darkvolg/BeehiveScale-ESP32/hardware/pinout.md

# BeehiveScale ESP32 — Полная распиновка

**Версия:** v5.0.15
**Плата:** ESP32-WROOM-32 DevKit V1 (38 пинов, USB-C, DOIT)
**Дата:** 2026-05-07

---

## 1. Сводная таблица ESP32 GPIO

Все занятые пины ESP32. Свободные не показаны.

| ESP32 пин | GPIO | Куда идёт | Сигнал | Тип | Цвет провода | Примечание |
|---|---|---|---|---|---|---|
| 25 | **GPIO16** | HX711 → DT | DATA in | digital | **жёлтый** | свободный, не strapping |
| 28 | **GPIO17** | HX711 → SCK | CLOCK out | digital | **зелёный** | свободный |
| 26 | **GPIO4** | DS18B20 → DATA | 1-Wire | digital | **белый** | + 4.7 kΩ pullup на 3.3V |
| 11 | **GPIO27** | Кнопка MAIN → IN | input pullup | digital | **синий** | RTC GPIO ⭐ (wake-by-button) |
| 10 | **GPIO26** | Кнопка MENU → IN | input pullup | digital | **голубой** | RTC GPIO |
| 33 | **GPIO21** | LCD SDA + DS3231 SDA | I²C SDA | I²C | **зелёный** | общая шина |
| 36 | **GPIO22** | LCD SCL + DS3231 SCL | I²C SCL | I²C | **жёлтый** | общая шина |
| 13 | **GPIO33** | DS3231 SQW *(опц.)* | wake input | digital | **фиолетовый** | RTC GPIO. Задел на фазу P3 — в прошивке v5.0.15 не задействован |
| 6 | **GPIO34** | Делитель батареи (midpoint) | ADC input | analog | **серый** | input only, ADC1_CH6 |
| 1 | **3V3** | HX711 VCC, DS3231 VCC, DS18B20 VCC, R-pullup | питание | 3.3V | **красный** | от LDO ESP32 (~600 мА запас) |
| 2 | **VIN** | вход 5V от AS21 V6.0 | питание | 5V | **оранжевый** | через AMS1117 → 3.3V LDO |
| 3 | **GND** (любой) | общая земля всех модулей | земля | GND | **чёрный** | минимум 2 GND-провода (один общий plane) |

> **Важно:** ESP32 DevKit V1 имеет несколько GND-пинов (4, 14, 32, 38). Используй ближайший к каждому модулю чтобы петли не плодились.

---

## 2. По-компонентно — куда что паять

### HX711 (Load Cell ADC, 3.3V)

| HX711 пин | Куда | Цвет провода | Примечание |
|---|---|---|---|
| **VCC** | ESP32 **3V3** | красный | потребляет ~1.5 мА |
| **GND** | ESP32 **GND** | чёрный | |
| **DT** (data) | ESP32 **GPIO16** | жёлтый | подтяжки не нужны |
| **SCK** (clock) | ESP32 **GPIO17** | зелёный | |
| **E+** | load cell **красный** | — | питание тензодатчика |
| **E−** | load cell **чёрный** | — | |
| **A+** | load cell **зелёный** | — | сигнал |
| **A−** | load cell **белый** | — | |

> Иногда тензодатчики имеют другие цвета (КНР). Проверь маркировку на коробке. На v3 датчиках типа TAL220: **красный/чёрный = питание (E+/E−), зелёный/белый = сигнал (A+/A−)**.

---

### LCD 16×2 I²C (PCF8574 backpack, 5V, адрес 0x27)

| LCD пин | Куда | Цвет провода | Примечание |
|---|---|---|---|
| **VCC** | ESP32 **VIN** (5V) | оранжевый | LCD требует 5V для подсветки |
| **GND** | ESP32 **GND** | чёрный | |
| **SDA** | ESP32 **GPIO21** | зелёный | общая I²C шина |
| **SCL** | ESP32 **GPIO22** | жёлтый | общая I²C шина |

> Если LCD не запускается на 5V (ESP32 GPIO 3.3V уровни) — скорее всего PCF8574 проглатывает 3.3V на SDA/SCL без проблем. Если есть глюки — поставь level shifter (2× MOSFET BSS138 с 10 kΩ pullup).

---

### DS3231 RTC (3.3V, адрес 0x68, общая I²C шина с LCD)

| DS3231 пин | Куда | Цвет провода | Примечание |
|---|---|---|---|
| **VCC** | ESP32 **3V3** | красный | НЕ 5V! Иначе модуль может попытаться зарядить CR2032 через диод (запрещено для не-перезаряжаемой батарейки) |
| **GND** | ESP32 **GND** | чёрный | |
| **SDA** | ESP32 **GPIO21** | зелёный | общая I²C шина с LCD |
| **SCL** | ESP32 **GPIO22** | жёлтый | общая I²C шина с LCD |
| **SQW** (INT) *(опц.)* | ESP32 **GPIO33** | фиолетовый | RTC alarm output. **Задел на P3** — wake by alarm, в v5.0.15 не используется. Паяй сейчас чтобы потом не перепаивать |
| 32K | NC | — | не используется |
| RST | NC | — | не используется |

> **Важно у Геннадия выпаян Power LED на DS3231** — иначе CR2032 садилась за неделю (LED жгла ~200 мкА постоянно).
> На модуле есть **R5 SMD-резистор** в цепи зарядки CR2032 (для Li-ion). Если у тебя обычная **не-перезаряжаемая** CR2032 — выпаяй R5 (или диод) чтобы не было тока заряда. Проверь перед запайкой — если шёлкография говорит «D1» с диодом перед батарейкой, удалить.

---

### DS18B20 (Temperature Sensor, TO-92, 1-Wire, 3.3V)

| DS18B20 пин (вид на маркировку) | Куда | Цвет провода | Примечание |
|---|---|---|---|
| **1 — GND** (левый) | ESP32 **GND** | чёрный | |
| **2 — DATA** (центр) | ESP32 **GPIO4** | белый | + 4.7 kΩ pullup на 3.3V (обязательно!) |
| **3 — VCC** (правый) | ESP32 **3V3** | красный | |

> **Распиновка** (TO-92 плоской стороной к себе, ножки вниз):
> - Левая = GND
> - Средняя = DATA
> - Правая = VCC
>
> **Pullup-резистор 4.7 kΩ** обязателен между DATA и VCC. Без него датчик не отвечает.
>
> Если кабель к датчику длинный (>1м, например в улье) — ставь pullup ближе к датчику, не к ESP32.

---

### Кнопки тактовые (2 шт, 6×6 мм)

Подключение по схеме «GPIO → кнопка → GND», внутренний pullup в ESP32 включён программно.

| Кнопка | GPIO | Цвет провода | Тип | Длительности (v5.0.15) |
|---|---|---|---|---|
| **MAIN** | **GPIO27** | синий | RTC GPIO ⭐ | SHORT=ничего, MEDIUM 3.0s = ТАРА, LONG 6.0s = КАЛИБРОВКА |
| **MENU** | **GPIO26** | голубой | RTC GPIO | SHORT=меню next, LONG 2.5s = меню OK/back |

```
   ESP32 GPIO27 ──┐
                  │
              [BTN MAIN]
                  │
   ESP32 GND   ──┘
```

> **Кнопка MAIN на GPIO27 = RTC GPIO** — поэтому она будит ESP из deep sleep (через `esp_sleep_enable_ext0_wakeup`).
> **Без анти-дребезга** на железе — программная фильтрация в `Button.cpp` (debounce 30 мс через ISR).

---

### Делитель напряжения батареи (для мониторинга 18650)

```
   BAT+ (raw 18650, 3.0–4.2V) ──┬── R1 (100 kΩ)
                                │
                                ├── ESP32 GPIO34 (ADC)
                                │
                                ├── R2 (100 kΩ)
                                │
                                └── GND
```

| Компонент | Значение | Куда |
|---|---|---|
| **R1** | 100 kΩ (1%, 0805 SMD или TH 1/4W) | BAT+ → midpoint |
| **R2** | 100 kΩ (1%, 0805 SMD или TH 1/4W) | midpoint → GND |
| midpoint | — | ESP32 **GPIO34** |

> **Деление 1:1** (4.2V → 2.1V на пине, в пределах ADC1 ESP32 при `ADC_11db` attenuation = 0–3.3V).
> **Ток утечки делителя:** 4.2V / 200kΩ = **21 мкА постоянно**. Заметно для deep sleep, но ОК.
> Если хочешь убрать утечку в sleep — можно поставить P-MOSFET (но мы вычеркнули его).

---

### AS21 V6.0 — питание (TP4056 + Boost 5V + 18650 holder)

Это **внешний модуль**, не на основной плате. Соединяется 3-проводным разъёмом (или 4 если с BAT+).

| AS21 выход | Куда на основной плате | Цвет провода | Примечание |
|---|---|---|---|
| **5V_OUT** | ESP32 **VIN** | оранжевый | 5V после boost-преобразователя |
| **GND** | ESP32 **GND** | чёрный | общая земля |
| **BAT+** (raw 18650) | вход делителя R1+R2 | красный | прямое напряжение банки 3.0–4.2V (для ADC мониторинга) |

> AS21 V6.0 имеет:
> - TP4056 для зарядки от microUSB
> - DW01 protection IC (over-discharge / over-current)
> - Boost step-up 5V (для питания LCD)
> - Held 18650 (контактные пружины)
>
> **Микро-USB модуля AS21** = вход для зарядки 18650. **USB-C на ESP32 DevKit** = вход для прошивки/отладки. Эти два USB **независимы** — можно подключать оба одновременно.

---

## 3. Питание — кто откуда берёт

```
                              ┌── 5V → LCD VCC
                              │
   AS21 5V_OUT ──→ ESP32 VIN ─┤
                              │
                              └── ESP32 internal AMS1117 LDO ──→ 3.3V
                                                                    │
                                                                    ├── HX711 VCC
                                                                    ├── DS3231 VCC
                                                                    ├── DS18B20 VCC
                                                                    └── 4.7kΩ pullup на DATA

   AS21 BAT+ ──→ R1 (100k) ──→ midpoint → ESP32 GPIO34 (ADC)
                                  │
                                  └── R2 (100k) → GND
```

**Потребление по току (актуально на 2026-05-07):**

| Состояние | Ток | Примечание |
|---|---|---|
| ESP32 active + WiFi | 80–90 мА | при отправке Telegram |
| ESP32 active + WiFi idle | 30–50 мА | дашборд открыт |
| LCD backlight + LCD логика | ~30 мА | постоянно когда плата работает |
| HX711 active | ~1.5 мА | |
| DS3231 (без LED) | ~110 мкА | от батарейки CR2032 в основном |
| DS18B20 active | ~1 мА (read) / 1 мкА idle | |
| **Всего active** | **~120–140 мА** | через AS21 boost |
| **Deep sleep (с AMS1117)** | **~7 мА** | замерено мультиметром |
| Deep sleep (после HT7333) | ~3 мА | ожидаемо после замены |

---

## 4. ⚠️ ЗАПРЕЩЁННЫЕ пины ESP32

**НЕ ИСПОЛЬЗУЙ**:

| GPIO | Почему |
|---|---|
| 6, 7, 8, 9, 10, 11 | внутренняя SPI flash ESP32 — НИКОГДА (плата перестанет загружаться) |
| 0, 2, 12, 15 | strapping pins — осторожно, могут влиять на boot. Можно использовать но не для постоянных нагрузок (например подтяжек к VCC). |
| 1 (TX0), 3 (RX0) | UART0 — занят USB-сериал. Если паяешь TX/RX наружу для отладки — будет конфликт |
| 34, 35, 36, 39 | input only — нельзя использовать как output |

**ПОЛНОСТЬЮ СВОБОДНЫЕ (для будущих расширений):**
- GPIO 5, 13, 14, 18, 19, 23, 25, 32

---

## 5. Рекомендуемая последовательность пайки (от центра к краям)

1. **Сначала** — ESP32 на DIP-сокете (2×19 pin female, snap-off). Не паять модуль напрямую — иначе на отладке намучаешься.
2. **Питание** — AS21 разъём, 5V→VIN, GND→GND. Проверь мультиметром: на VIN должно быть ~5V, на 3V3 — 3.3V.
3. **Делитель батареи** — R1+R2, midpoint к GPIO34. Проверь напряжение: при 18650=4.0V на пине должно быть 2.0V.
4. **HX711** — короткие провода, лучше скруткой. После пайки запусти прошивку и проверь сырые показания через `/api/data` (поле `weight`).
5. **LCD I²C** — VCC=5V, GND, SDA, SCL. Подсветка должна включиться сразу. Если контраст плохой — крути потенциометр на backpack.
6. **DS3231** — на ту же I²C шину. Проверь через `/api/data` (поле `datetime` показывает время).
7. **DS18B20** — обязательно с 4.7 kΩ pullup. Проверь через `/api/data` (поле `temp`).
8. **Кнопки** — GPIO к одному контакту, GND к другому. Полярность не важна.

**После каждого шага — прошивай и тестируй**, не оставляй непроверенные соединения.

---

## 6. Полезные мнемоники

- **MAIN на GPIO27**: запомни «**M**AIN — **2 7**» (две семёрки). Это RTC GPIO, поэтому он и будит из сна.
- **HX711 на 16/17**: пара рядом, как I²C-шина (21/22).
- **I²C — это G21/G22**: жёлтый (SCL) выше зелёного (SDA) физически на ESP32 DevKit.
- **DS18B20 — белый провод**: 1-Wire = 1 провод данных = белый. Питание красное, GND чёрный — стандарт.

---

## 7. Что заказать дополнительно (если ещё не куплено)

- [ ] DIP-сокет 2×19 (snap-off можно от 2×20) — ~30 ₽
- [ ] Резисторы 100 kΩ ×2 (1%, 1/4W) — копейки
- [ ] Резистор 4.7 kΩ ×1 — копейки
- [ ] Тактовые кнопки 6×6 мм ×2 — копейки
- [ ] Female pin headers под LCD/HX711/DS3231 — на «съёмные» модули
- [ ] **HT7333 LDO** (SOT-89) — для замены AMS1117. Заказан, придёт ~9 мая.
- [ ] Корпус IP65 ~85×65×30 мм
- [ ] 18650 банка 3000+ мА·ч (если ещё нет)

---

**Файлы по теме:**
- [pcb_layout_v1.excalidraw](pcb_layout_v1.excalidraw) — визуальный layout платы
- `BeehiveScale/Connectivity.h` / `BeehiveScale/Memory.h` — defines в коде

**Дата актуализации:** 2026-05-07 (после v5.0.15)
