darkvolg/BeehiveScale-ESP32/ACTION_PLAN.md

# BeehiveScale — План восстановления (2026-05)

**Цель:** довести весы до рабочего состояния и поставить в улей.
**Заказчик:** Геннадий Якубовский (пасека на 11 ульев).
**Текущая боль:** весы постоянно показывают неправильный вес, плохо калибруются, лежат на полке.

---

## START HERE — приоритеты

### 🔴 ФАЗА 1 (P0) — Восстановление точности веса
**Почему P0:** без правильного веса всё остальное бессмысленно. Корневая причина — пины HX711 (GPIO16/GPIO1 неправильные, нужно D5/D6) **+ как выяснилось 2026-05-03 — HX711 модуль умер**.

- [x] Найдена корневая причина — пины HX711 на boot-strap GPIO + отсутствие pull-up на GPIO16
- [x] Сравнение с эталоном Bee_Lite_D1 (Як Иваныч) — у него HX711 на D5/D6, работает
- [x] Веб-исследование — стандартная распиновка HX711+ESP8266 = D5/D6
- [x] Правки в коде v4.2.1: DT_PIN=14, SCK_PIN=12, упрощён Scale.cpp, удалены костыли
- [x] SD-карта отключена, логи в LittleFS (D5/D6/D7/D8 освобождены от SPI)
- [x] LOG_INTERVAL_MS = 30 мин (fallback) + расписание через веб
- [x] Сборка прошла: RAM 46%, IRAM 95%, Flash 56%
- [x] Геннадий переключил коннекторы HX711 на D5/D6
- [x] Геннадий прошил v4.2.1 → v4.2.2 → v4.2.3
- [x] **2026-05-03: Диагностика — HX711 модуль не реагирует на нагрузку** (90 кг → 0 реакции). Воспроизведено на 2 распиновках (D5/D6 и D0/TX) и 2 разных тензодатчиках. Вывод: **HX711 модуль мёртв**, нужна замена.
- [x] 🛒 **Геннадий: купить новый HX711 модуль** (50-150₽, любой Озон/Ali/радиорынок) — 2026-05-04 куплен
- [x] (опционально) подтвердить мультиметром: E+ к E- должно быть ~3.3В, у мёртвого 0В — пропущено, сразу замена
- [x] Установить новый HX711, провода: 3V3→VCC, GND→GND, DT→D5, SCK→D6 — 2026-05-04
- [x] Прошить финальную v4.2.3 (LEGACY_HX711_PINS должен быть выключен) — 2026-05-04
- [x] Калибровка 1 кг через меню — 2026-05-04 ОК, весы работают
- [ ] **Геннадий: настроить расписание через веб** (например `21:00`)
- [ ] Тест T1: стабильность в покое 30 мин — разброс < 50 г
- [ ] Тест T2: повторяемость калибровки на 1 кг гире 5 раз с reboot — отклонение < 5%
- [ ] Тест T3: линейность 0.5 / 2 / 5 кг — точность 2%
- [ ] Калибровка финальная под реальный груз улья (можно использовать гирю до 50 кг)

**Завершение Фазы 1:** все три теста PASS → весы можно ставить в улей с питанием от блока 5В.

---

### 🟡 ФАЗА 2 (P1) — Автономия от 18650 (DEEP_SLEEP) — 🚫 БЛОКЕР
**Почему P1:** без автономии весы в улье требуют сетевого питания, что не везде возможно.

**🚫 СТАТУС 2026-05-05: ЗАСТРЯЛИ.** ESP не просыпается из deep sleep ни через GPIO16 timer wake, ни через DS3231 alarm. Все стандартные подходы (диод, прямой провод, 100нФ cap) исчерпаны.

**Что подтверждено как работающее:**
- ✅ Код v4.2.12 уходит в deep sleep корректно
- ✅ DS3231 alarm срабатывает (A1F=1, SQW падает 4.8В→0В) — проверено мультиметром и AlarmCheck скетчем
- ✅ Электрические соединения целы (мультиметр звонится)

**Что НЕ работает:**
- ❌ GPIO16 → RST: ESP не просыпается даже от внутреннего timer wake (минимальный WakeTest скетч застревает на Wake #1)
- ❌ SQW → RST: с прямым проводом / диодом / cap 100nF — ESP не реагирует на алярм-сигнал

**Идеи для возобновления (см. memory/lightrag для деталей):**
- [ ] Попробовать новый NodeMCU (Геннадий готов поменять)
- [ ] MOSFET power gating: P-channel MOSFET на VCC ESP, gate от SQW. ESP включается «с нуля» по будильнику, без RST
- [ ] Schottky диод 1N5819 + 100нФ cap параллельно (edge-trigger)
- [ ] Перейти на ESP32 (wake-on-EXT надёжнее)
- [ ] Web search «DS3231 wake ESP8266 deepSleep(0) 100nF» — проверенные схемы

**Замороженные пункты Фазы 2 (после разблокировки):**
- [ ] Кнопка пробуждения: использовать встроенную кнопку RST на NodeMCU
- [ ] (Опционально) MOSFET P-channel для отключения LCD power 5В во сне
- [ ] Замер реального потребления в спячке (ожидаем ~0.15 мА средний)
- [ ] Тест автономии: 18650 на ~3 суток наблюдения, проверить что лог пишется в 21:00 и весы доживают

**Завершение Фазы 2:** весы работают от 18650 без сети, лог пишется раз в день.

---

### 🟢 ФАЗА 3 (P2) — Солнечная панель + длительная автономия
**Почему P2:** даёт постоянную работу без обслуживания.

- [ ] Купить солнечную панель 5W 6V (стандартная для IoT)
- [ ] Купить контроллер заряда CN3791 (MPPT для Li-Ion) или TP4056 (попроще)
- [ ] Собрать схему: панель → CN3791 → 18650 → DC-DC 5В → ESP
- [ ] Поставить в улей, наблюдать 2 недели — заряд не должен падать
- [ ] (Опционально) DS3231 alarm как wake-источник: SQW/INT → RST через диод, тогда сон сутками целиком, не часовыми кусками. ~50 строк кода. Среднее потребление падает в 30 раз.
- [ ] (Опционально) Вернуться в `SLEEP_MODE_CONTINUOUS` если панель достаточная (5W × 4ч = 20 Wh покрывает 80 мА × 24ч)

**Завершение Фазы 3:** ставишь и забываешь, веб всегда доступен (если CONTINUOUS).

---

### ⚪ ФАЗА 4 (P3) — Расширение пасеки
**Почему P3:** «нужно повторить для всех ульев».

- [ ] Собрать вторые весы по этой же схеме (для второго улья)
- [ ] Добавить в Telegram бот сводный отчёт по всем весам
- [ ] (Опционально) MQTT интеграция с Home Assistant
- [ ] Документация для повторной сборки (BOM + инструкция по пайке)

---

## 📌 Распиновка ESP8266 NodeMCU / D1 mini ПОСЛЕ перепайки

**Важно:** на плате есть подписи D0..D8 (silkscreen) и GPIO-номера. В коде используются GPIO-номера, на плате надо смотреть метки D-N.

| Пин платы | GPIO | К чему подключить | Примечание |
|---|---|---|---|
| **D5** | GPIO14 | **HX711 → DT (DOUT)** | Был на D0 — переткнуть в D5 |
| **D6** | GPIO12 | **HX711 → SCK** | Был на TX — переткнуть в D6 |
| **3V3** | — | HX711 → VCC | Уже подключено, не трогать |
| **GND** | — | HX711 → GND | Уже подключено, не трогать |
| D1 | GPIO5 | I2C SCL → LCD 1602, RTC DS3231 | Не трогать |
| D2 | GPIO4 | I2C SDA → LCD 1602, RTC DS3231 | Не трогать |
| D3 | GPIO0 | Кнопка главная (тарирование/калибровка) → GND через кнопку | Не держать при включении! |
| D4 | GPIO2 | Кнопка меню → GND через кнопку | Не держать при включении! |
| D9 / RX | GPIO3 | DS18B20 термометр (с резистором 4.7к на VCC) | Не трогать |
| TX | GPIO1 | Свободен — Serial debug (115200) | Можно подключить USB-TTL для логов |
| D7 | GPIO13 | Свободен | (был SD MOSI) |
| D8 | GPIO15 | Свободен (или можно для будущих расширений) | (был SD CS) |
| **D0** | GPIO16 | Свободен (для Фазы 2 — перемычка к RST через диод) | (была HX711 DT — снять провод!) |
| A0 | ADC0 | Делитель напряжения батареи через резисторы | Не трогать |

### SD-карта
**Отключаем.** Физически модуль можно оставить на коннекторе — он не будет использоваться. Освобождает D5/D6/D7/D8 для HX711 и будущих расширений. Логи теперь во внутренний flash ESP (LittleFS) — на годы хватит.

---

## 📋 Чек-лист перед прошивкой

1. [ ] **Снять провод HX711 DT с D0**, переткнуть в **D5**
2. [ ] **Снять провод HX711 SCK с TX**, переткнуть в **D6**
3. [ ] **VCC и GND HX711 не трогать**
4. [ ] SD-модуль можно отсоединить (не обязательно)
5. [ ] Питание подать от блока 5В через USB (для тестов, до Фазы 2)
6. [ ] В Arduino IDE:
   - Tools → Board: **LOLIN(WEMOS) D1 R2 & mini** (или твоя)
   - Tools → Flash Size: **4MB (FS:2MB OTA:~512KB)**
   - Tools → Erase Flash: **All Flash Contents** (один раз — чтобы старая FAT не мешала)
7. [ ] Прошить, дождаться boot
8. [ ] LCD должна показать splash «Vesy Pchelovod / Versiya 4.2.1»

---

## 📊 Лог выполнения

| Дата | Этап | Что сделано | Кто | Коммит |
|---|---|---|---|---|
| 2026-05-03 | P0.1 | Найдена корневая причина (пины), сравнение с Як Иванычем | Claude + agent | — |
| 2026-05-03 | P0.2 | Правки v4.2.1: HX711 на D5/D6, SD off, упрощён Scale.cpp | Claude | (не закоммичено) |
| 2026-05-03 | P0.3 | Сборка прошла, RAM 46%/IRAM 95%/Flash 56% | Claude | — |
| 2026-05-03 | P0.4 | Создан ACTION_PLAN.md с поэтапным планом | Claude | — |
| 2026-05-04 | P0.5 | Геннадий купил новый HX711, поставил, прошил v4.2.3, откалибровал на 1 кг — весы работают | Геннадий | — |
| 2026-05-05 | P1.1 | Код v4.2.10-12: LEGACY_HX711_PINS off, lcd.backlight() в check_auto_sleep, cap 70 мин на ESP8266 deepSleep | Claude | — |
| 2026-05-05 | P1.2 | ЗАСТРЯЛИ: GPIO16 wake-функция ESP8266 не работает на этой плате (электрически провода целы, мультиметр звонится). Переход на DS3231 alarm wake. | Claude+Геннадий | — |
| 2026-05-05 | P1.3 | DS3231 alarm логика подтверждена: A1F ставится в 1, SQW падает 4.8В→0В. Тесты с прямым проводом / диодом 1N4148 / 100нФ конденсатором — НИЧЕГО не будит ESP. Сессия прервана из-за выгорания. | Геннадий | — |

---

## 🚫 НЕ ТРОГАТЬ (железные правила проекта)

1. **HX711 на D5/D6** — это финальное решение. Не возвращать на D0/TX даже если кто-то скажет «там же боль с SD».
2. **I2C на D1/D2** — LCD и RTC DS3231 на одной шине, не трогать.
3. **DS18B20 на GPIO3 (RX)** — историческая распиновка, конфликта с UART RX нет (pinMode INPUT отвязывает мульти-pin).
4. **Калибровочный груз** — для лучшей точности использовать груз близкий к рабочему весу улья (10-30 кг). Минимум 1 кг гиря.
5. **Не калибровать в улье** — пчёлы летают, шум вибрации. Калибровка в гараже на ровной поверхности.
6. **EEPROM offset/cf не редактировать вручную** — только через UI калибровки или веб.
7. **SD-карта может остаться физически** — но в коде `USE_SD_CARD` закомментирован, не возвращать без очень веской причины (потеря D5/D6 для HX711).
8. **При прошивке через USB** — после перепайки GPIO16→RST (Фаза 2) убедиться что диод стоит правильно (катод к RST), иначе DTR-reset не сработает.

---

## 🔗 Ссылки

- Аудит-отчёт: [docs/reports/weight-bug-audit.md](docs/reports/weight-bug-audit.md)
- Эталон сравнения: `c:/Users/Dark/Desktop/Проекты/Весы_Як_Иваныч/firmware/Bee_Lite_D1_v1.1-1000gr.ino`
- CHANGELOG: [CHANGELOG.md](CHANGELOG.md)
- Distinguishing Pinout ESP8266: https://randomnerdtutorials.com/esp8266-pinout-reference-gpios/
- HX711 + ESP8266 туториал: https://randomnerdtutorials.com/esp8266-load-cell-hx711/
