darkvolg/BeehiveScale-ESP32/memory/project_current_state.md

---
name: project_current_state
description: BeehiveScale-ESP32 текущая версия v5.0.24 и работающие фичи на 2026-05-17
metadata:
  type: project
---

# BeehiveScale ESP32 — текущее состояние

**Версия:** v5.0.24 (2026-05-17)
**Статус:** работает на макетной сборке, корпус собран, тестируется wake-up из deep sleep
**Главный блокер:** ждём детали (1N5819, AO3401, Type-C female) для солнечной зарядки и P-MOSFET LCD

**Why:** проект для пасеки Геннадия — автономные весы которые шлют отчёты в Telegram. Тяжело пробираться через каждое железное решение — каждое прошитие через USB, не разбирая корпуса.

**How to apply:** при заходе в проект сразу читай это + project_session_2026-05-17.md чтобы понять что было сделано последнее. Не предлагай разборку корпуса — Геннадий устал. Прошивки только через USB-C.

## Железо у Геннадия (собрано в корпусе)

| Компонент | Что |
|---|---|
| MCU | ESP32-WROOM-32 DevKit V1 |
| LDO | **HT7333** (заменён AMS1117, -5 мА в sleep) |
| Boost | **MT3608** настроен на 5.0В (заменил сгоревший AS21) |
| Банка | 21700 4500 мА·ч |
| Зарядка | TP4056 + DW01 |
| Делитель | R1+R2 100k → GPIO34 (откалиброван через сайт, ratio ~2.124) |
| HX711 | + pull-up 10к на SCK (D17) → 3V3 (обязательно для sleep!) |
| LCD | 1602 I²C PCF8574 (адрес 0x27) |
| RTC | DS3231 на **3V3** (не 5В!) |
| Темп | DS18B20 + 4.7к pullup |
| Кнопки | MAIN (D27, RTC GPIO) + MENU (D26) |
| LED | **все выпаяны** (ESP32 ×2 + DS3231 ×2 + TP4056 ×2) |

## Замеры на железе

- Active: ~120 мА
- Deep sleep: **6 мА**
- Cal. Factor HX711: 20534
- Реальное напряжение батареи 4.10В (мультиметр) — откалибровано через сайт
- Автономия 21700: ~22 дня без подзарядки

## Что работает

✅ Wake по расписанию (после v5.0.24 фикса WiFi reset)
✅ Telegram отчёты через Cloudflare Worker (beehive-relay.darkvolg.workers.dev)
✅ Web-панель (192.168.0.58 в STA на Beeline роутер)
✅ Архив с маркерами аномалий + PWA
✅ Калибровка батареи через сайт (v5.0.19) — endpoint /api/battery/calib
✅ Настраиваемые Telegram-алерты (v5.0.20): батарея/температура/RTC — endpoint /api/alerts
✅ NTP отключён, DS3231 даёт время сам
✅ Pull-up SCK HX711 — HX711 в power_down полноценно (~1 мкА)
✅ Logo PCB-пчела (PWA-иконка обновлена в v5.0.18)

## Что НЕ работает / TODO (приоритет сверху)

1. **Тест v5.0.24 на стабильность** — wake-up из deep sleep исправлен, но нужен 1-2 дня наблюдений
2. **Солнечная зарядка** — ждёт детали (1N5819 Шоттки, Type-C female bulkhead)
3. **P-MOSFET для LCD off в sleep** — ждёт AO3401 (BC547 у Геннадия есть). Даст +20 дней автономии (до 44)
4. **NTP sync переписать** на esp_sntp_init() — Core 3.0.7 баг в configTime/getLocalTime
5. **Корпус IP65** — пока макетная сборка
6. **В улей** — финальный шаг

## Что Геннадий заказал

- 1N5819 (TH) + SS14 (SMD) — диоды Шоттки для солнечной панели
- AO3401 (P-MOSFET SOT-23) для P-MOSFET LCD off
- Type-C female bulkhead разъём для корпуса

Доставка 3-7 дней с Озона.

## Solar panel параметры

TZT solar panel 5В / 200мА / 1Вт (107×61мм). Подключение по схеме:
```
Panel → провод → Type-C male
              → Type-C female на корпусе
              → 1N5819 (полоска к TP4056)
              → 470µF параллельно
              → TP4056 VIN (через VBUS pin Type-C)
```

Расчёт: летом ~750-900 мА·ч/день в банку, при расходе 200 мА·ч/день → прибыль ~600 мА·ч/день. В улей с панелью — поставить и забыть на сезон.

## GitHub

- Репо публичный: github.com/darkvolg/BeehiveScale-ESP32
- 15 topics
- Логотип PCB-пчела
- Social preview banner работает (1280×640 JPG)
- README двуязычный (RU основной + EN)

## Контакты

- Wi-Fi: Beeline (домашний), pass 9044355157
- IP в локалке: 192.168.0.58
- Cloudflare Worker secret: см. BeehiveScale/secrets.h (в .gitignore)
- Telegram bot — настроен на сайте, токен в EEPROM
