darkvolg/BeehiveScale-ESP32/memory/project_session_2026_09_11.md

---
name: project-session-2026-09-11
description: "Сессия 11.09.2026 — v5.0.69 (Excel с подсветкой из весов), автономность измерена (~50 дней), разобран перехват vesy.local роутером."
metadata: 
  node_type: memory
  type: project
  originSessionId: c1eec2fc-7866-4577-82ce-6a91bddad48f
  modified: 2026-09-11T19:59:35.419Z
---

# Сессия 11.09.2026 — что сделано

Весы на момент начала: v5.0.66 → юзер прошил v5.0.68 → в конце сессии выпущена **v5.0.69** (прошивает сейчас).
IP весов: **192.168.0.4**. «Причина старта: POWERON» — боот-лупа нет, августовская проблема закрыта.

## 1. v5.0.69 — «Excel с подсветкой» прямо из весов (коммит 915053d, тег v5.0.69)

**Почему:** сначала сделали скрипт `tools/csv_to_xlsx.py`, но юзер верно заметил — скрипт живёт на одном компьютере, с другого ноутбука снова придёт безликий CSV. Значит раскраска должна быть **в прошивке**.

**Как:** `GET /api/log/xls?from=&to=` (`Logger.cpp: log_stream_xls_range()`) стримит HTML-таблицу с инлайн-стилями под именем `beehive_<период>.xls`. Excel/LibreOffice открывают как книгу и сохраняют заливку. Кнопка — вкладка Архив, блок «⬇ Скачать».

Раскраска: вес жёлтой заливкой; **новая колонка «Изм., кг»** (рост зелёным, падение красным, порог 0.05); температура 5 ступеней (<10 синяя … >35 красная); батарея зелёная >80%, жёлтая <50%, **красная ниже 3.6 В**; **новая колонка «Заряд, %»** по кривой из `Battery.cpp:53-59`.

**Компромисс:** настоящий XLSX (zip+XML) на ESP32 не собрать без heap → Excel показывает «формат не соответствует расширению», надо нажать «Да». Написано под кнопкой и в manual.html.

**Грабли при разработке:** генерация C++ кода через bash heredoc съедала escape-последовательности — `\n` внутри строкового литерала превращался в реальный перевод строки, `'\0'` в NUL-байт. Лечится записью скрипта файлом (Write) вместо heredoc. См. [[feedback-heredoc-escapes]].

## 2. Автономность — измерена, а не посчитана

Выгрузка 15.08 → 11.09.2026 (26 дней, расписание 08:00/14:00/21:00):
**4.18 В (99%) → 3.77 В (49%)** = 50% за 26 дней = **1.9% в сутки → полный цикл ~50 дней**.

Это **втрое больше** расчётных 17–19 дней. Реальное потребление в простое ~3.5 мА, а не 7 мА. Цифры в manual.html приведены к измеренным, расчёт оставлен помеченным как пессимистичный. Коммит 98b2a95.

Заряжать раз в полтора месяца. На 11.09 был 41% → хватит до начала октября.

## 3. Почему не открывался vesy.local (важно, повторится)

Симптом: `http://vesy.local` → **HTTP ERROR 503**, по IP всё работает.

Две причины, обе на компьютере юзера, весы ни при чём:
1. **Системный прокси** `127.0.0.1:10801` (xraycore / v2RayTun). В исключениях стояло `<local>` — а это в Windows «имена **без точек**». `vesy.local` содержит точку → уходил в прокси → 503. **Исправлено:** `ProxyOverride` = `<local>;127.0.0.1;localhost;*.local;192.168.*` (старое значение: `<local>;127.0.0.1;localhost`).
2. **Роутер 192.168.0.1 сам отвечает `127.0.0.200`** на любое имя с `.local` — его заглушка-блокировщик. Windows получает DNS-ответ и до mDNS дело не доходит. **Не исправлено** — нужна либо резервация DHCP + заход по IP, либо строка в `hosts`: `192.168.0.4 vesy.local`.

Плюс весы почти всегда спят (power-cut), в ARP их нет — достучаться можно только в окно 08:00/14:00/21:00 или нажав SW2.

## 4. v5.0.70 — кнопка «Весь лог CSV» не работала вообще (коммит cd6b024)

Симптом: `/api/log` без параметров → `500 Cannot open log`. Выгрузка за период работала — эта разница и указала на причину.

Веб-слой открывал файл сам: `f = LOG_FS.open(LOG_FILE, "r")`. Макрос **`LOG_FS` на ESP32 указывал на SPIFFS**, а лог пишется в **LittleFS** (`Logger.cpp: _fs_open_read()`). Остаток от времён, когда на ESP32 была SPIFFS. Файла там нет → открытие падало всегда.

Исправлено: полная выгрузка идёт через `log_stream_csv_range(cs, "", "")`, как и остальные. Макрос `LOG_FS` удалён — веб-слой больше не лезет в ФС напрямую.

**Урок:** если один путь выгрузки работает, а другой нет — сравнивать не данные, а **через какой слой** каждый идёт.

## 5. vesy.local — ПОЧИНЕНО

Обе причины устранены:
1. `ProxyOverride` = `<local>;127.0.0.1;localhost;*.local;192.168.*` (было без `*.local` — а `<local>` в Windows значит «имена без точек»).
2. В `hosts` добавлено `192.168.0.4 vesy.local` — обходит заглушку роутера (`192.168.0.1` отвечает `127.0.0.200` на любое `.local`).

Проверено: `http://vesy.local/api/data` → **401** (ответили сами весы, там basic-auth) — значит имя доходит.

**Важно:** hosts прибивает IP гвоздями. Если DHCP выдаст весам другой адрес — перестанет работать. Правильное решение на будущее — **резервация IP в роутере**. Скрипт для обновления записи: `scratchpad/add_hosts.ps1` (запускать от админа, он же обновит IP если имя уже есть).

**На другом ноутбуке `vesy.local` работать не будет** — правка локальная. Там либо тот же hosts, либо заход по IP.

## 6. Excel с подсветкой — проверено на живых данных

Юзер скачал `beehive_2026-09-05_2026-09-11.xls` с весов: предупреждение Excel → «Да» → таблица открылась раскрашенной. Вес жирным на жёлтом, изменения зелёным/красным (−0,36 / +0,13), температура градиентом, батарея с процентами. Работает как задумано.

## 7. v5.0.71 — Excel стал книгой из трёх листов (тег v5.0.71)

Юзер заметил: скрипт делал 4 листа, а весы отдавали 1. HTML-формат иначе не умеет — Excel хранит в нём каждый лист **отдельным файлом**.

Формат сменён на **SpreadsheetML 2003** (XML): несколько листов в одном файле, стили, заливки, числовые форматы — и всё это обычной печатью в поток, без библиотек. `Logger.cpp: log_stream_xlsxml_range()`.

Листы: **Сводка** (период, вес, температура, батарея, расход заряда в сутки, остаток дней, полный цикл), **Замеры** (прежняя раскраска + закрепление шапки), **По дням** (привес за сутки, мин/макс).

Собирается за **три прохода** по логу: статистику для «Сводки» надо знать до записи первого листа; «По дням» группируется на лету, потому что строки идут по возрастанию даты.

Тонкость: значения «Сводки» — строки, локаль Excel к ним не применяется, поэтому точка меняется на запятую вручную (`_ru_dec()`).

**Графиков нет** — SpreadsheetML диаграммы не поддерживает. Они остаются только в `tools/csv_to_xlsx.py`.

**Как проверялось без прошивки:** сгенерирован такой же XML на Python по реальной выгрузке + искусственные крайние случаи (мороз −5.4 °C, жара +41 °C, разряд 3.38 В), затем файл открыт **настоящим Excel через COM** (`New-Object -ComObject Excel.Application`, `Visible=$false`) и проверены имена листов, число строк и коды заливок. Приём годный для любой будущей выгрузки — см. `scratchpad/gen_xlsxml_preview.py`.

## Открытые хвосты (на конец сессии)
- **Прошить v5.0.71** — юзер прошил v5.0.69, потом вышли v5.0.70 и v5.0.71.
- `hosts` прибивает IP гвоздями → сделать **резервацию IP в роутере**. На других компьютерах `vesy.local` не работает.
- Порог алерта батареи 3.6 В — проверить глазами на вкладке TELEGRAM.
- Вариант питания (AS21 vs TP4056+MT3608) — [[project-open-question-power-variant]].
- HT7333 вместо AMS1117 — не поставлен.
