darkvolg/BeehiveScale-ESP32/memory/user_profile.md

---
name: user_profile
description: Геннадий — пчеловод-владелец BeehiveScale-ESP32, как с ним работать
type: user
---

# Геннадий

- **Email:** darkvolg86@gmail.com
- **GitHub:** darkvolg
- **Роль:** пчеловод-любитель, владелец пасеки. Сам собирает/прошивает железо, но не программист — нужно объяснять решения простым языком.
- **Уровень технический:** умеет паять, читать схемы, прошивать через Arduino IDE / PlatformIO. Понимает что такое EEPROM, Wi-Fi, MQTT — на уровне пользователя. Не пишет код сам, но грамотно ставит задачи и задаёт правильные вопросы.

## Контекст работы
- **Удалённая пасека:** уезжает на 3-7+ дней. Связь с пасекой может быть, может не быть. Если есть — раздаёт интернет с телефона.
- **Основное устройство в полевых условиях:** ТЕЛЕФОН. Не ноутбук. Всё что делается — должно быть удобно с экрана 6".
- **На ПК:** дома, обычно для прошивки и просмотра логов в Excel.

## Стиль общения
- Говорит много, длинными фразами, иногда мысли вслух — выводит идеи как разговор. Не торопить с уточнениями, дать договорить.
- Любит "пока для примера" формулировки — это значит "обсуждаем как идею, не сразу делать".
- Ценит когда предлагаешь варианты ДО реализации, объясняешь плюсы/минусы, рекомендуешь оптимальный с обоснованием.
- НЕ любит когда говоришь "сделаю как считаешь нужным" — хочет видеть твою рекомендацию ("советую вариант 1, потому что X").
- Когда говорит "поехали" / "давай" — это команда начать реализацию.

## Что Геннадий ценит в работе
- Простота развёртывания: одно-двухкнопочные операции
- Иконка на телефоне (PWA) — субъективно "как настоящее приложение" важнее облачных функций
- Понятные русские названия в UI (никаких "Δ from baseline" — пиши "От зафиксированной точки")
- Эмодзи в UI и в сообщениях — норм, помогают визуально
- Меньше настроек > больше: переиспользуем существующие пороги (alert_delta) вместо новых

## Что НЕ делать
- ~~Не лезть в manual.html / pages/*.html~~ — **отменено 16.08.2026**: юзер сам попросил сверить инструкцию с прошивкой, а потом слить всё в один файл. Документацию теперь ведём мы. `pages/` удалён, единственный источник — `manual.html` (12 вкладок). `hardware/pinout.md` — по-прежнему его, без спроса не трогать.
- Не предлагать сложные облачные архитектуры без явного запроса
- Не делать нативное iOS/Android приложение — PWA достаточно, обсудили и закрыли тему
