darkvolg/BeehiveScale-ESP32/docs/assets/bee-scale-cartoon.png

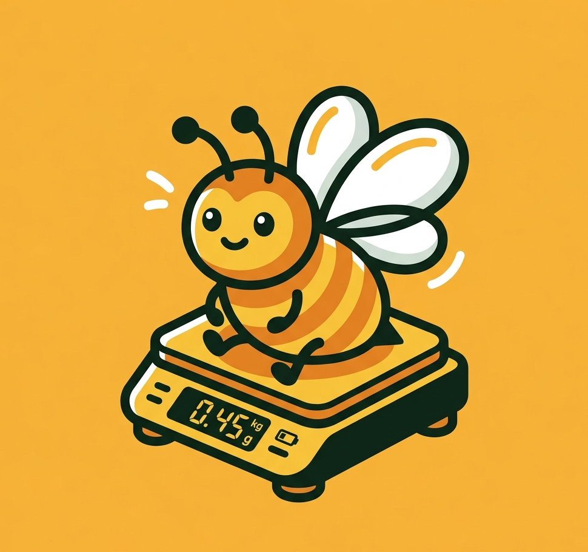
docs/assets/bee-scale-cartoon.png
