darkvolg/BeehiveScale-ESP32/docs/assets/social-preview.jpg

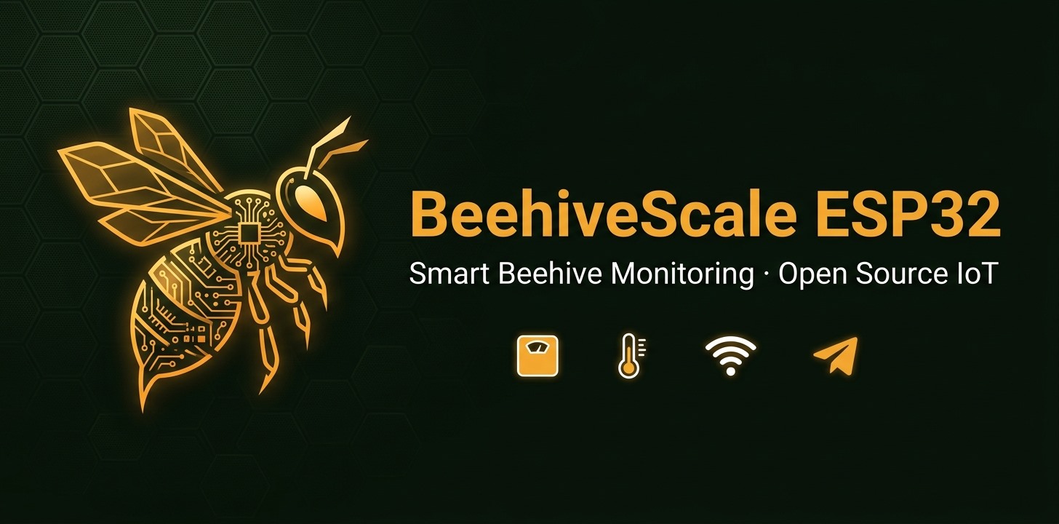
docs/assets/social-preview.jpg
