darkvolg/BeehiveScale-ESP32/hardware/Gemini.png

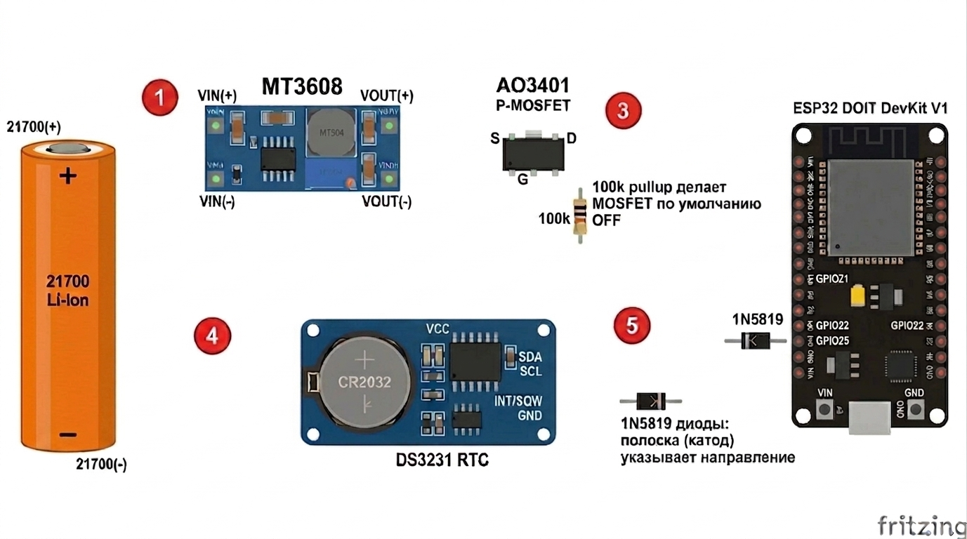
hardware/Gemini.png
