darkvolg/BeehiveScale-ESP32/hardware/schematic-hires.png

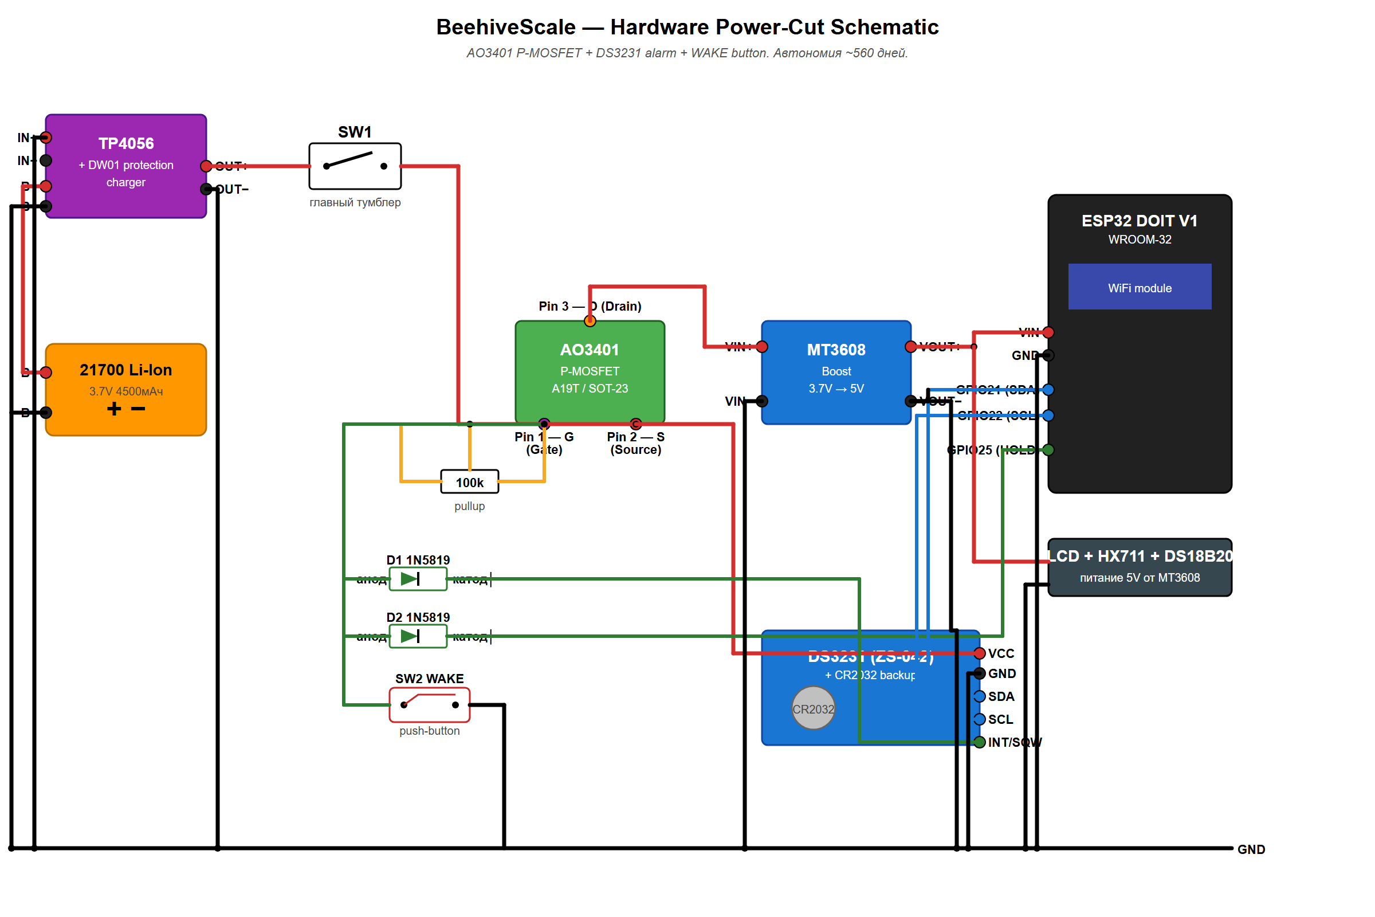
hardware/schematic-hires.png
