darkvolg/BeehiveScale-ESP32/manual.html

# 🐝 BeehiveScale ESP32 v5.0.67

Умные весы для пчеловода — Руководство пользователя

ESP32-WROOM-32 HX711 + тензодатчик LCD 16×2 I2C DS18B20 + DS3231 LittleFS лог Wi-Fi AP/STA Telegram через CF Worker Deep Sleep + расписание 📅 Архив + PWA 🔎 IP на LCD + vesy.local

📋 Обзор

🔧 Компоненты

📌 Распиновка

🔌 Подключение

💾 Прошивка

🖥️ Работа

⚖️ Калибровка

⏰ Расписание

🌐 Веб

📱 Telegram

🔍 Неисправности

❓ FAQ

## 📋 Что такое BeehiveScale ESP32

BeehiveScale ESP32 — электронные весы для пчелиных ульев на базе ESP32-WROOM-32 DevKit V1. Устройство непрерывно измеряет вес улья, температуру, заряд батареи. Передаёт данные через встроенный Wi-Fi-сайт и шлёт отчёты в Telegram по расписанию. В режиме экономии (power-cut между замерами) на банке 21700 4500 мА·ч по факту живёт около 50 дней при трёх замерах в сутки — это измерено, а не посчитано (выгрузка 15.08–11.09.2026). Подходит для контроля взятка, зимовки, отслеживания роения.

⚖️

#### Измерение веса

Точность 0.01 кг. EMA-сглаживание α=0.3. Спайк-фильтр от помех

🌡️

#### Температура

DS18B20 в улье + DS3231 RTC — температура воздуха

🌐

#### Wi-Fi AP/STA

Свой Wi-Fi (BeehiveScale / 12345678) или подключение к домашнему роутеру

📱

#### Telegram

Отчёты по расписанию через Cloudflare Worker (обходит блокировку Beeline и др.)

⏰

#### Расписание

Замер + отчёт в заданное время (например, 09:00 и 21:00)

💤

#### Deep Sleep

Авто-сон 3 мин бездействия + расписание. ~7 мА в спячке (после HT7333 — ~3 мА)

🔋

#### 18650 + AS21

Зарядка от microUSB. TP4056 + DW01 + Boost 5V на одном модуле

🕐

#### RTC DS3231

Точные дата/время без интернета. Батарейка CR2032 на годы

💾

#### LittleFS лог

Замеры пишутся во внутренний flash ESP32. CSV скачивается через сайт

📊

#### Графики

Сайт показывает кривую веса по дням. Тач-курсор: палец → значение в точке

## 📟 Экраны LCD (9 штук, переключение кнопкой MENU)

Экран 1 — Вес и время

Ves: 4.42*kg

21:35:22 W

* = показания стабильны, W = Wi-Fi OK

Экран 2 — Дельта (Δ)

D:+0.34kg

Pred:4.08kg

D = текущий − зафиксированный вес. Pred = эталон. Меняется кнопкой «📍 Зафиксировать» на сайте.

Экран 3 — Батарея

Bat:3.85V 78%

Li-Ion 1S

При <10%: !LOW BATTERY!

Экран 4 — Температура

T:27.5C R:28.0C

H: -- (DS18)

T = улей (DS18B20), R = RTC. Влажность не измеряется (DS18B20 — только температура)

Экран 5 — Дата и время

08.05.26 21:35

RTC OK

«RTC ERROR!» = села CR2032

Экран 6 — Статус

CF:20534

W:OK N:42

CF = калибровочный коэффициент, N = пробуждений из сна

Экран 7 — IP-адрес 🆕 v5.0.67

192.168.0.145

mDNS: vesy.local

Адрес для входа на сайт — не нужно искать весы в админке роутера. В AP-режиме первая строка AP 192.168.4.1, без связи — WiFi: net svyazi. Этот же экран показывается 3 секунды сразу после подключения к Wi-Fi при включении.

Экран 8 — Меню CF (для опытных)

CF:20534.0

MAIN=Vojti

Точка входа в ручную подстройку коэффициента CF (для тонкой правки если веса «чуть-чуть врут»). Обычным пользователям не нужно — пропусти кнопкой MENU.

Экран 9 — Диагностика

Diagnostika...

HX711... OK

Самопроверка: HX711, DS18B20, RTC, батарея. MAIN = повтор

## 🆕 Что нового в v5.0.x по сравнению с v4.x (ESP8266)

Что | Раньше (v4.1, ESP8266) | Сейчас (v5.0.67, ESP32)
Микроконтроллер | NodeMCU ESP8266 | ESP32-WROOM-32 DevKit V1
Deep Sleep wake | Только кнопкой RST (GPIO16 занят HX711) | Просыпается по расписанию из DS3231 / по таймеру
Лог | SD-карта (SPI) | LittleFS внутренний flash (нет окисления, надёжнее)
Telegram | Только локально (блокировка Beeline) | Через Cloudflare Worker — работает у любого провайдера
Расписание | — | Замер + отчёт в заданное время (09:00, 21:00 и т.д.)
Эталон веса | В EEPROM | + дата фиксации + EEPROM-резерв (переживает reset)
Веб-панель | Базовая (вес/тара/настройки) | Графики, тач-курсор, мобильная вёрстка, ☕+10мин
LCD | Мерцал при изменении веса | Dirty-check кеш + I2C 400kHz — без мерцания

## 🔧 Список компонентов

Кликни по любой иконке — детали компонента раскроются ниже.

📟

#### ESP32-WROOM-32

Мозг устройства. DOIT DevKit V1, 38 пинов, USB-C

× 1

⚖️

#### HX711

24-бит АЦП тензодатчика. Усиление 128

× 1

🏋️

#### Тензодатчик

Балочный или платформенный. 50–200 кг

× 1–4

📺

#### LCD 1602 I²C

16×2 символов. PCF8574, 0x27, питание 5В

× 1

🌡️

#### DS18B20

Цифровой термометр 1-Wire, −55…+125°C

× 1

🕐

#### DS3231 RTC

Часы реального времени I²C. CR2032. Точность ±2 мин/год

× 1

🔘

#### Кнопки

MAIN и MENU. Тактовые 6×6 мм

× 2

🔋

#### AS21 V6.0 + 18650

TP4056+DW01+Boost. microUSB зарядка, держатель

× 1

📐

#### Резисторы

4.7к (DS18B20 pull-up) + 2×100к (делитель)

× 3

🔌

#### DIP-сокет 2×19

Female pin headers — ESP32 на съёмном сокете

× 1

💾

#### LittleFS

Внутренний flash ESP32. Лог замеров. SD не нужна

встроено

☁️

#### CF Worker (Telegram)

beehive-relay.darkvolg.workers.dev — обходит Beeline

облако

## 📟 ESP32-WROOM-32 DevKit V1 (DOIT)

Главный микроконтроллер. 240 МГц, 4 МБ flash, Wi-Fi 802.11 b/g/n, Bluetooth, 38 пинов, USB-C для прошивки и Serial.

Параметр | Значение
Питание (VIN) | 5В от AS21 (через USB-C тоже работает)
Внутренний LDO | AMS1117 → 3.3В для всей периферии (~600 мА запас)
Ток в active + WiFi | ~80–90 мА
Ток в deep sleep | ~7 мА (с AMS1117) → ~3 мА после замены на HT7333
Запрещённые пины | D6–D11 (SPI flash), D34–D39 input only

⚠️ Partition SchemeПрошивка ~1.24МБ + WiFi + Web не влезает в default. В Arduino IDE обязательно выбрать Huge APP (3MB No OTA / 1MB SPIFFS).

💡 Что покупатьИщи именно DOIT DevKit V1, 38 пинов, USB-C. Бывают версии 30 пинов (без D6–D11 в ряду) и microUSB — оба тоже работают, но распиновка может отличаться.

## ⚖️ HX711 — АЦП тензодатчика

24-битный АЦП с программируемым усилителем. Подключается к тензодатчику с одной стороны и к ESP32 по 4 проводам с другой.

HX711 | | ESP32 | Цвет провода
VCC | → | 3V3 | красный
GND | → | GND | чёрный
DT (DATA) | → | D16 (GPIO16) | жёлтый
SCK (CLK) | → | D17 (GPIO17) | зелёный

### Подключение тензодатчика к HX711

Тензодатчик (TAL220 и аналоги) | | HX711
Красный (E+) | → | E+
Чёрный (E−) | → | E−
Зелёный (A+) | → | A+
Белый (A−) | → | A−

💡 КНР-датчикиЦвета могут отличаться. Принцип: пара толстых проводов (питание тензомоста) → E+/E−, пара тонких (сигнал) → A+/A−. Если знак показаний обратный — поменяй A+ и A− местами.

⚠️ Питание 3.3В, не 5ВHX711 работает от 5В тоже, но при 3.3В показания стабильнее (меньше шум от Boost-преобразователя). У нас именно 3.3В.

### 🔋 ОБЯЗАТЕЛЬНАЯ доработка для deep sleep — Pull-up на SCK

⚠ Без этого резистора scale.power_down() в коде НЕ работает!Программный power_down переводит SCK в HIGH (по datasheet HX711 удерживает в power-down). Но при deep sleep ESP32 пин GPIO17 уходит в Z (D17 — не RTC GPIO, не удерживается). HX711 видит «провисание» SCK → просыпается обратно → продолжает есть 1.5–2 мА в sleep вместо 1 мкА.

Решение — внешний pull-up резистор 10 кΩ:

Резистор 10 кΩ (1/4Вт или 0805 SMD) | | Куда
Один конец | → | D17 (GPIO17, SCK HX711)
Другой конец | → | 3V3 пин ESP32 ⚠ не VIN, не 5В!

💡 Замер экономии (подтверждено на железе)Без pull-up: deep sleep ~9 мА. С pull-up: deep sleep ~5 мА. Разница 4 мА — это удвоение автономии (с 14 до 26 дней на 21700).

⚠ Не путать! SCK HX711 это D17 (GPIO17) — clock тензодатчика. НЕ SCL I²C (D22 — clock для LCD/DS3231). Pull-up должен быть именно на D17, иначе экономии не будет.

## 🏋️ Тензодатчик (load cell)

Чувствительный элемент. Деформируется под весом → меняется сопротивление тензомоста → HX711 это измеряет.

Тип | Нагрузка | Особенности
Балочный (TAL220, TAL221) | 10–100 кг | Один датчик. Простая установка, точность 0.05%
Платформенный (4× углы) | 200 кг (50×4) | 4 датчика по углам платформы. Соединяются параллельно
S-образный | 50–500 кг | Подвесной. Для крупных ульев / весов в подвесе

💡 Для пчёлПолный улей с мёдом — обычно 30–40 кг. Бери датчик на 50 кг (двукратный запас). Балочный TAL220 на 50 кг — оптимально.

⚠️ Не нагружай больше номиналаПерегрузка ломает тензомост — датчик нужно менять. На «сесть» точно нельзя.

## 📺 LCD 1602 I²C (PCF8574 backpack)

Символьный дисплей 16 столбцов × 2 строки. Подсветка синяя/зелёная. С I²C-адаптером (PCF8574 backpack) — всего 4 провода.

LCD | | ESP32 | Цвет
VCC | → | VIN (5В!) | оранжевый
GND | → | GND | чёрный
SDA | → | D21 (GPIO21) | зелёный
SCL | → | D22 (GPIO22) | жёлтый

Параметр | Значение
I²C адрес | 0x27 (или 0x3F — реже)
Питание | 5В обязательно (от VIN, не 3V3)
Ток | ~30 мА (в основном на подсветку)
Контрастность | Подстроечный резистор на обратной стороне backpack

⚠️ АдресЕсли LCD не работает — проверь адрес I²C-сканером. Если 0x3F — измени LCD_ADDR в коде.

💡 I²C на 400kHzВ v5.0.8 включён Fast Mode 400kHz — каждое обновление символа в 4× быстрее, не видно глазом «мерцания». PCF8574 это поддерживает.

## 🌡️ DS18B20 — цифровой термометр

Точный цифровой датчик температуры по шине 1-Wire. Корпус TO-92 (как маленький транзистор) или зонд в металлической трубке (для улья — берём именно такой, с проводом 1–2 метра).

DS18B20 (плоской стороной к себе) | | ESP32 / схема | Цвет
GND (левая ножка) | → | GND | чёрный
DATA (центр) | → | D4 (GPIO4) + 4.7 кОм на 3V3 | белый
VCC (правая) | → | 3V3 | красный

Параметр | Значение
Диапазон | −55 … +125°C
Точность | ±0.5°C (в диапазоне −10 … +85°C)
Время преобразования | ~750 мс (12-bit)
Кабель | Можно вынести на 1–2 м без проблем

❌ Без резистора 4.7 кОм датчик не работает!Pull-up между DATA и VCC обязателен для 1-Wire. Без него — −127°C / no response.

💡 Длинный кабель в улейЕсли выносишь датчик глубже — pull-up ставь ближе к самому датчику, не к ESP32. На длинных линиях это критично.

## 🕐 DS3231 RTC — часы реального времени

Сверхточный модуль часов с термокомпенсированным кварцем. Хранит время даже когда ESP32 выключена — за счёт батарейки CR2032 (на годы). Даёт точное время для логов и расписания. Пин SQW подведён к D33 и обязателен с v5.0.47: через Alarm2 реализован power-cut — между замерами питание платы снимается полностью, а DS3231 включает его обратно строго по расписанию.

DS3231 | | ESP32 | Цвет
VCC | → | 3V3 (НЕ 5В!) | красный
GND | → | GND | чёрный
SDA | → | D21 (общая шина с LCD) | зелёный
SCL | → | D22 (общая шина с LCD) | жёлтый
SQW (INT) опц. | → | D33 (GPIO33, RTC GPIO) | фиолетовый — задел на P3
32K, RST | — | не используются | —

Параметр | Значение
I²C адрес | 0x68
Точность хода | ±2 мин/год
Батарейка | CR2032 (хватает на 5–10 лет)
Ток от CR2032 | ~110 мкА

⚠️ Power LED и резистор R5 на модулеНа большинстве модулей DS3231 распаяны:
1) Power LED — жжёт ~200 мкА постоянно. От CR2032 батарейка садится за неделю → выпаять.
2) R5 или диод в цепи зарядки CR2032 (модуль рассчитан на Li-ion). Для обычной не-перезаряжаемой CR2032 это вредно → тоже выпаять.

💡 VCC = 3V3, не 5ВНа 5В есть риск что модуль попытается «зарядить» CR2032 через схему — это запрещено для не-перезаряжаемых.

## 🔘 Тактовые кнопки 6×6 мм

Обычные тактовые кнопки. Внешние резисторы не нужны — используется встроенный pull-up ESP32 (INPUT_PULLUP).

Кнопка | Пин 1 | Пин 2 | Цвет
MAIN (тара / калибровка) | D27 (RTC GPIO) | GND | синий
MENU (навигация / OK) | D26 | GND | голубой

### Длительности нажатий

Кнопка | Действие | Длительность
MENU | Следующий экран | короткое
MENU | OK / на главную | 2.5 сек
MAIN | (ничего — защита) | короткое
MAIN | ТАРА (с диалогом MENU=OK) | 3 сек MEDIUM
MAIN | КАЛИБРОВКА | 6 сек LONG

💡 D27 = RTC GPIOКнопка MAIN на D27 может разбудить ESP32 из deep sleep (через esp_sleep_enable_ext0_wakeup). Это RTC GPIO — в режиме сна остаётся активным.

## 🔋 AS21 V6.0 — модуль зарядки и Boost

2-in-1 модуль (PENGHEKEJI): контроллер заряда Li-ion + повышающий Boost-преобразователь с регулируемым выходом 5/6/9/12В. Своего microUSB разъёма нет — зарядка идёт через входные пины VIN+GND (от внешнего 5В адаптера). Держатель 18650 в комплекте не идёт — банка подключается проводами к BAT+GND.

### Распиновка модуля (6 контактов, 2 ряда по 3)

Пин | Что это | Куда подключить
VIN | Вход для зарядки 18650 (4.5–8В, рек. 5В, ток до 1А) | +5В от внешнего адаптера (когда заряжаешь)
GND | Земля входа | GND адаптера
BAT | Полюс банки 18650 | + банки. Сюда же красный провод делителя для мониторинга
GND | Земля банки | − банки
VOUT | Выход Boost (5/6/9/12В по перемычке) | ESP32 VIN (оранжевый провод)
GND | Земля выхода | ESP32 GND (чёрный)

⚠️ Перемычка напряжения 5V / 6V / 9V / 12VНа плате AS21 4 квадратные площадки выбора выходного напряжения. Должна стоять перемычка на «5V» (капля припоя между двумя площадками «5V»). Если стоит 6V — на VIN ESP32 будет ~6.6В, что может сжечь LCD 1602 (макс 5.5В) и перегреть DS3231 (макс 5.5В).

### Технические параметры (datasheet)

Параметр | Значение
Зарядное напряжение | DC 4.5–8В (рек. 5В)
Зарядный ток | 0–1А
Окончание зарядки | 4.2В ±2%
Quiescent ток (sleep) | ~450 мкА — заметно для deep sleep
Boost ток выхода | 5В: 1.2А · 6В: 1А · 9В: 0.66А · 12В: 0.5А
КПД Boost | 78–90%
LED индикаторы | CR — идёт зарядка, OK — заряжено
Размер | 23 × 15.4 × 5.7 мм

💡 Заряжается и работает одновременноМожно одновременно подавать 5В на VIN (зарядка идёт) и снимать с VOUT для питания ESP32. Часть тока идёт в банку (заряжается), часть — на нагрузку. Это режим passthrough — работает прекрасно для столовых тестов и солнечных установок.

⚠️ Защищённые 18650/21700Используй банки от Samsung / LG / Panasonic / Molicel. «Безымянные» с радиорынка часто врут о ёмкости и могут перегреться. На AS21 нет встроенной защиты глубокого разряда — желательна банка с защитой (или внешний DW01).

💡 21700 вместо 18650Можно поставить 21700 на 4500–5000 мА·ч — даёт в 1.5× больше автономии. Размер банки больше (21×70 мм vs 18×65 мм) — обычный держатель 18650 не подойдёт. Решение: припаять провода к банке напрямую (короткими прикосновениями, не более 3 сек паяльником).

## 📐 Резисторы

Номинал | Кол-во | Назначение | Корпус
4.7 кОм | × 1 | Pull-up DS18B20 DATA → 3V3 | 1/4W TH или 0805 SMD
100 кОм (R1) | × 1 | Делитель батареи: BAT+ → midpoint | 1/4W TH или 0805 SMD, точность 1%
100 кОм (R2) | × 1 | Делитель батареи: midpoint → GND | 1/4W TH или 0805 SMD, точность 1%

💡 Точность 1%Для делителя батареи бери резисторы 1% (а не обычные 5%) — иначе показания напряжения будут «плыть» в пределах ±0.1В. Стоят те же копейки.

⚠️ Ток утечки делителя4.2В / 200кΩ = 21 мкА. Заметно для deep sleep (~7 мА), но в общем балансе ОК.

## 🔌 DIP-сокет 2×19 (female pin headers)

Не паяй ESP32 напрямую в плату — используй сокет. Если что-то пойдёт не так (попалась битая плата, или нужно прошить через другой компьютер), просто вытащил и заменил без перепайки.

Параметр | Значение
Тип | Female pin header, 2.54 мм шаг
Длина | 2 ряда по 19 пинов (или 2×20 snap-off — отрежь лишний пин)
Цена | ~30 ₽ за пару (2 ряда)

💡 Можно заменитьЕсли нет 2×19 — возьми 2×20 snap-off (продаются длинные «гребёнки» которые ломаются по линии). Откуси кусок нужной длины.

## 💾 LittleFS — встроенное хранилище лога

Это не отдельный модуль, а файловая система во внутреннем flash ESP32. В v5 заменила SD-карту из v4.1 — надёжнее, нет окисления контактов, выдерживает мороз/жару.

Параметр | Значение
Где живёт | Внутренний flash ESP32 (раздел SPIFFS, ~1 МБ)
Что хранит | CSV-лог замеров + index страницы веб-сайта
Формат записи | datetime, weight_kg, temp_c, bat_v, bat_pct
Когда пишет | Каждый замер по расписанию + перед уходом в deep sleep
Ротация | При достижении лимита файл переименовывается, начинается новый

### Как скачать лог

Действие | URL
CSV для Excel | http://192.168.4.1/api/log
JSON для графика | http://192.168.4.1/api/log/json
Очистить | POST /api/log/clear (или через сайт)

💡 Почему не SDВ улье SD-карты ржавеют и пропадают. Внутренний flash — паяный, навсегда. Жизнь flash 100 000 циклов записи — для пасеки на годы.

## ☁️ Cloudflare Worker — релай Telegram

Не железо, а облачный сервис. Бесплатный воркер на Cloudflare (100 000 запросов в день), который форвардит сообщения от ESP32 в api.telegram.org. Нужен потому что российские провайдеры (Beeline, и др.) блокируют прямой доступ к Telegram API.

Параметр | Значение
URL релая | beehive-relay.darkvolg.workers.dev
Метод | POST /sendMessage
Авторизация | Заголовок X-Beehive-Secret: <общий ключ>
Тело запроса | JSON: { token, chat_id, text, parse_mode: "HTML" }
Лимит | 100 000 запросов в день (бесплатный план Cloudflare)

💡 Уже настроенРелай развёрнут. В прошивке ESP32 уже зашит URL и секрет. Тебе не нужно ничего настраивать — только Token и Chat ID в разделе «Telegram» на сайте весов. Подробнее → вкладка 📱 Telegram.

Хочешь свой релайИсходник в репо: cloudflare-worker/src/index.js. Деплоится одной командой через wrangler CLI. Можно сделать свой URL чтобы не зависеть от моего.

⚠️ Питание LCDLCD 1602 работает от 5В. Подключайте к VIN (от AS21 boost), а не к 3V3.

💡 SD-карта больше не нужнаВ v5 лог пишется во внутренний flash ESP32 (LittleFS). Это надёжнее (нет окисления контактов в улье), и освобождает GPIO под другие задачи.

## 🛒 Где купить компоненты

Компонент | AliExpress | Россия | Цена (примерно)
ESP32-WROOM-32 DevKit V1 | ✅ Есть (DOIT) | ✅ Чип и Дип, Амперка | 400–700 ₽
HX711 + тензодатчик 50 кг | ✅ Есть набор | ✅ Чип и Дип | 400–700 ₽
LCD 1602 I²C (PCF8574, 0x27) | ✅ Есть | ✅ Амперка | 250–400 ₽
RTC DS3231 + CR2032 | ✅ Есть | ✅ Чип и Дип | 150–250 ₽
DS18B20 в гильзе (1 м кабель) | ✅ Есть | ✅ Есть | 150–250 ₽
AS21 V6.0 (TP4056+DW01+Boost) | ✅ Есть (искать «AS21 V6 18650») | ⚠ Реже | 250–400 ₽
Li-Ion 18650 (Samsung INR/Sony VTC) | ✅ Есть | ✅ Есть | 200–500 ₽
HT7333 SOT-89 (опционально) | ✅ Есть (10 шт ~200 ₽) | ⚠ Реже | 20–40 ₽/шт

💰 Итого «полный комплект»: 2000–3500 ₽ за все детали (без корпуса). Это разовые расходы, дальше только электричество для зарядки.

## 📌 Распиновка ESP32-WROOM-32 DevKit V1

На silkscreen платы пины обозначены как Dxx (где xx = номер GPIO). Например, метка D17 на плате = GPIO17 в коде.

### Таблица пинов проекта v5.0.67

Метка платы | GPIO | Направление | Назначение | Цвет провода
D16 | GPIO16 | Вход | HX711 DT (данные) | жёлтый
D17 | GPIO17 | Выход | HX711 SCK (тактирование) | зелёный
D21 | GPIO21 | I²C SDA | LCD + DS3231 (общая шина) | зелёный
D22 | GPIO22 | I²C SCL | LCD + DS3231 (общая шина) | жёлтый
D33 | GPIO33 | Вход (RTC GPIO) | DS3231 SQW (опц., задел на P3) | фиолетовый
D4 | GPIO4 | 1-Wire | DS18B20 DATA + 4.7kΩ pullup | белый
D27 | GPIO27 | INPUT_PULLUP | Кнопка MAIN (RTC GPIO ⚡) | синий
D26 | GPIO26 | INPUT_PULLUP | Кнопка MENU | голубой
D34 | GPIO34 | ADC1_CH6 (input only) | Делитель батареи (midpoint) | серый
3V3 | — | Питание 3.3В | HX711, DS3231, DS18B20, R-pullup | красный
VIN | — | Питание 5В | LCD VCC (от AS21) | оранжевый
GND | — | Земля | Общая для всех | чёрный

### ⚠️ Запрещённые пины ESP32

GPIO | Почему
6, 7, 8, 9, 10, 11 | Внутренняя SPI flash ESP32 — плата перестанет загружаться
0, 2, 12, 15 | Strapping pins — могут влиять на boot. Можно использовать осторожно
1 (TX0), 3 (RX0) | UART0 — занят USB-сериал. Конфликт с прошивкой
34, 35, 36, 39 | Input only — нельзя выводить как OUTPUT

## 🔋 Какая силовая часть стоит в этих весах

Банка — 21700 на 4500 мА·ч (подтверждено 16.08.2026). Это важно для расчёта автономии: все цифры в разделе «Расписание → Энергопотребление» посчитаны именно под неё.

⚠️ Плату питания надо сверить с натуройВ документации остались следы двух вариантов обвязки, и какой стоит в собранном экземпляре — пока не проверено. Схема ниже нарисована по варианту Б.

Вариант | Из чего | Как отличить глазами
А — AS21 V6.0 | Одна плата: зарядка TP4056 + DW01 + Boost 5 В вместе | Одна платка ~23×15 мм, сбоку 4 квадратные площадки выбора выходного напряжения (перемычка должна стоять на «5V»). Так описано в карточке компонента «AS21 V6.0» в этом руководстве
Б — TP4056 + MT3608 | Две отдельные платки: TP4056 (только зарядка) и MT3608 (только Boost 5 В) | Две платы, соединённые проводами. На MT3608 — подстроечный резистор-«крутилка» для настройки выходных 5 В. Так нарисовано на схеме ниже

💡 Модуль power-cut одинаковый в обоих вариантахAO3401, два диода 1N5819, резистор 100 кОм, кнопка SW2 и тумблер SW1 ставятся в разрыв плюса между банкой и повышайкой. Различается только то, что стоит до и после. Схему ключа ниже можно брать как есть при любом варианте.

## 📐 Полная электрическая схема (с транзистором и кнопкой WAKE)

Схема нарисована по варианту Б (TP4056 + MT3608 + банка 21700) — см. предупреждение выше. Всё что нужно для повторения весов с нуля: банка → зарядка → главный тумблер SW1 → ключ AO3401 → Boost → ESP32 и периферия. Управление ключом: DS3231 SQW (пробуждение по расписанию), кнопка SW2 (включение вручную) и сама ESP32 (снимает с себя питание, когда отработала).

💡 Схема кликабельна в браузереОткрой картинку в отдельной вкладке (правая кнопка → «Открыть изображение») и приближай — подписаны все пины и номиналы.

## ⚡ Модуль power-cut крупным планом

Та же обвязка ключа отдельно, с номиналами и точками пайки. Собирается на кусочке перфоборда ~2.5×3 см и встаёт в разрыв плюсового провода питания.

⚠️ Полярность диодов1N5819: полоска на корпусе = катод. Оба диода анодами в общую точку — на затвор AO3401. Перепутаешь — питание либо не включится вообще, либо не выключится никогда.

## 🔌 Общая схема подключения

## ⚖️ HX711 — подключение тензодатчика

HX711 | | ESP32 | Описание
VCC | → | 3V3 | Питание 3.3В (стабильнее показания, чем 5В)
GND | → | GND | Общая земля
DT (DATA) | → | D16 GPIO16 | DT_PIN = 16. Не strapping pin, безопасно
SCK (CLK) | → | D17 GPIO17 | SCK_PIN = 17. Сосед с D16, удобно паять шлейфом

💡 Подключение тензодатчика к HX711Красный → E+, Чёрный → E−, Зелёный → A+, Белый → A−. Для одиночного датчика TAL220: E+/E− = питание, A+/A− = сигнал.

## 📺 LCD 1602 I²C (адрес 0x27)

LCD | | ESP32 | Описание
VCC | → | VIN (5В) | Обязательно 5В — от VIN, не 3V3
GND | → | GND | Земля
SDA | → | D21 GPIO21 | I²C данные (общая шина с DS3231)
SCL | → | D22 GPIO22 | I²C тактирование (общая шина с DS3231)

⚠️ Адрес I²CПо умолчанию LCD_ADDR = 0x27. Если не работает — попробуйте 0x3F. Проверьте I²C-сканером.

## 🕐 DS3231 RTC (адрес 0x68)

DS3231 | | ESP32 | Описание
VCC | → | 3V3 | 3.3В — НЕ 5В (CR2032 не должна заряжаться)
GND | → | GND | Земля
SDA | → | D21 GPIO21 | Та же шина I²C что и LCD
SCL | → | D22 GPIO22 | Та же шина I²C что и LCD
SQW (INT) опц. | → | D33 GPIO33 | Alarm output → ESP32 RTC GPIO. ОБЯЗАТЕЛЕН с v5.0.47 — на нём работает power-cut: DS3231 Alarm2 будит плату по расписанию, между замерами питание снимается полностью

💡 CR2032Установите батарейку в держатель DS3231 — часы не сбросятся при выключении весов. Хватает на 5–10 лет.

⚠️ Power LED и R5 на модулеНа большинстве модулей DS3231 есть Power LED (жжёт ~200 мкА) и SMD-резистор R5 в цепи зарядки CR2032. Выпаять оба для не-перезаряжаемой CR2032 и долгой жизни батарейки.

## 🌡️ DS18B20 — датчик температуры

DS18B20 (вид плоской стороной) | | ESP32 | Описание
GND (левая ножка) | → | GND | Земля
DATA (центральная) | → | D4 GPIO4 | 1-Wire. TEMP_PIN = 4
VCC (правая ножка) | → | 3V3 | Питание 3.3В
DATA | также | 3V3 через 4.7 кОм | Pull-up резистор обязателен!

❌ Без резистора датчик не работает!Резистор 4.7 кОм между DATA и VCC (3.3В) обязателен для 1-Wire. Без него — −127°C / ошибка.

💡 Длинный кабель в улейЕсли выносишь датчик на ~1+ м — поставь pullup ближе к датчику, не к ESP32.

## 🔋 Делитель напряжения батареи

18650/21700 макс. 4.2В делится пополам двумя резисторами 100 кОм. На GPIO34 (ADC1_CH6) попадает ~2.1В — в пределах диапазона ESP32 ADC (с ADC_11db = 0–3.3В).
Куда подключать «BAT+»: к пину BAT на модуле AS21 (это плюс банки 18650 напрямую, до Boost-преобразователя). Не путать с VOUT (5В после Boost) и VIN (вход зарядки).

💡 BAT+ берётся с AS21Прямое напряжение банки 18650 (3.0–4.2В), не выход 5V Boost. Ток утечки делителя: 4.2В / 200кΩ = 21 мкА — заметно для deep sleep, но ОК.

## 💤 Пробуждение из Deep Sleep

✓ ESP32 пробуждается полноценноВ отличие от ESP8266 (где пришлось перейти на ESP32 как раз из-за этого), ESP32 умеет:

Способ | Триггер | Описание
Timer wakeup | esp_sleep_enable_timer_wakeup() | Просыпается через N секунд. Для расписания (например, через 8 часов до 09:00)
EXT0 wake (DS3231) опц. | D33 = LOW | DS3231 alarm подтягивает SQW в LOW → ESP32 просыпается. Реализовано с v5.0.47 — основной механизм пробуждения (power-cut через Alarm2)
Кнопка MAIN | D27 = LOW | Можно настроить ext0/ext1 wake для ручного пробуждения
Кнопка RST на плате | RST = 0 | Полная перезагрузка (теряется RTC RAM, но не EEPROM)

## 🔋 Подключение AS21 V6.0 → ESP32

AS21 V6.0 — модуль «всё-в-одном» (TP4056 + DW01 + Boost 5 В + holder 18650). Имеет три точки подключения к ESP32 и один microUSB для зарядки:

Выход AS21 | → Куда | Назначение
5V_OUT | ESP32 VIN (+ LCD VCC) | 5 В после Boost — питает ESP32 и LCD
GND | ESP32 GND | Общая земля для всей схемы
BAT+ (raw) | Делитель R1+R2 → ESP32 D34 | Прямое напряжение банки (3.0–4.2 В) для ADC батареи
microUSB | Зарядное 5 В | Только для зарядки — не для прошивки!

💡 Два USB-разъёма на устройстве:

- microUSB на AS21 — зарядка батареи 18650
- USB-C на ESP32 DevKit V1 — прошивка и Serial-консоль (115200)

Можно подключать оба одновременно.

## ⚡ Модуль power-cut (AO3401 + SW2) 🆕 v5.0.34

Отдельная DIY-плата ~2.5×3 см, встаёт в разрыв питания между TP4056 и MT3608. Именно она даёт настоящее обесточивание между замерами — deep sleep ESP32 жрёт на порядок больше.

Деталь | Кол-во | Роль
AO3401 P-MOSFET (SOT-23, маркировка A19T) | 1 | Ключ питания. Открыт = плата запитана
1N5819 Шоттки | 2 | Развязка двух источников управления затвором: D1 от DS3231 SQW, D2 от ESP
100 кОм | 1 | Подтяжка затвора к истоку — закрывает транзистор когда никто не тянет вниз
SW2 тактовая | 1 | Ручное включение (затвор → GND)
SW1 тумблер | 1 | Главный выключатель на корпусе, полное обесточивание

Как работает цикл: сработал будильник DS3231 → SQW уходит в LOW → через D1 тянет затвор вниз → транзистор открылся → плата загрузилась. Отработала (замер, Telegram, лог) → прошивка программирует следующий будильник и сбрасывает флаг → SQW отпускается → резистор 100 кОм закрывает транзистор → питание снято. Между замерами потребление определяется только «паразитками» схемы.

⚠️ Без CR2032 в DS3231 весы не проснутся. Часы — единственный источник пробуждения по расписанию. Села батарейка часов — плата не включится сама, только вручную через SW2.

Пошаговая сборка, распиновка AO3401 и полный netlist N1–N8 — в hardware/POWER-CUT-INSTRUCTIONS.md (есть и HTML-версия в той же папке).

## 🔘 Кнопки управления

💡 Внешние резисторы не нужны — используется INPUT_PULLUP, встроенные подтяжки ESP32. Кнопка просто соединяет пин с GND.

Кнопка | Пин 1 | Пин 2 | Функции
MAIN (тара / калибровка) | D27 / GPIO27 | GND | 3 сек = ТАРА (с диалогом MENU=OK) 6 сек = КАЛИБРОВКА. RTC GPIO ⚡ — может разбудить из deep sleep
MENU (навигация / OK) | D26 / GPIO26 | GND | короткое = следующий экран 2.5 сек = OK / на главную
SW2 «WAKE» (включение) | не к ESP32! затвор AO3401 (Gate) | GND | Кнопка включения питания. Прошивка её не видит — это чистое железо на плате power-cut. Нажатие замыкает затвор транзистора на землю → питание подаётся → плата грузится. Соединения N5 и N6 в netlist модуля power-cut

💡 MAIN на RTC GPIO: D27 — это RTC GPIO, поэтому кнопка MAIN способна разбудить ESP32 из deep sleep через esp_sleep_enable_ext0_wakeup().

⚠️ Не путать три кнопки: MAIN и MENU — тактовые 6×6 на корпусе, идут на GPIO. SW2 WAKE — на плате power-cut, к процессору не подключена, только включает питание. Отдельно есть EN и BOOT на самой плате ESP32 DevKit — это сброс МК и режим прошивки, к нашей схеме отношения не имеют. Полная таблица органов управления — на странице ⚙️ Эксплуатация.

## 💾 Прошивка ESP32

### Библиотеки Arduino (установить через Менеджер библиотек)

Библиотека | Версия | Для чего
arduino-esp32 (Espressif) | 2.0.x / 3.0.x | Основной core ESP32
LiquidCrystal_I2C | 1.1.2+ | LCD 16×2 I²C
HX711 by bogde | 0.7.5+ | АЦП тензодатчика
OneWire | 2.3+ | Шина DS18B20
DallasTemperature | 3.9+ | Датчик DS18B20
RTClib by Adafruit | 2.1+ | DS3231 RTC
ArduinoJson | 6.x | Не 7.x! Web API использует API v6

### Настройки Arduino IDE для ESP32

#### Добавить поддержку ESP32

Файл → Настройки → Дополнительные URL менеджера плат:

https://espressif.github.io/arduino-esp32/package_esp32_index.json

Затем: Инструменты → Плата → Менеджер плат → найти «esp32» → Установить

#### Выбрать плату

Инструменты → Плата → ESP32 Arduino → DOIT ESP32 DEVKIT V1

- CPU Frequency: 240 MHz
- Partition Scheme: Huge APP (3MB No OTA / 1MB SPIFFS) — обязательно, без него прошивка не влезает
- Flash Size: 4MB
- Upload Speed: 921600

#### Открыть скетч и загрузить

Файл → Открыть → BeehiveScale/BeehiveScale.ino
Инструменты → Порт → выбрать COM-порт ESP32 → нажать «Загрузить» (→)

💡 Авто-прошивкаESP32 DevKit V1 поддерживает auto-reset через DTR/RTS — никаких кнопок зажимать не надо.

### PlatformIO (альтернатива)

В корне проекта есть platformio.ini с готовым окружением:

[env:esp32dev]
platform = espressif32
board = esp32dev
framework = arduino
board_build.partitions = huge_app.csv
monitor_speed = 115200

Команда: pio run -e esp32dev -t upload

## 📋 Основные файлы прошивки

Все настройки и константы вынесены в заголовочные файлы скетча BeehiveScale/. Полный список:

Файл | За что отвечает
BeehiveScale.ino | Главный файл, setup() и loop()
Pins.h | Распиновка GPIO (DT, SCK, SDA, SCL, BTN_*, BAT_ADC...)
Settings.h | Тайминги, EMA, пороги, авто-сон, EEPROM-адреса
Connectivity.h | Дефолты Wi-Fi (AP), URL CF Worker, секреты
WebUI.cpp | HTTP-сервер, REST API, HTML-страницы
Telegram.cpp | Отправка отчёта через CF Worker
Schedule.cpp | Расписание, alarm DS3231, deep sleep

💡 Большинство настроек теперь редактируется через сайт (192.168.4.1) — не нужно перепрошивать. В прошивке остаются только дефолты и распиновка.

## 📌 Pin defines (Pins.h)

Распиновка ESP32-WROOM-32 для v5.0.67:

// HX711 (тензодатчик) #define DT_PIN 16 // GPIO16 (D16) — данные #define SCK_PIN 17 // GPIO17 (D17) — тактирование // I²C шина (LCD + DS3231) #define SDA_PIN 21 // GPIO21 (D21) #define SCL_PIN 22 // GPIO22 (D22) // DS3231 alarm wake (RTC GPIO) — power-cut пробуждение с v5.0.47 #define SQW_PIN 33 // GPIO33 (D33) — пин подведён, прошивка пока не использует // DS18B20 1-Wire #define TEMP_PIN 4 // GPIO4 (D4) + 4.7kΩ pullup → 3V3 // Кнопки #define BTN_MAIN_PIN 27 // GPIO27 (D27, RTC GPIO ⚡) — тара/калибровка #define BTN_MENU_PIN 26 // GPIO26 (D26) — навигация/OK // ADC батареи #define BAT_ADC_PIN 34 // GPIO34 (D34, ADC1_CH6) — input only! // I²C адреса #define LCD_ADDR 0x27 // LCD 1602 (или 0x3F на некоторых модулях) #define RTC_ADDR 0x68 // DS3231 (фиксированный)

⚠️ Не использовать GPIO 6–11 — это внутренняя SPI flash ESP32. Плата перестанет загружаться. Также избегать 0/2/12/15 (strapping) и 1/3 (USB-Serial).

## ⏱️ Тайминги и фильтры (Settings.h)

// Чтение HX711 #define SCALE_READ_INTERVAL_MS 600 // Период замера (было 1500 на ESP8266) #define EMA_ALPHA_DEFAULT 0.3f // Дефолт сглаживания (было 0.2) #define SPIKE_FILTER_KG 5.0f // Резкие выбросы > 5 кг отбрасываются #define DEAD_BAND_KG 0.005f // Зона нечувствительности возле 0 // Авто-сон #define AUTO_SLEEP_MS 180000UL // 180 сек = 3 мин (настраивается через сайт) #define SLEEP_GUARD_SEC 60 // Не уходим в сон если до alarm < 60 сек #define KEEPALIVE_BONUS_MS 600000UL // «☕ +10 мин» добавляет 10 минут // LCD #define LCD_REFRESH_MS 200 // Перерисовка экрана (с dirty-check, без мерцания) #define I2C_FREQ_HZ 400000 // 400 kHz fast mode (было 100 kHz) // Кнопки #define BTN_DEBOUNCE_MS 50 #define BTN_MEDIUM_MS 3000 // MAIN MEDIUM = тара #define BTN_LONG_MS 6000 // MAIN LONG = калибровка #define BTN_MENU_HOLD_MS 2500 // MENU удержание = OK

💡 EMA альфа: 0.05–0.2 — сильное сглаживание, плавно но запаздывает. 0.3 (дефолт) — баланс. 0.5–0.9 — быстрая реакция, шумно.

## 📶 Wi-Fi настройки (Connectivity.h)

### Дефолтные значения AP-режима (ESP32 создаёт свою сеть)

// Дефолтная точка доступа (можно сменить через сайт) #define AP_SSID_DEFAULT "BeehiveScale" #define AP_PASS_DEFAULT "12345678" // мин. 8 символов #define AP_CHANNEL 1 #define AP_MAX_CLIENTS 4 // IP по умолчанию: 192.168.4.1 (стандарт ESP32 AP)

### Логин/пароль веб-панели

#define WEB_USER_DEFAULT "admin" #define WEB_PASS_DEFAULT "beehive" // сменить после первого входа! #define OTA_PASS_DEFAULT "beehive" // для будущего OTA (если включить)

### STA-режим (подключение к домашнему роутеру)

Включается через сайт «Wi-Fi» — не редактируется в коде. Хранится в EEPROM.

ℹ️ Какой режим выбрать?

- AP режим (дефолт): улей далеко от дома. Подключаешься телефоном к сети BeehiveScale.
- STA режим: улей в зоне домашнего Wi-Fi. Сайт открывается с любого устройства в сети + работает синхронизация NTP и Telegram-отчёты.

## 📱 Telegram через Cloudflare Worker

В v5 прямой запрос на api.telegram.org заменён на релай через Cloudflare Worker (обходит блокировку Beeline и др.). Подробности — на странице «Telegram».

// URL релая (фиксированный, не меняется) #define TG_RELAY_URL "https://beehive-relay.darkvolg.workers.dev/sendMessage" // Общий секрет (заголовок X-Beehive-Secret) — должен совпадать с CF Worker #define TG_RELAY_SECRET "<см. в исходнике, не публикуется>" // Token и chat_id хранятся в EEPROM, вводятся через сайт «Telegram»

💡 Token и Chat ID вводятся через сайт 192.168.4.1 → раздел «Telegram». В прошивку не зашиваются.

## 🕐 NTP (синхронизация часов)

// Часовой пояс: Москва = +3 #define NTP_TZ_OFFSET_SEC 10800 // 3 * 3600 #define NTP_DST_OFFSET_SEC 0 // в РФ нет летнего времени #define NTP_SERVER_1 "pool.ntp.org" #define NTP_SERVER_2 "time.google.com"

💡 Sync time: сайт → «Настройки» → кнопка «Sync NTP». Работает только в режиме STA (нужен интернет). Время записывается в DS3231.

## 💾 Arduino IDE — настройки платы

#### Установить core ESP32

Файл → Настройки → Дополнительные URL менеджера плат:

https://espressif.github.io/arduino-esp32/package_esp32_index.json

Затем: Инструменты → Плата → Менеджер плат → найти «esp32» → Установить (версия 2.0.x или 3.0.x).

#### Выбрать плату DOIT ESP32 DEVKIT V1

Инструменты → Плата → ESP32 Arduino → DOIT ESP32 DEVKIT V1

- CPU Frequency: 240 MHz
- Partition Scheme: Huge APP (3MB No OTA / 1MB SPIFFS) ← обязательно!
- Flash Size: 4MB
- Upload Speed: 921600
- Core Debug Level: None

#### Загрузить скетч

Файл → Открыть → BeehiveScale/BeehiveScale.ino
Инструменты → Порт → COM-порт ESP32 → нажать «Загрузить» (→).

💡 Авто-прошивка: ESP32 DevKit V1 поддерживает auto-reset через DTR/RTS — никаких кнопок зажимать не надо.

❌ Ошибка «Sketch too big» / «Not enough space»: ты выбрал Default Partition (1.31 МБ под код). Прошивка ~1.4 МБ. Поставь Huge APP (3MB No OTA) и пересобери.

## 📦 Библиотеки Arduino

Установить через Менеджер библиотек (Скетч → Подключить библиотеку → Управлять библиотеками):

Библиотека | Версия | Для чего
arduino-esp32 (Espressif) | 2.0.x или 3.0.x | Основной core ESP32
LiquidCrystal_I2C | 1.1.2+ | LCD 16×2 I²C
HX711 by bogde | 0.7.5+ | АЦП тензодатчика
OneWire | 2.3+ | Шина 1-Wire (DS18B20)
DallasTemperature | 3.9+ | Драйвер DS18B20
RTClib by Adafruit | 2.1+ | DS3231 RTC + alarm
ArduinoJson | 6.x (НЕ 7.x!) | Web API использует API v6 — на 7.x не соберётся

⚠️ ArduinoJson 7.x несовместима — у неё другой API (JsonDocument вместо StaticJsonDocument). Откати до 6.21.x если поставил 7.

## 🛠️ PlatformIO (альтернатива)

В корне проекта есть platformio.ini с готовым окружением:

[env:esp32dev] platform = espressif32 board = esp32dev framework = arduino board_build.partitions = huge_app.csv monitor_speed = 115200 upload_speed = 921600 lib_deps = bogde/HX711@^0.7.5 marcoschwartz/LiquidCrystal_I2C@^1.1.4 paulstoffregen/OneWire@^2.3.7 milesburton/DallasTemperature@^3.11.0 adafruit/RTClib@^2.1.4 bblanchon/ArduinoJson@^6.21.5

Команда: pio run -e esp32dev -t upload

## 💾 EEPROM-карта v5.0.67

В EEPROM ESP32 (эмулируется через NVS, 512 байт) хранятся постоянные настройки:

Адрес | Байт | Что хранится
0 | 4 | calibrationFactor (float) — коэф. калибровки HX711
4 | 4 | offset (long) — нулевое смещение тары
8 | 4 | lastSavedWeight (float)
12 | 1 | magic 0xA5
13 | 4 | alertDelta (float) — порог алерта в ТГ
17 | 4 | calibWeight (float) — эталонный вес для калибровки
21 | 4 | emaAlpha (float) — сглаживание
25 | 1 | magic2 0xA6
26 | 4 | prevOffset (long) — для отмены тары
30 | 4 | prevWeight (float) — эталон Δ
40–63 | 24 | AP_PASS (Wi-Fi пароль)
64 | 1 | magic3 0xA7
313 | 4 | NEW v5: prevWeightDate (uint32_t Unix ts — дата фиксации эталона)
317–319 | 3 | NEW v5: autoSleepSec (uint16_t + magic 0xA8)
320–325 | 6 | NEW v5: lastReportWeight (float + magic 0xA9) — для Δ «с прошлого замера»
327–330 | 4 | NEW v5: lastTempC (float + magic 0xAA) — fallback для TG

💡 Подсветка — оранжевые строки = новые поля v5.0.x, добавлены при портировании с ESP8266.

## ⚙️ Параметры, настраиваемые через сайт (без перепрошивки)

Параметр | Диапазон | По умолчанию | Описание
EMA сглаживание | 0.05 — 0.9 | 0.3 | Фильтр показаний веса
Эталонный груз | 0.1 — 50 кг | 5.0 кг | Для калибровки через сайт
Авто-сон | 0 — 600 сек | 180 сек (3 мин) | Бездействие до deep sleep. 0 = не засыпать (отладка)
Порог алерта Δ | 0.05 — 10 кг | 1.0 кг | Срочное TG-сообщение при резком изменении
Расписание | 00:00 — 23:59 | 09:00 / 21:00 | Время автоматического замера + отчёта в TG
Wi-Fi режим | AP / STA | AP | Точка доступа или клиент роутера
Telegram token + chat_id | — | пусто | Раздел «Telegram» на сайте

## 🚨 Алерты в Telegram (v5.0.20) 📝 описано с v5.0.67

Кроме отчётов по расписанию весы шлют аварийные уведомления. Настраиваются в разделе «Telegram» на сайте. Каждый алерт уходит один раз, пока условие сохраняется (анти-спам), и сбрасывается с гистерезисом.

Алерт | Порог | По умолчанию | Когда срабатывает
🔋 Низкая батарея | 0 — 5.0 В (0 = выключен) | 3.6 В (до v5.0.67 было 0 = выключен) | Напряжение упало ниже порога. Сброс — когда поднимется на 0.1 В выше (гистерезис). 3.6 В ≈ 15% — есть 1-2 дня на зарядку.
❄️ Низкая температура | −55 … +85 °C (0 = выключен) | 0 (выключен) | Улей остыл ниже порога — риск подмерзания зимой. Сброс при +2 °C выше порога.
🔥 Высокая температура | −55 … +85 °C (0 = выключен) | 0 (выключен) | Перегрев улья. Сброс при 2 °C ниже порога.
🕐 Ошибка RTC | вкл / выкл | включён | Часы DS3231 не отвечают или потеряли время (села CR2032). Без RTC не работает расписание.
🐝 Роение (v5.0.52) | авто: 3 × порог Δ, минимум 1.5 кг | активен | Резкое падение веса между двумя замерами — вылет роя или кража. Порог считается от «Порога алерта Δ».

⚠️ Важно — реальный случай: до v5.0.67 алерт батареи по умолчанию был выключен. Банка 18650 разрядилась в улье, весы молча умерли, и хозяин заметил это только через две недели — по тишине в Telegram. Данные за этот период потеряны безвозвратно. Если прошивка старая или ты когда-то сохранял настройки алертов с нулевым порогом — проверь и поставь 3.6 В вручную.

💡 Как это работает после обновления: если ты никогда не сохранял настройки алертов, весы возьмут новый дефолт 3.6 В автоматически. Если сохранял — останется твоё старое значение (в том числе 0 = выключено), и порог надо выставить руками.

## 🔧 Serial команды (115200 бод)

Для отладки можно слать команды через USB-C → Serial монитор:

Команда | Описание | Пример
STATUS | Информация о системе (вес, время, батарея) | STATUS
NTP | Синхронизировать время с NTP (нужен STA) | NTP
TIME | Показать текущее время DS3231 | TIME
SETTIME | Установить время вручную | SETTIME 2026 05 09 14 30 00
TARE | Сделать тарирование | TARE
WAKEUP_REASON | Причина последнего пробуждения из sleep | WAKEUP_REASON
SLEEP | Принудительно уйти в deep sleep | SLEEP 60 (на 60 сек)
DIAG | Самотест (HX711, DS18B20, RTC, Battery) | DIAG
REBOOT | Перезагрузка | REBOOT

## 🖥️ Управление кнопками

📋

#### MENU — короткое

Переключение между 9 экранами LCD по кругу.

«чик»

↩️

#### MENU — 2.5 сек

OK / возврат на Экран 1. В диалогах — подтверждение.

удержание

🔘

#### MAIN — 3 сек

ТАРА (сброс веса в 0). После отпуска — диалог подтверждения через MENU=OK.

MEDIUM

⚖️

#### MAIN — 6 сек

КАЛИБРОВКА. Запуск мастера калибровки по эталонной гире.

LONG

🔧

#### Экран 8 + MAIN

Войти в режим ручной подстройки CF (для опытных). Обычным пасечникам не нужно.

из Меню CF

🩺

#### Экран 9 + MAIN

Запустить самопроверку (HX711, DS18B20, RTC, батарея).

из Диагностики

⚡

#### SW2 «WAKE» — третья кнопка

Включает питание весов вручную. К процессору не подключена — замыкает затвор транзистора AO3401 на GND. Нужна потому, что между замерами плата обесточена и MAIN/MENU в это время мертвы. Держать ~0.5 сек. При работающих весах не делает ничего — это нормально.

железо, не GPIO

🎚️

#### SW1 — тумблер

Главный выключатель на корпусе. OFF = полное обесточивание, время в DS3231 живёт на CR2032. На зиму и для перевозки.

железо

🚫

#### EN / BOOT на плате ESP32

Штатные кнопки DevKit, к нашей схеме не относятся. EN = сброс микроконтроллера, BOOT = режим прошивки. В работе не нужны.

не трогать

😴

#### Wake-press guard

После пробуждения LCD первое нажатие MAIN не открывает тару — только зажигает экран. Защита от случайного тарирования.

авто

💡 Символ * на Экране 1Появляется когда разброс веса за несколько измерений мал — показания стабильны. Используется для авто-фиксации значения.

💡 Как отличить SW2 от EN, если забыл какая гдеНажми, когда экран погашен и весы спят. Загрузились со сплеша — это SW2 WAKE. Ноль реакции — это EN (он работает только когда питание уже подано).

## 📊 Дельта веса (две точки отсчёта)

В v5.0.x появились две дельты — гибкость для пасечника:

Где видно | Что считается | Как сбросить
📈 «С прошлого замера» | Δ от lastReportWeight | Авто после каждого Telegram-отчёта
🎯 «От зафиксированной точки» | Δ от prevWeight | Только вручную: сайт → «📍 Зафиксировать» (с датой!)

💡 ПримерПоставил улей → нажал «📍 Зафиксировать» → началась запись эталона. Через неделю Δ покажет точный прирост мёда. Параллельно «С прошлого замера» показывает дневное изменение для оперативного контроля.

💡 Переживает resetЭталон + дата фиксации хранятся в EEPROM (адреса 313–325 + magic 0xA9). Не теряется при перезагрузке/прошивке.

## 💤 Авто-сон (Deep Sleep)

После 3 минут бездействия (никто не нажимает кнопки и не открывает сайт) — автоматический переход в глубокий сон.

#### Sleep guard 60 сек

Если до следующего расписания меньше 60 сек, ESP32 не уходит в сон (избегаем цикла «проснулся-уснул»).

#### Запись лога и отключение

Лог пишется в LittleFS. lastReportWeight, lastTempC, эталон сохраняются в EEPROM. Wi-Fi и LCD отключаются. HX711 → power_down (1.5 мА → 1 мкА).

#### Пробуждение

С v5.0.34 плата между замерами обесточена полностью (power-cut), а не спит. Способов включения два:
• Будильник DS3231 (Alarm2) — основной. Сработало время из расписания → SQW уходит в LOW → открывает транзистор AO3401 → плата грузится, делает замер и Telegram-отчёт, затем снимает с себя питание.
• Кнопка SW2 «WAKE» — вручную, когда подошёл к улью и не хочешь ждать слота. Кнопки MAIN и MENU в обесточенном состоянии не работают: они висят на GPIO, а процессор без питания.

⚠️ Без живой CR2032 в DS3231 весы не проснутся сами вообще — часы единственный источник пробуждения.

### Кнопка ☕ Продлить +10 мин

На главной странице сайта есть кнопка «Продлить +10 мин» — отодвигает auto-sleep если ты сидишь и смотришь графики. В /api/data приходит поле keepLeftSec с обратным отсчётом.

💡 Настройка авто-снаЧерез сайт «Настройки → Авто-сон» можно поставить от 0 (не засыпать, отладка) до 600 секунд. По умолчанию 180 сек (3 мин).

## 🔘 Управление кнопками (важно изменилось в v5!)

⚠️ Режимы кнопок переделаны: на ESP8266 v4.1 тара была «4 коротких нажатия MAIN». В v5 для защиты от случайных нажатий — 3-секундное удержание MAIN + подтверждение через MENU=OK. Если ты привык к старой схеме — отвыкай.

### Кнопка MAIN D27 / GPIO27 (RTC GPIO ⚡)

Действие | Длительность | Результат
Короткое нажатие | < 1 сек | Ничего (защита от случайного тарирования). Только зажигает LCD после wake.
MEDIUM | ~3 сек | ТАРА — открывает диалог «Выполнить тару? MENU=OK». Если в течение 5 сек не нажать MENU — отмена.
LONG | ~6 сек | КАЛИБРОВКА — мастер калибровки по эталонной гире (см. ниже).
В режиме CF (Экран 8) | короткое | Сменить шаг подстройки: 10 → 1 → 0.1 → 10 ...
В режиме CF (Экран 8) | длинное | Сохранить CF в EEPROM и выйти

### Кнопка MENU D26 / GPIO26

Действие | Длительность | Результат
Короткое нажатие | < 1 сек | Переключение между 9 экранами LCD по кругу.
Удержание | ~2.5 сек | OK — подтверждение в диалогах (после MAIN MEDIUM = тара). Из меню — возврат на Экран 1.
В режиме CF (Экран 8) | короткое | CF + шаг (увеличить)
В режиме CF (Экран 8) | длинное | CF − шаг (уменьшить)
Удержание 5 сек на Экране 1 | ~5 сек | Сброс Wi-Fi настроек на дефолт (AP-режим, BeehiveScale / 12345678)

💡 Wake-press guard: сразу после пробуждения из deep sleep первое нажатие MAIN не открывает тару — оно только зажигает LCD. Это защита от случайного тарирования при выходе из сна.

## ⚖️ Первичная калибровка

Делается один раз при сборке весов и потом раз в сезон (весной). Понадобится гиря известного веса: 1 кг (5-литровая бутылка воды), лучше 5–10 кг для точности под рабочий диапазон улья.

#### Снять нагрузку

Платформа должна быть пустой и горизонтальной.

#### Запустить калибровку (MAIN 6 сек)

Зажми MAIN. Через 3 сек на LCD: «Otpust = TARA!» — НЕ отпускай. Через 6 сек сменится на «Otpust = KALIBR» — теперь отпускай.

Ubrat gruz!

Zhmi knopku...

#### Нажать MENU — тара пустых весов

Postav gruz

Zhmi knopku...

#### Положить эталонный груз

Поставь гирю на платформу, подожди 2–3 секунды чтобы показания устаканились.

#### Нажать MENU — сохранить

OK! Factor:

20534

Калибровочный коэффициент сохраняется в EEPROM навсегда.

💡 Удобнее через сайтЗайди на сайт весов, вкладка «Калибровка». Поставь гирю, в поле введи её точный вес (например, 5.0) и нажми «Сохранить» — без танцев с кнопками. Можно с любым весом.

⚠️ Не калибруй в ульеПчёлы летают, машут крыльями — это вибрация, портит точность. Калибровать в гараже на ровной поверхности.

## ⏰ Расписание замеров и отчётов

В v5.0.x ESP32 умеет просыпаться по расписанию, делать замер, слать отчёт в Telegram и снова уходить в сон. По факту это даёт около 50 дней на одной зарядке банки 21700 (4500 мА·ч) при трёх замерах в сутки. Цифра измеренная, не расчётная — см. блок «Энергопотребление» ниже.

⏰

#### Время замера

Через сайт ставишь время, например 09:00 — каждый день в это время замер

📨

#### Отчёт Telegram

После замера автоматически шлётся в Telegram с весом, Δ, температурой

💾

#### Запись в лог

Замер записывается в LittleFS (CSV). Виден на графике сайта

💤

#### Снова в сон

До следующего часа из расписания. Sleep guard 60 сек защищает от циклов

## 🌐 Как настроить расписание

#### Зайти на сайт весов

См. вкладку «Веб» — раздел «Как зайти». Открой «Настройки» — там внутри блок «Расписание замеров».

#### Выбрать время замера

Например, 09:00 (утренний) и 21:00 (вечерний). Можно одно время, можно несколько.

#### Сохранить

ESP32 рассчитает сколько ждать до следующего замера и уйдёт в сон.

#### Проверить

На Экране 6 LCD счётчик пробуждений N будет расти после каждого срабатывания. В логе сайта появится новая строка.

## 🔋 Энергопотребление

Состояние | Ток | Длительность за день
Active + WiFi (отчёт TG) | 80–90 мА | ~30 сек × 2 раза = 1 мин/день
Active без WiFi (после отчёта) | 30–50 мА | ~3 мин до auto-sleep × 2 = 6 мин/день
Deep sleep с AMS1117 | ~7 мА | ~23.5 ч/день — основной потребитель
Deep sleep после HT7333 | ~3 мА | после замены LDO (планируется)

Расчётно: среднее ~7.3 мА × 24 ч → ~175 мА·ч/день; банка 21700 на 4500 мА·ч × 70% usable = ~3150 мА·ч → ~17–19 дней.

✅ Факт вместо расчёта (замер 15.08 → 11.09.2026) Выгрузка из Архива за 26 дней при расписании 08:00 / 14:00 / 21:00 показала: 4.18 В (99%) → 3.77 В (49%), то есть 50% заряда за 26 дней = 1.9% в сутки. Полный цикл от 100% — около 50 дней, почти втрое дольше расчётных 17–19. Значит реальное потребление в простое ~3.5 мА, а не 7 мА: расчёт выше пессимистичен, ориентируйся на измеренную цифру. Заряжать — раз в полтора месяца.

### Что реально продлит автономию

Доводка | Экономия | Эффект
Замена AMS1117 → HT7333 (SOT-89) | 7 мА → 3 мА | ×2.3 к расчёту. От измеренных 50 дней — ориентировочно до 90+ дней, но проверять надо замером
Выпаять Power LED ESP32 DevKit | ~5 мА | +несколько дней
Выпаять USB LED ESP32 DevKit | ~2 мА | +пара дней
Выпаять Power LED + R5 на DS3231 | ~200 мкА | копейки в бюджете, но даёт лет CR2032
Реализовать P3 (DS3231 alarm wake) | ~5 мкА | маленькая экономия, но точное расписание ±2 мин/год

### Влияние частоты замеров

Расписание | Доп. расход | Автономия (21700 4500, AMS1117)
2 раза в день (09:00, 21:00) ★ оптимум | +1.3 мА·ч/день | ~19 дней (разница незаметна)
4 раза (каждые 6 часов) | +2.7 мА·ч/день | ~18 дней
12 раз (каждые 2 часа) | +13 мА·ч/день | ~17 дней
24 раза (каждый час) | +27 мА·ч/день | ~16 дней

💡 Расписание влияет на батарею малоГлавный пожиратель — quiescent ток в deep sleep, а не сами замеры. Даже 24 замера в день добавляют всего ~7% к расходу. Поэтому ставь 2 замера в день (утро + вечер) — этого хватит для пасеки. Хочется детальнее — поставь 4 раза.

💡 Зачем именно 09:00 и 21:00Утром пчёлы ещё в улье — точный «холодный» вес. Вечером все вернулись с поля — виден чистый дневной принос. Δ за день = вечер − утро = именно то что интересно пчеловоду.

## 🌐 Веб-панель

#### Подключиться к Wi-Fi

Найдите сеть BeehiveScale, пароль: 12345678

#### Открыть в браузере

http://192.168.4.1

#### Логин (если попросит)

admin / beehive. После первого входа смените пароль в разделе «Wi-Fi → Пароли и доступ».

💡 Режим STA (домашний роутер)В разделе «Wi-Fi» можно переключить ESP32 на подключение к домашнему роутеру. Тогда сайт открывается с любого устройства в сети по IP-адресу из роутера — удобно когда улей рядом с домом.

## 📑 Разделы сайта (вкладки в верхнем меню)

Вкладка | Что внутри
🏠 Главная | Текущий вес, дельты (от точки + с прошлого замера), температура, батарея, статус системы. Блок «Информация об улье» (сезон, мин/макс веса за день, точек за день, дней наблюдений). Мини-график. Кнопки «Тара», «📍 Зафиксировать», «☕ Продлить +10 мин»
📊 График + Экспорт | Большой график веса и температуры. Тач-курсор: палец/мышь по графику — значение в точке. Экспорт в CSV
📡 Wi-Fi | Режим (AP/STA), SSID домашнего роутера, пароли (AP/admin/OTA)
⚙ Настройки | EMA-сглаживание (скорость отклика), авто-сон (180 сек по умолчанию), опасные пороги, dead-band нуля. Здесь же — расписание замеров (например 09:00 и 21:00)
⚖ Калибровка | Точная калибровка по эталонной гире (без танцев с кнопками). Введи вес гири, поставь её на платформу — нажми «Сохранить»
📅 Архив 🆕 v5.0.16+ | Просмотр истории по дням за выбранный период. Пресеты (Сегодня / 3 дня / Неделя / Месяц / Всё / С прошлого визита). Лента дней с маркерами аномалий (🔴 при падении больше alert_delta). Скачивание CSV за период.
📱 Telegram | Token бота, chat_id, тестовое сообщение (см. вкладку «Telegram»)
🔌 API | Список всех API-эндпоинтов с примерами (для разработчика)

💡 Блок «Информация об улье»На главной странице автоматически считается дневная статистика: Сезон (весенний/летний/осенний/зимний), Вес мин/макс за сегодня, Темп. мин/макс, Изменение за день (Δ от первого замера сегодня), Точек сегодня, Дней наблюдений (с момента первой записи в лог). Заполняется по мере поступления замеров — если расписание ещё не настроено и точек мало, поля будут «—».

## 📅 Вкладка Архив (с v5.0.16)

История замеров за выбранный период. Удобно смотреть «как идёт сезон» — посуточные сводки, аномалии падения веса, скачивание данных в Excel за любой диапазон.

### Пресеты периода

Пресет | Что показывает
Сегодня | Текущий день
3 дня / Неделя / Месяц | Скользящее окно с сегодня
Всё | С первой записи в логе
↩ С прошлого визита 🆕 v5.0.21 | Автоматически от последнего открытия сайта (например, «вчера в 18:42» или «3 дн. назад»). Не сбрасывается при переключении вкладок
Date-range | Произвольный период через два календарика

### Что в архиве

- Сводка за период: общая Δ веса, количество записей, разбивка по дням
- Лента дней: по карточке на каждый день, с месячными группировками и днями недели
- Маркер аномалии: 🔴 у дня где было падение веса больше alert_delta (тревожная роевая ситуация)
- Скачать CSV за период: для Excel или другой аналитики

💡 «С прошлого визита» — главная фишка v5.0.21Заходишь на сайт через неделю — Архив сам открывается на интервале «с прошлого визита по сегодня». Не надо вспоминать когда последний раз смотрел и крутить даты. Кнопка «↩ С прошлого визита» + подпись «Прошлый визит: 05.05.2026 (7 дн. назад)».

## 📲 PWA — установка на главный экран телефона (с v5.0.16)

Сайт весов поддерживает Progressive Web App. Можно «установить» его на главный экран телефона как обычное приложение — иконка пчелы с ульем, открывается в полноэкранном режиме без адресной строки браузера.

### Как установить

#### Android (Chrome / Edge)

Открой сайт 192.168.4.1 (или IP в STA) → меню «⋮» → «Добавить на главный экран» или «Установить приложение»

#### iOS (Safari)

Открой сайт → кнопка «Поделиться» внизу (квадратик со стрелкой) → «На экран Домой»

### Что даёт PWA

- Иконка пчелы с медово-оранжевым фоном на главном экране — открывается как нативное приложение
- Полноэкранный режим — без адресной строки и кнопок браузера, чисто интерфейс весов
- Offline-страница — если нет связи с весами (например ты вдали от пасеки), приложение откроется из кеша с последними известными данными вместо ошибки браузера
- Быстрый запуск — один тап и сразу вес/график

💡 Артефакты PWAНа сайте есть /manifest.json (метаданные приложения), /sw.js (service-worker для offline-кеша) и /icon.svg (SVG-иконка пчелы). Всё подаётся прямо из прошивки ESP32.

## 📊 Выгрузка в Excel — два варианта 🆕 v5.0.69

Обе кнопки — на вкладке Архив, блок «⬇ Скачать». Период берётся тот, что выбран сверху (Сегодня / Неделя / Месяц / Всё).

Кнопка | Что даёт | Когда брать
📥 CSV за период | Голые цифры: разделитель «;», десятичная запятая | Когда данные идут в расчёты, сводные таблицы, свои графики
📊 Excel с подсветкой | Книга из трёх листов: «Сводка» (итоги периода + расход батареи и остаток дней работы), «Замеры» (всё раскрашено, шапка закреплена) и «По дням» (привес за сутки) | Когда надо просто посмотреть глазами — сразу видно провалы веса, жару и разряд

### Что на каждом листе

Лист | Что показывает
Сводка | Период и число замеров, вес начало → конец, мин/макс веса и температуры, батарея в вольтах и процентах. Отдельно — расход заряда в сутки, сколько дней осталось и длина полного цикла от 100%. По этим строкам сразу видно, когда ехать заряжать
Замеры | Все строки лога с раскраской. Шапка закреплена — при прокрутке видно названия колонок
По дням | Одна строка на сутки: сколько было замеров, вес на конец дня, привес за сутки, мин/макс веса и температуры, заряд на конец дня

### Как читаются цвета

Колонка | Раскраска
Вес | Жёлтая заливка, жирный — чтобы не терялся среди остальных цифр
Изм., кг | Зелёное — улей набрал, красное — потерял. Порог ±0.05 кг, мелочь не красится
Температура | 5 ступеней: синяя ниже 10 °C, голубая 10-20, кремовая 20-28, оранжевая 28-35, красная выше 35
Батарея | Зелёная выше 80%, бледно-зелёная 50-80%, жёлтая ниже 50%, красная ниже 3.6 В — это порог алерта разряда
Заряд, % | Считается той же кривой LiPo, что в прошивке, поэтому сходится с цифрой на экране весов и в Telegram

⚠️ Excel спросит про формат файлаПри открытии выскочит «формат файла не соответствует расширению» — нажми «Да», файл откроется нормально. Так происходит потому, что весы отдают книгу в формате SpreadsheetML 2003 (XML) под именем .xls: настоящий XLSX — это zip-архив с несколькими XML внутри, ESP32 такой не соберёт без заметного расхода памяти. LibreOffice открывает без вопросов.

💡 Нужны ещё и графики в книгеГрафиков кнопка на весах не даёт — формат SpreadsheetML диаграммы не поддерживает. Для них есть tools/csv_to_xlsx.py: делает настоящий XLSX с теми же тремя листами плюс лист с графиками веса, температуры и батареи. Требует Python и openpyxl: py -3 tools/csv_to_xlsx.py — сам подхватит свежий beehive_*.csv с рабочего стола. Кнопка на весах ничего не требует и работает с любого устройства, скрипт — для разбора дома.

## 🔌 API эндпоинты

URL | Метод | Описание
/api/data | GET | JSON: вес, температура, батарея, время, keepLeftSec и т.д.
/api/tare | POST | Тарировать весы
/api/save | POST | «📍 Зафиксировать» — сохранить эталон + дата
/api/keepalive | POST | «☕ Продлить +10 мин»
/api/settings | POST | EMA, alertDelta, calibWeight, autoSleep
/api/ntp | POST | Синхронизировать время с NTP
/api/calib/set | POST | Тонкая калибровка по эталонной гире через сайт
/api/log | GET | Скачать CSV-лог
/api/log/json | GET | JSON-лог для графика (с throttle 30 сек)
/api/log/clear | POST | Очистить лог
/api/daystat | GET | Дневная статистика (мин/макс/среднее)
/api/period?from=&to= | GET | 🆕 v5.0.16 — JSON записей за диапазон дат (стриминг). Для вкладки Архив
/api/log?from=&to= | GET | 🆕 v5.0.16 — CSV за диапазон дат. Старый ?date= совместим
/api/last-visit | GET | 🆕 v5.0.21 — Timestamp прошлого открытия web. Для пресета «С прошлого визита» в Архиве
/archive | GET | 🆕 v5.0.16 — Alias на главный SPA (прямая ссылка на вкладку Архив)
/manifest.json | GET | 🆕 v5.0.16 — PWA-манифест (имя, иконка, theme-color)
/sw.js | GET | 🆕 v5.0.16 — Service-worker для offline-кеша
/icon.svg | GET | 🆕 v5.0.16 — SVG-иконка пчелы для PWA
/chart | GET | Полноэкранная страница графика
/api/tg/settings | POST | Сохранить Telegram token + chat_id
/api/tg/test | POST | Тестовое сообщение в Telegram
/api/wifi/settings | POST | Режим Wi-Fi (AP/STA), SSID/пароль
/api/auth/password | POST | Сменить пароль admin
/api/auth/ota | POST | Сменить пароль OTA
/api/backup | GET | Скачать backup настроек (JSON)
/api/backup/restore | POST | Восстановить настройки из backup
/api/reboot | POST | Перезагрузка ESP32

### Пример ответа /api/data

{
"weight": 4.42, // кг
"prevWeight": 4.08, // зафиксированный эталон
"prevWeightDate": "2026-05-05 23:04",
"lastReportWeight": 4.40,
"tempC": 27.5,
"rtcTempC": 28.0,
"batV": 3.85,
"batPct": 78,
"datetime": "2026-05-08 21:35:22",
"wifiOk": true,
"keepLeftSec": 540 // до auto-sleep
}

## 🚀 Как зайти на сайт

В режиме AP (по умолчанию) ESP32 поднимает свою Wi-Fi сеть. Подключайся с телефона/ноутбука и открывай браузер:

Параметр | Значение
Wi-Fi сеть (SSID) | BeehiveScale
Пароль Wi-Fi | 12345678
IP адрес панели | http://192.168.4.1
Логин админки | admin
Пароль админки | beehive

⚠️ Сразу смени пароль! После первого входа открой раздел «Wi-Fi → Пароли и доступ» и поставь свой пароль для admin (и желательно сменить пароль AP на не-дефолтный).

💡 Режим STA (домашний роутер): в разделе «Wi-Fi» можно переключить ESP32 на подключение к домашнему роутеру. Тогда сайт открывается с любого устройства в твоей сети. Удобно когда улей рядом с домом — не нужно каждый раз переключать Wi-Fi.

## 🔎 Как узнать IP в режиме STA 🆕 v5.0.67

В режиме STA адрес выдаёт роутер по DHCP, и он может меняться — особенно если весы долго были выключены и аренда истекла. Три способа попасть на сайт, от удобного к запасному:

Способ | Что делать | Плюсы / минусы
1. По имени (mDNS) | Открыть в браузере http://vesy.local | Адрес знать не нужно вообще, не меняется никогда. Работает на Windows 10+, iPhone, Mac, Android 12+. Может не работать при «изоляции клиентов» на роутере.
2. Посмотреть на весах | Кнопкой MENU долистать до Экрана 7 — IP. Адрес и mDNS-имя прямо на LCD. Он же показывается 3 секунды сразу после включения. | Работает всегда, роутер не нужен. Надо подойти к улью.
3. Резервация в роутере | В админке роутера: DHCP → привязать MAC весов к постоянному IP. | Самый надёжный. Настраивается один раз, дальше адрес не меняется никогда.

💡 Рекомендуется: сделать резервацию IP в роутере (способ 3) и запомнить vesy.local (способ 1). Экран 7 — страховка на случай смены роутера или сети.

⚠️ Имя изменилось в v5.0.67: раньше mDNS-имя было beehivescale.local (нигде не документировалось), теперь — vesy.local. Тем же именем весы представляются в Arduino IDE при прошивке по воздуху (OTA-порт vesy).

## 📦 Пример ответа /api/data

{ "weight": 4.42, // кг (после EMA + dead-band) "prevWeight": 4.08, // зафиксированный эталон "prevWeightDate": "2026-05-05 23:04", // дата фиксации эталона "lastReportWeight": 4.40, // вес последнего TG-отчёта "tempC": 27.5, // улей (DS18B20) "rtcTempC": 28.0, // воздух (RTC DS3231) "batV": 3.85, // напряжение батареи "batPct": 78, // % заряда (3.0 В = 0%, 4.2 В = 100%) "datetime": "2026-05-09 14:30:22", // время DS3231 "wifiOk": true, // подключён к роутеру (STA) или AP активен "keepLeftSec": 540, // секунд до auto-sleep "uptimeSec": 1234, // время работы с последнего пробуждения "wakeCount": 42, // счётчик пробуждений (Экран 6) "calibrationFactor": 432167.0, // коэффициент калибровки HX711 "fwVersion": "5.0.15" }

💡 Интеграция в Home Assistant: можно сделать REST sensor с URL http://192.168.4.X/api/data — и все поля доступны как entities в HA. Подходит для дашбордов и автоматизаций.

## 📊 График веса с тач-курсором

На странице «График» (или /chart для полноэкранного режима) — интерактивная кривая веса по времени:

- Палец / мышь по графику → курсор показывает значение в точке (вес и время)
- Зелёная линия = вес. Оранжевая = температура улья (DS18B20)
- Точки фиксации эталона отмечены вертикальной линией
- Период: 1 день / 7 дней / 30 дней — переключатель сверху
- Данные подгружаются с throttle 30 сек чтобы не грузить ESP32

💡 Полноэкранный график на телефоне: открой http://192.168.4.1/chart — это отдельная страница без меню, занимает весь экран. Удобно смотреть на телефоне в портретном режиме.

## 🔄 Wi-Fi: AP vs STA

### Режим AP (по умолчанию)

- ESP32 создаёт свою Wi-Fi сеть BeehiveScale / 12345678
- IP всегда 192.168.4.1
- Подходит когда улей далеко от дома (нет роутера)
- Минусы: нет интернета → нет NTP-синка и нет Telegram-отчётов (Telegram нужен только когда подключаешься телефоном к ESP32 и сам активируешь?)

### Режим STA (подключение к роутеру)

- ESP32 коннектится к домашнему Wi-Fi (SSID + пароль вводишь на сайте)
- IP назначает роутер (DHCP). Смотри в роутере → клиенты → BeehiveScale
- Подходит когда улей рядом с домом
- Плюсы: работает Telegram, NTP, доступ из любой точки сети

ℹ️ Переключение в STA: сайт → «Wi-Fi» → выбрать STA → ввести SSID + пароль роутера → Сохранить. ESP32 перезагрузится, попробует подключиться. Если не получилось за 10 сек — возвращается в AP.

⚠️ Сброс Wi-Fi: зажми MENU 5 сек на главном экране — настройки Wi-Fi сбросятся на дефолт (AP / BeehiveScale / 12345678). Помогает если забыл пароль или ESP32 не подключается к новому роутеру.

## 🛡️ Безопасность

- HTTP Basic Auth на всех /api/* и страницах настроек (admin / beehive по умолчанию)
- HTTPS не поддерживается — ESP32 не тянет TLS-сервер с приличной скоростью. Это нормально для локальной сети
- Telegram-token хранится в EEPROM в открытом виде — но EEPROM недоступен снаружи (только через USB-консоль с физическим доступом)
- В CF Worker есть проверка X-Beehive-Secret — посторонний не сможет дёргать релай от твоего имени

⚠️ Если выставляешь весы в STA-режим в публичную сеть (например офисный Wi-Fi гостевой) — обязательно смени пароли admin и AP на не-дефолтные. Иначе любой в той же сети сможет открыть твою панель.

## 📱 Telegram-отчёты

Весы шлют отчёты в Telegram по расписанию. В отчёте — текущий вес, эталон, изменение, температура, заряд батареи. Работает у любого провайдера (Beeline и др.) благодаря Cloudflare Worker-релаю.

Как это работаетESP32 шлёт HTTPS-запрос на beehive-relay.darkvolg.workers.dev с заголовком X-Beehive-Secret. Worker проверяет секрет и форвардит сообщение в api.telegram.org с твоим токеном. Beeline и подобные провайдеры блокируют только прямой доступ к Telegram API, а Cloudflare Worker они не блокируют.

🤖

#### BotFather

Создаёт бота, выдаёт Token

🆔

#### userinfobot

Показывает твой Chat ID

☁️

#### CF Worker

Релай — обходит блокировку API

📨

#### Отчёт

Приходит каждый раз когда срабатывает расписание

## ⚙️ Настройка с нуля (5 шагов)

#### Создать бота через @BotFather

В Telegram найди @BotFather, напиши /newbot, придумай:
• Display name (например, «Улей 5 — мой») — что видишь в чате
• Username (например, my_hive5_bot) — обязательно заканчивается на _bot

BotFather пришлёт Token — длинная строка вида 1234567890:AAFxxxxxxxxxxxxxxxxxxxxxxxxxxxxxxxx. Скопируй её.

#### Узнать свой Chat ID через @userinfobot

Найди @userinfobot, напиши ему любое сообщение. Он пришлёт твой Chat ID — число (может быть со знаком минус для групп).

#### Открыть бота из шага 1 и нажать «Start»

Это обязательно! Иначе бот не сможет тебе писать. Нажми /start или просто кнопку «Запустить».

#### Зайти на сайт весов, раздел «Telegram»

Подключись к Wi-Fi BeehiveScale, открой 192.168.4.1. Раздел «Telegram». Вставь Token и Chat ID. Нажми «Сохранить».

#### Тестовое сообщение

Кнопка «Тестовое сообщение» — должно прийти в Telegram приветствие. Если пришло — всё работает. Дальше отчёты будут приходить по расписанию.

## 💡 Зачем Cloudflare Worker?

На прошивке v4.1 (ESP8266) ESP отправлял запрос напрямую на api.telegram.org. У провайдера Beeline (и некоторых других в РФ) этот домен заблокирован — отчёты не приходили, в Serial были ошибки CONNECTION_REFUSED.

В v5 ESP32 шлёт запрос на наш Cloudflare Worker (beehive-relay.darkvolg.workers.dev), а Worker уже форвардит его в api.telegram.org. Cloudflare провайдеры не блокируют — они нужны для половины интернета.

🐝 ESP32 (улей)

→ HTTPS →

☁️ Cloudflare Worker

→ HTTPS →

💬 api.telegram.org

→

📱 Твой телефон

☁️ Что делает Worker: принимает POST с заголовком X-Beehive-Secret + JSON body {token, chat_id, text, parse_mode}. Проверяет секрет (защита от чужих запросов). Если ОК — форвардит в https://api.telegram.org/bot<TOKEN>/sendMessage и возвращает результат обратно.

💡 CF Worker уже развёрнут на нашем общем endpoint beehive-relay.darkvolg.workers.dev. Тебе ничего не надо делать — просто в скетче зашит этот URL и общий секрет. Бесплатный план CF: 100k запросов в день — для 100 ульев с почасовыми отчётами всё равно остаётся огромный запас.

## 📨 Что приходит в отчёте

Отчёт шлётся в Telegram каждый раз когда срабатывает расписание (например, в 09:00 и 21:00). Пример сообщения:

📊 Отчёт: улей
🕐 Время: 09.05.2026 21:00:10
⚖️ Вес: 4.42 кг
🎯 Эталон: 4.08 кг (зафикс. 05.05, 4 дн назад)
🎯 От зафикс. точки: +0.34 кг
📈 С прошлого замера: +0.02 кг
🌡 Температура: 27.5 °C
🔋 Батарея: 3.85 В (78 %)

### Поля отчёта

Поле | Источник
⚖️ Вес | Текущий замер с HX711 (после EMA + dead-band)
🎯 Эталон (+ дата) | prevWeight + prevWeightDate (дата фиксации) из EEPROM
🎯 От зафикс. точки | Текущий вес − эталон. Δ за весь сезон / неделю
📈 С прошлого замера | Текущий вес − lastReportWeight (вес последнего TG-отчёта). Δ за день/часы
🌡 Температура | DS18B20 в улье (если датчик подключён). Иначе DS3231
🔋 Батарея | ADC GPIO34 → пересчёт через делитель 2:1

💡 HTML-форматирование: отчёт использует parse_mode: "HTML" — теги <b> отображаются жирным шрифтом. Если приходят теги в виде текста — обнови прошивку до v5.0.1+.

## ⏰ Привязка отчётов к расписанию

В v4.1 отчёты слались по интервалу (например, каждые 6 часов). В v5 отчёт привязан к расписанию — конкретное время суток.

📅 Как это работает: на сайте «Расписание» ты задаёшь время (например, 09:00 + 21:00). ESP32 пишет alarm в DS3231, уходит в deep sleep, просыпается ровно в это время → делает замер → шлёт отчёт через CF Worker → возвращается в сон. Расход батареи минимальный.

### Сценарии расписания

Сценарий | Время в расписании | Цель
Минимальный | 21:00 | 1 отчёт в день — итог за сутки. Батарея живёт максимально долго (измеренные ~50 дней при трёх замерах, при одном — дольше)
Стандартный | 09:00 + 21:00 | Утром «что осталось», вечером «что прибавили». Автономия — порядка измеренных 50 дней
Подробный | 06:00 + 12:00 + 18:00 + 22:00 | 4 отчёта в день. Видно динамику взятка по часам. ~20 дней
Отладка | каждый час | Проверка работы прошивки. Жрёт батарею за неделю

⚠️ Если время в DS3231 неправильное — расписание не сработает. Сначала синхронизируй: сайт → «Настройки → Часы → Sync NTP» (нужен интернет, режим STA). Без интернета — установи время вручную через сайт или Serial-команду SETTIME.

## 🛠️ Cloudflare Worker (для разработчика)

Если хочешь развернуть свой собственный CF Worker (например, со своим секретом) — исходник в репозитории: cloudflare-worker/src/index.js. Деплой через wrangler deploy.

### Endpoint и формат запроса

Параметр | Значение
URL | POST https://beehive-relay.darkvolg.workers.dev/sendMessage
Заголовок аутентификации | X-Beehive-Secret: <общий секрет>
Content-Type | application/json
Body | { "token": "<TG_BOT_TOKEN>", "chat_id": <ID>, "text": "<HTML>", "parse_mode": "HTML" }

### Ответы Worker

HTTP код | Что значит
200 | OK, сообщение доставлено в Telegram
401 | Неверный X-Beehive-Secret
400 | Неверный JSON body, отсутствуют обязательные поля
403 / 404 от Telegram | Возвращается как есть. Обычно — неверный token или chat_id
500 | Внутренняя ошибка Worker (редко)

### Пример curl-запроса

curl -X POST https://beehive-relay.darkvolg.workers.dev/sendMessage \ -H "Content-Type: application/json" \ -H "X-Beehive-Secret: <секрет>" \ -d '{ "token": "1234567890:AAFxxxxxxxxxxxxxxxxxxxxxxxxxxxxxxxx", "chat_id": 123456789, "text": "<b>Тест</b> от консоли", "parse_mode": "HTML" }'

☁️ Лимит CF Workers (бесплатный план): 100 000 запросов в день. Для пасеки на 100 ульев с отчётами каждый час: 100 × 24 = 2400 запросов в день. Запас в ~40 раз.

## ❌ Что может пойти не так

### «Тестовое сообщение» не приходит

Симптом | Причина | Решение
Ошибка 401 Unauthorized | Неправильный Token бота | Перепроверь Token. Без пробелов, без кавычек. Можно перевыдать через @BotFather → /token
Ошибка 400 Bad Request или chat not found | Неправильный Chat ID или ты не нажал /start в боте | Перепроверь Chat ID через @userinfobot. Открой бота и нажми /start
CONNECTION_REFUSED / CONNECTION_LOST | Нет интернета или Wi-Fi не подключился к роутеру | Проверь Экран 6 LCD: должно быть W:OK. Перевключи STA-режим. Проверь что роутер раздаёт интернет
Ошибка от Worker X-Beehive-Secret invalid | В прошивке зашит неверный секрет | Сверь TG_RELAY_SECRET в Connectivity.h с тем что в CF Worker. Перепрошей
Сообщение пришло, но <b> видны как текст | Старая прошивка без parse_mode: HTML | Обнови прошивку до v5.0.1+ (в v5.0.21 это уже работает)
Тест работает, но по расписанию ничего не приходит | Расписание не настроено или RTC ERROR | Сайт → Расписание (поставь время). Проверь Экран 5 (время) и Экран 6 (счётчик пробуждений N)

### Telegram приходит, но в неправильное время

Время DS3231 не синхронизировано с реальным. Зайди на сайт → «Настройки → Часы → Sync NTP». Это работает только в режиме STA с интернетом. Без интернета — установи вручную.

## 🔒 Безопасность Telegram-данных

- Token бота хранится в EEPROM ESP32 в открытом виде. Доступен только при физическом доступе к плате через USB-консоль или dump прошивки
- Worker не логирует tokens и chat_id (только метрики количества запросов)
- Между ESP32 ↔ Worker и Worker ↔ Telegram — HTTPS (TLS). Прослушать в локальной сети нельзя
- Если Token утёк — перевыдать в BotFather: /token → выбрать бота → новый токен. Старый сразу инвалидируется

ℹ️ Можно ли использовать одного бота на нескольких ульях? Да. Создай группу в Telegram, добавь бота, узнай chat_id группы (через @userinfobot — пересланное из группы). Поставь этот chat_id во всех ульях. Все отчёты будут падать в одну группу — удобно для пасеки на N ульев.

## ❓ Частые вопросы

LCD не отображает ничего или показывает квадраты +

1. LCD требует 5В на VCC — подключите к VIN (от AS21), не к 3V3.

2. Отрегулируйте контрастность — синий подстроечный резистор на обратной стороне I²C-адаптера LCD.

3. Проверьте адрес I²C — в коде 0x27. Загрузите I²C-сканер и найдите реальный. Если 0x3F — измените LCD_ADDR.

4. SDA → D21 (GPIO21), SCL → D22 (GPIO22).

Вес показывает 0.00 или мигает *** OSHIBKA! *** +

1. Проверьте HX711: DT → D16, SCK → D17, VCC → 3V3, GND → GND.

2. Откройте Экран 8 (Диагностика) — посмотрите HX711 OK или FAIL.

3. Попробуйте поменять местами A+ и A− тензодатчика.

4. Сделайте тарирование: MAIN 3 сек + MENU=OK.

5. Если HX711 = FAIL — отключи питание, прозвони мультиметром все 4 провода. Чаще всего отвалился DT.

ESP32 не просыпается из Deep Sleep +

На ESP32 deep sleep работает железно (в отличие от ESP8266 — это была одна из главных причин перехода).

1. Проверь батарею — если < 3.0В, защита DW01 на AS21 могла отключить банку.

2. Нажми кнопку RST на плате ESP32 — это полная перезагрузка.

3. Проверь что время на DS3231 правильное (Экран 5). Если RTC ERROR — расписание не работает.

4. Если N (счётчик пробуждений) на Экране 6 не растёт — расписание не настроено или AlarmCheck скетч даст подсказку.

Telegram не приходит +

1. На сайте → раздел «Telegram» → кнопка «Тестовое сообщение». Если пришло — расписание просто ещё не сработало.

2. Если ошибка 401 Unauthorized — неправильный Token. Перепроверь, без пробелов, без кавычек.

3. Если ошибка 400 Bad Request или chat not found — неправильный Chat ID или ты не нажал «Start» в боте.

4. Если CONNECTION_REFUSED / CONNECTION_LOST — нет интернета или Wi-Fi не подключился к роутеру.

5. Если приходят сообщения без жирного шрифта (теги <b> видны как текст) — обнови прошивку до v5.0.1+.

Температура −127°C или ошибка +

Отсутствует резистор 4.7 кОм между DATA (D4 / GPIO4) и VCC (3.3В). Это обязательный компонент 1-Wire — без него датчик не отвечает.

Если кабель к DS18B20 длинный (>1м, например в улей) — pullup ставь ближе к датчику.

Wi-Fi сеть BeehiveScale не видна +

1. Устройство инициализируется 5–10 секунд после включения.

2. На Экране 6 LCD должно показывать W:OK.

3. Если включён режим STA (подключение к роутеру) — сети BeehiveScale не будет, ищи весы по IP в роутере.

4. Зажми MENU 5 сек на главном экране — сброс Wi-Fi на дефолт (AP-режим).

Расписание не срабатывает +

1. Проверь время на Экране 5 — должно быть правильное (твой часовой пояс).

2. Если время неправильное — синхронизируй через сайт: «Настройки → Часы → Sync NTP» (нужен интернет, режим STA).

3. Если CR2032 на DS3231 села (RTC ERROR) — замени батарейку, потом снова выстави время.

4. Sleep guard: если до следующего часа из расписания меньше 60 секунд, ESP32 не уснёт (защита от циклов).

Скачать лог веса в CSV +

Данные пишутся в LittleFS (внутренний flash ESP32, ~1МБ доступно).

Интервал записи: по умолчанию каждый замер по расписанию + перед уходом в deep sleep.

Формат строки:

datetime,weight_kg,temp_c,bat_v,bat_pct
2026-05-08 21:00:10,4.42,27.5,3.85,78

Скачать лог: 192.168.4.1/api/log — файл скачается автоматически.

Скачать JSON для графика: /api/log/json (используется встроенным графиком).

Очистить: POST на /api/log/clear или через сайт.

Ротация: при достижении лимита файл переименовывается, начинается новый.

Прошивка не влезает в ESP32 +

В Arduino IDE нужно выбрать Partition Scheme: Huge APP (3MB No OTA / 1MB SPIFFS). Default partition даёт всего 1.31МБ под код, а прошивка ~1.24МБ + WiFi + Web.

Если используешь PlatformIO — board_build.partitions = huge_app.csv уже в platformio.ini.

Какое напряжение подавать вместо батареи (для проверки) +

На входе делителя R1+R2 = 100к / 100к. На GPIO34 попадает половина:

Напряжение БП | На D34 (ADC) | Сайт покажет | % заряда
3.0 В | 1.5 В | 3.0 В | 0% (LOW)
3.6 В | 1.8 В | 3.6 В | 50%
3.9 В | 1.95 В | 3.9 В | 75%
4.2 В | 2.1 В | 4.2 В | 100%

⚠️ Максимум на D34 ESP32 = 3.3 В — не превышать!

Случайно сделал тарирование — как откатить +

Сайт → главная → кнопка «Отменить тару» — восстанавливает предыдущее значение из prevOffset в EEPROM.

Если кнопки нет (старая прошивка) — просто заново протарируй с правильной нагрузкой.

EEPROM карта адресов +

Адрес | Байт | Данные
0 | 4 | calibrationFactor (float)
4 | 4 | offset (long)
8 | 4 | lastSavedWeight (float)
12 | 1 | magic 0xA5
13 | 4 | alertDelta (float)
17 | 4 | calibWeight (float)
21 | 4 | emaAlpha (float)
25 | 1 | magic2 0xA6
26 | 4 | prevOffset (long) — для отмены тары
30 | 4 | prevWeight (float) — эталон дельты
40–63 | 24 | AP_PASS (Wi-Fi пароль)
64 | 1 | magic3 0xA7
313 | 4 | prevWeightDate (uint32_t Unix timestamp)
317–319 | 3 | autoSleepSec (uint16_t + magic 0xA8)
320–325 | 6 | lastReportWeight (float + magic 0xA9)
327–330 | 4 | lastTempC (float + magic 0xAA) — для TG fallback

Как обновить прошивку «по воздуху» (OTA) +

В Huge APP partition нет места под OTA — прошивка обновляется только через USB-C кабель и Arduino IDE.

Если хочешь OTA — нужно перейти на partition min_spiffs (1.9МБ кода, 1.9МБ OTA, 190КБ SPIFFS) и пересобрать прошивку.

## 🩺 Сначала — Экран 9 «Диагностика»

В v5 добавлен встроенный самотест. Кнопкой MENU прокрути до Экрана 8 — ESP32 проверит все компоненты по очереди и покажет OK / FAIL для каждого:

Компонент | Что проверяется | Если FAIL
HX711 | Отклик на запрос данных | Проверь DT (D16), SCK (D17), питание 3V3, целостность шлейфа
DS18B20 | 1-Wire ответ, температура ≠ −127 | Проверь резистор 4.7 кОм между DATA и 3V3, целостность кабеля
RTC DS3231 | I²C 0x68 + чтение времени | Проверь SDA/SCL, питание 3V3, батарейку CR2032
Battery | Напряжение на ADC (D34) в диапазоне | Проверь делитель R1/R2, контакт BAT+ от AS21

💡 Если все OK — железо в порядке, ищи проблему в Wi-Fi / Telegram / расписании.

## 📺 LCD не работает

#### LCD не отображает ничего или показывает квадраты ▮▮▮▮

- Питание: LCD требует 5 В на VCC. Подключи к VIN (от AS21), а не к 3V3
- Контрастность: отрегулируй синий подстроечный резистор на обратной стороне I²C-адаптера LCD (тонкой отвёрткой)
- I²C адрес: в коде LCD_ADDR = 0x27. На некоторых модулях — 0x3F. Загрузи I²C-сканер и проверь
- Распиновка: SDA → D21 (GPIO21), SCL → D22 (GPIO22)
- Подсветка не горит совсем — выпаянная или сгоревшая. Проверь джампер на адаптере (BL — backlight)

## ⚖️ Вес неправильный или 0.00

#### Вес показывает 0.00, мигает «*** OSHIBKA! ***» или Экран 9 пишет HX711 FAIL

- Распиновка: DT → D16 (GPIO16), SCK → D17 (GPIO17), VCC → 3V3, GND → GND
- Экран 9 (Диагностика): посмотри HX711 OK или FAIL
- Полярность: попробуй поменять местами A+ и A− тензодатчика — если вес уезжает в минус
- Тарирование: зажми MAIN на 3 сек → MENU=OK
- Если HX711 = FAIL — отключи питание, прозвони мультиметром все 4 провода (VCC, GND, DT, SCK). Чаще всего отвалился DT

#### Вес «прыгает» на ±0.5 кг

- Платформа кривая: поставь весы на ровную поверхность. Все 4 опоры должны нести нагрузку
- Помехи: HX711 чувствителен к электромагнитным наводкам. Не клади провода рядом с силовыми кабелями
- EMA-сглаживание: сайт → Настройки → EMA альфа = 0.1 (вместо 0.3) — сильнее сгладит, но медленнее реакция
- Питание HX711: подключи к 3V3, а не к 5В — на 3V3 шум меньше

#### Вес меняется на 0.5–1 кг при изменении температуры на улице

- Это особенность тензодатчика — он чувствителен к температуре. Калибруй при средней температуре сезона
- Используй компенсированные тензодатчики (класс C3, маркировка «temperature compensated»)
- Δ от эталона показывает относительное изменение — это не критично если фиксируешь эталон при той же температуре

## 🌡️ Температура DS18B20 неправильная

#### −127 °C или ошибка

- Резистор 4.7 кОм между DATA и VCC (3.3 В) обязателен. Без него датчик не отвечает — это самая частая причина
- Распиновка: DATA → D4 (GPIO4), VCC → 3V3, GND → GND
- Перепутаны GND и VCC: датчик греется и долго не работает (но обычно не сгорает за секунды)
- Длинный кабель в улей (>1 м) — pullup 4.7 кОм поставь ближе к датчику, не к ESP32

#### Температура не меняется (застряла на одном значении)

- Перезагрузи ESP32 (RST). Возможно завис драйвер OneWire
- Запусти Экран 9 (Диагностика) — он сделает свежий запрос
- Проверь что в улье действительно та температура — поставь рядом контрольный термометр

## 🕐 RTC DS3231 — RTC ERROR на Экране 5

#### «RTC ERROR» или время постоянно сбрасывается

- Села CR2032 — замени батарейку. Хватает на 5–10 лет, но могла прийти севшей
- Power LED + R5 на модуле — выпаяй их (см. «Подключение → DS3231»). Иначе батарея проживёт месяцы вместо лет
- I²C не отвечает: Экран 9 → RTC FAIL. Проверь SDA/SCL и питание 3V3
- После замены батарейки — синхронизируй время: сайт → Настройки → Sync NTP (или Serial команда SETTIME)

#### Время правильное, но расписание не срабатывает

- С v5.0.47 расписание работает через DS3231 Alarm2 + power-cut: SQW → D33 обязателен. Если SQW не припаян или CR2032 села — весы не проснутся по расписанию вообще
- Sleep guard 60 сек: если до следующего срабатывания меньше минуты, ESP32 не уходит в сон. Это нормально
- На Экране 6 счётчик пробуждений N должен расти после каждого срабатывания. Если N=0 после нескольких срабатываний — расписание не настроено или сохранено некорректно

## 📶 Wi-Fi не работает

#### Сеть BeehiveScale не видна

- ESP32 инициализируется 5–10 секунд после включения — подожди
- На Экране 6 LCD должно показывать W:OK
- Если включён режим STA (подключение к роутеру) — сети BeehiveScale не будет, ищи весы по IP в роутере
- Сброс Wi-Fi на дефолт: зажми MENU 5 сек на главном экране — Wi-Fi настройки сбросятся (AP / BeehiveScale / 12345678)

#### STA-режим: ESP32 не подключается к роутеру

- ESP32 поддерживает только 2.4 ГГц Wi-Fi. Если роутер двухдиапазонный — выдели отдельную SSID для 2.4 ГГц
- Проверь пароль (без опечаток, регистр учитывается)
- Если STA таймаут (10 сек) — ESP32 откатывается обратно в AP. Подключайся к BeehiveScale, проверяй настройки
- WPA3-only сети не поддерживаются — нужен WPA2 или WPA2/WPA3 mixed

## 📱 Telegram не приходит

#### Тестовое сообщение не приходит

- 401 Unauthorized: неправильный Token — перепроверь, без пробелов, без кавычек
- 400 Bad Request или chat not found: неправильный Chat ID, или ты не нажал /start в боте
- CONNECTION_REFUSED / CONNECTION_LOST: нет интернета или Wi-Fi не подключился — нужен режим STA
- Если приходят сообщения без жирного шрифта (теги <b> видны как текст) — обнови прошивку до v5.0.1+

Подробности — на странице «Telegram → Что может пойти не так».

#### Тест работает, но по расписанию ничего не приходит

- Сайт → Расписание — проверь что время задано
- Экран 5 LCD: время правильное?
- Экран 6: счётчик пробуждений N растёт после срабатывания расписания?

## 💤 ESP32 не просыпается из Deep Sleep

ℹ️ В v5 на ESP32 deep sleep работает железно (в отличие от ESP8266 v4.1, где была проблема с D0 = HX711 и нужна была перемычка GPIO16 → RST). Это была одна из главных причин миграции на ESP32.

#### ESP32 ушёл в сон и не возвращается

- Батарея < 3.0 В — защита DW01 на AS21 могла отключить банку. Подзаряди через microUSB AS21
- Кнопка RST на плате ESP32 — полная перезагрузка
- Экран 5: время на DS3231 правильное? Если RTC ERROR — расписание не работает
- Экран 6: N (счётчик пробуждений) растёт? Если нет — расписание не настроено или таймер сна некорректен. С v5.0.47 wake идёт по DS3231 Alarm2 (power-cut), а не по внутреннему таймеру ESP32
- USB-C в ESP32 подключён? При активном USB-сериал ESP32 не уходит в полный сон — отключи USB

## 💾 Прошивка не влезает в ESP32

#### Ошибка «Sketch too big» / «Not enough space» при загрузке

- В Arduino IDE → Инструменты → Partition Scheme: Huge APP (3MB No OTA / 1MB SPIFFS)
- По умолчанию выбрана Default Partition (1.31 МБ под код), а прошивка ~1.4 МБ — не влезает
- В PlatformIO добавь в platformio.ini: board_build.partitions = huge_app.csv

⚠️ Цена Huge APP: нет места под OTA — прошивка обновляется только через USB-C кабель. Для OTA нужен min_spiffs.csv partition (1.9 МБ кода / 1.9 МБ OTA / 190 КБ SPIFFS) и пересборка.

## 🔋 Батарея показывает неправильный заряд

#### Сайт показывает 0% при 100% батарее

- Проверь делитель R1+R2 (по 100 кОм). Прозвони мультиметром
- Проверь что BAT+ берётся с банки 18650 (3.0–4.2 В), а не с 5V_OUT AS21
- На D34 ESP32 должно быть ~2.1 В при полной батарее (4.2 / 2)
- На Экране 8 (Диагностика) → Battery должно быть OK

#### Ошибка ADC после обновления Arduino ESP32 Core 3.0+

- В Core 3.0 переименованы константы аттенюации: ADC_ATTEN_DB_11 → ADC_11db
- Если собираешь с Core 3.0 — обнови прошивку (или замени константу в Battery.cpp)
- Альтернатива — откатиться на Core 2.0.x в Менеджере плат

#### Батарея слишком быстро разряжается

- Auto-sleep работает? Сайт → Настройки → Авто-сон должен быть 180 сек, не 0
- Wi-Fi STA активен 24/7? Это жрёт ~80 мА — отключай после отчёта (в v5 это автоматически)
- Power LED на DS3231 не выпаян? Жжёт 200 мкА постоянно
- R5 на DS3231 не выпаян? Жрёт ток через CR2032
- Замени AMS1117 на HT7333 — спячка с 7 мА упадёт до 3 мА
- USB-C в ESP32 подключён? — мешает уходу в полный сон

## 📊 Нет данных в логе / графике

#### Лог пустой / график не строится

- В v5 лог хранится в LittleFS (внутренний flash ESP32), а не на SD-карте. SD-карты больше нет вообще
- Замеры пишутся по расписанию и перед уходом в deep sleep. Если расписание не настроено и ESP32 всё время активна — лог не пополняется
- Проверь: http://192.168.4.1/api/log — должен скачаться CSV. Если файл 0 байт — лог пуст
- Очистка лога: POST /api/log/clear — может ты случайно его очистил

#### График долго грузится / не обновляется

- /api/log/json имеет throttle 30 сек на сервере — чаще обновлять не получится (защита ESP32 от нагрузки)
- Если файл лога большой (>500 КБ) — ESP32 долго парсит. Очисти лог раз в сезон
- Открой полноэкранный график: /chart — на нём меньше JS

## 🛠️ Отвалилась кнопка / случайно сделал тарирование

#### Кнопка MAIN не реагирует

- Распиновка: D27 (GPIO27) ↔ GND. INPUT_PULLUP, без внешних резисторов
- Если кнопка работает только удержанием очень долго — возможно дребезг. В Settings.h увеличь BTN_DEBOUNCE_MS
- В v5 короткое нажатие MAIN ничего не делает (защита). Для тары нужно держать 3 сек + MENU=OK

#### Случайно сделал тарирование — как откатить

- Сайт → главная → кнопка «Отменить тару» — восстанавливает предыдущее значение из prevOffset в EEPROM
- Если кнопки нет (старая прошивка) — просто заново протарируй с правильной нагрузкой

## 📋 Контрольный список перед обращением за помощью

Прежде чем писать в issues — пройди по этому списку:

Шаг | Что проверить
1 | Версия прошивки = v5.0.67? (Serial команда STATUS или шапка сайта)
2 | Экран 9 «Диагностика» — все компоненты OK?
3 | Партиция = Huge APP (3MB No OTA / 1MB SPIFFS)?
4 | Библиотеки актуальные? Особенно ArduinoJson 6.x (НЕ 7.x!)
5 | Распиновка совпадает с схемой? (D16/D17 для HX711, D21/D22 для I²C, D27/D26 кнопки, D4 для DS18B20, D34 для батареи. D33 для SQW — задел на P3, в коде не используется)
6 | Питание стабильное? Проверь напряжение на VIN (должно быть ~5 В от AS21)
7 | Открой Serial монитор (115200) — есть подсказки в логе?
8 | Сделай STATUS и DIAG через Serial и приложи вывод к issue

💡 GitHub Issues: в репозитории есть .github/ISSUE_TEMPLATE/ — шаблоны для багов. Заполни как минимум: версия прошивки, что произошло, что ожидалось, вывод Serial.

## 📚 Полезные ссылки в документации

- Компоненты — список + где купить
- Подключение — схемы и таблица распиновки
- Настройка — pin defines, EEPROM-карта, partition
- Эксплуатация — кнопки, экраны, авто-сон
- Веб-интерфейс — REST API, разделы сайта
- Telegram — настройка через CF Worker
- Полное руководство (manual.html) — всё в одном файле
