darkvolg/BeehiveScale-ESP32/BeehiveScale/Connectivity.h

#ifndef CONNECTIVITY_H
#define CONNECTIVITY_H

#include <Arduino.h>

// Реальные секреты — в secrets.h (файл в .gitignore).
// Если файла нет, ниже подставляются плейсхолдеры.
#if __has_include("secrets.h")
  #include "secrets.h"
#endif

// ─── Настройки Wi-Fi ──────────────────────────────────────────────────────
#ifndef WIFI_SSID
#define WIFI_SSID        "YOUR_WIFI_SSID"
#endif
#ifndef WIFI_PASSWORD
#define WIFI_PASSWORD    "YOUR_WIFI_PASSWORD"
#endif
#define WIFI_TIMEOUT_MS  10000UL

// ─── Режим WiFi ───────────────────────────────────────────────────────────


// v5.0.67: mDNS-имя. Доступ по http://vesy.local без знания IP.
// Короткое (4 буквы) — влезает на LCD-экран IP вместе с подписью и легко набирается с телефона.
// Тем же именем представляется ArduinoOTA (порт в Arduino IDE).
#define MDNS_HOSTNAME    "vesy"

// Настройки точки доступа (AP mode)
#define AP_SSID          "BeehiveScale"
// AP password берётся из EEPROM через get_ap_pass()
#define AP_CHANNEL       1
#define AP_MAX_CLIENTS   4

// ─── Настройки NTP ────────────────────────────────────────────────────────
#define NTP_TIMEZONE         3
#define NTP_SERVER_1         "pool.ntp.org"
#define NTP_SERVER_2         "time.nist.gov"
#define NTP_SYNC_INTERVAL    3600000UL

// ─── Настройки Telegram ───────────────────────────────────────────────────
#ifndef TG_BOT_TOKEN
#define TG_BOT_TOKEN     "YOUR_BOT_TOKEN"
#endif
#ifndef TG_CHAT_ID
#define TG_CHAT_ID       "YOUR_CHAT_ID"
#endif
#define TG_ALERT_DELTA_KG   1.0f
#define TG_REPORT_INTERVAL  21600000UL

// ─── Настройки ThingSpeak ─────────────────────────────────────────────────
#define USE_THINGSPEAK   1
#ifndef TS_API_KEY
#define TS_API_KEY       "YOUR_THINGSPEAK_WRITE_KEY"
#endif
#define TS_CHANNEL_ID    0
#define TS_UPDATE_INTERVAL_MS  60000UL

enum WifiStatus { WIFI_DISCONNECTED, WIFI_CONNECTING, WIFI_CONNECTED };

struct UnsentData {
  float weight;
  float temp;
  float hum;
  float rtcTemp;
  char  datetime[20];
};

void       queue_add(float weight, float temp, float hum, float rtcTemp, const String& dt);
void       queue_process();

bool       wifi_init();           // Инициализация WiFi (AP или STA режим)
bool       wifi_connect();        // Подключение к роутеру (STA режим)
WifiStatus wifi_status();
void       wifi_ensure_connected();

bool       ntp_sync_time();
void       ntp_loop();

bool tg_send_message(const String &text);
// v5.0.26: refWeight — опорный вес для расчёта дельты в сообщении.
// При первом срабатывании = prevWeight (эталон); при повторе = lastAlertWeight.
bool tg_send_alert(float weight, float tempC, const String &datetime, float refWeight);
// prevWeight — пользовательский опорный вес (для долгосрочной дельты, "от эталона")
// prevWeightDate — Unix timestamp когда зафиксирован prevWeight (0 = не задано)
// lastReportWeight — вес на момент прошлого TG-отчёта (для дельты "за сутки")
// hasLastReport — false при самом первом отчёте, тогда "за сутки" не показываем
// v5.0.62: hasDailyGain — показать строку "Привес за сутки" (только вечерний замер).
// prevEveningWeight — вес вчерашнего вечернего замера (база для дельты сутки→сутки).
// eveningSlotMin — время вечернего слота в минутах от полуночи (для строки "вчера HH:MM →").
bool tg_send_report(float weight, float tempC, float humidity, const String &datetime,
                    float prevWeight, uint32_t prevWeightDate,
                    float lastReportWeight, bool hasLastReport,
                    bool hasDailyGain = false, float prevEveningWeight = 0.0f,
                    uint16_t eveningSlotMin = 0);
bool ts_send(float weight, float tempC, float humidity, float rtcTempC);

// v5.0.58: отправить задержанный TG отчёт с пометкой "Поздний"
bool tg_send_pending(uint32_t origUnix, float weight, float tempC,
                     float batV, uint8_t batPct, int8_t rssi);

#endif
