darkvolg/BeehiveScale-ESP32/(commit log)

2026-05-05 Initial commit: ESP32 port of BeehiveScale (forked from v4.2.12)
    Forked from BeehiveScale-main at v4.2.12-final-esp8266 (commit be9e1d2).
    Reason for fork: ESP8266 NodeMCU v0.1 / Lolin V3 cannot wake from deep
    sleep — verified through 5+ hours of testing on 2026-05-05 (see
    PHASE_2_DIAGNOSIS.md in BeehiveScale-main repo for full details).
    ESP32-WROOM-32 confirmed working: WakeTestESP32 minimal sketch
    auto-incremented Wake counter to 7+ via timer wakeup with no
    external D0->RST jumper or any extra components — deep sleep wake
    works out of the box on ESP32 silicon.
    Initial state in this commit:
    - Full code copied from BeehiveScale-main v4.2.12 as starting point
    - Version.h bumped to 5.0.0-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
2026-05-05 v5.0.0 — Полный port на ESP32 + Cloudflare Worker для Telegram
    Hardware bring-up за одну сессию: HX711, DS18B20, DS3231, LCD I2C,
    кнопки, deep sleep, web-панель, расписание. Pin mapping ESP32-WROOM-32.
    Ключевые добавления:
    - Cloudflare Worker relay для обхода блокировки api.telegram.org
    - Telegram отчёты привязаны к расписанию (не интервалу)
    - Кириллица + дельта (Эталон/Δ) в TG-сообщениях
    - Wake-grace для тарирования (первое нажатие при гашеном экране = просто будит)
    Ключевые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
2026-05-05 v5.0.1 — UX-доводка: двойная дельта + дата фиксации + auto-sleep + откат опасных оптимизаций
    Главное (поведение):
    - Двойная дельта в TG и web: «С прошлого замера» (авто) + «От зафиксированной точки» (ручная)
    - Дата фиксации опорного веса (Unix timestamp в EEPROM addr 313) + "N дн назад"
    - Auto-sleep timeout настраивается через сайт (новое поле, EEPROM 317-319)
    - Auto-return на главный экран через 20 сек бездействия
    - Wake-grace через sticky флаг — г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
2026-05-05 v5.0.3 — fix auto-sleep panic, return MEDIUM/LONG button, wake-press guard, separate MAIN/MENU thresholds
    - check_auto_sleep: webserver_stop() ПЕРЕД WiFi disconnect — иначе TCP-сокет на
    уже выключенном netif вызывал NULL pointer panic (PC=0x00000000) → SW reset
    вместо deep sleep. Ручной WiFi.disconnect/mode_off на ESP32 убран.
    - Возврат к MEDIUM/LONG логике MAIN (как в v5.0.0): SHORT не делает ничего,
    MEDIUM 3.0 сек = диалог "Tara? MENU=OK", LONG 6.0 сек = perform_calibration().
    - Wake-press guard (waitFirstReleaseMain) — после deep-sleep wake MAIN
    игнорируетс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
    [BeehiveScale.ino, Button.cpp, Button.h, Version.h]
2026-05-05 v5.0.4 — lastReportWeight в EEPROM (дельта "С прошлого замера" переживает reset)
    Симптом до фикса: после прошивки или любого reset плата теряет lastReportWeight
    (он жил в RTC RAM через SleepPersistData), и первый Telegram-отчёт приходит без
    строки "📈 С прошлого замера: ...". Видно отчёт 22:30 после прошивки v5.0.3 —
    есть только "От зафикс. точки", дельта от прошлого замера отсутствует.
    Фикс: lastReportWeight + hasLastReport дублируются в EEPROM (addr 320-325,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
    [BeehiveScale.ino, Memory.cpp, Memory.h, Version.h]
2026-05-05 v5.0.5 — fix температура в Telegram-отчёте после wake-up
    Симптом: после deep-sleep wake-up в Telegram-отчёт не попадала температура
    (строка "🌡 Температура: ..." пропадала). Видно в отчётах 20:40 и 22:40
    на 2026-05-05 — есть вес и дельты, нет температуры.
    Причина: tg_send_report отправляется в первые 5-10 сек после wake-up, к этому
    моменту DS18B20 ещё не успел сделать второе валидное чтение (первое всегда
    пропускается из-за power-on 85°C). sys.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
    [BeehiveScale.ino, Memory.cpp, Memory.h, Temperature.cpp, Temperature.h, Version.h]
2026-05-06 v5.0.6 — fix кнопочный отклик (меню/тара/калибровка)
    Корень: process_weight() блокировал loop до ~1.5 сек (HX711 wait_ready_timeout
    + get_units(5)). За это время read_button() не вызывался, и debounce-логика
    теряла нажатия / некорректно отсчитывала удержание.
    Симптомы:
    - Меню «заедает» при перелистывании (теряются SHORT_PRESS на MENU)
    - MENU LONG (возврат на 1/8) срабатывает позже 2.5 сек
    - Тара (3.0 сек) иногда не срабатывает даже при удержании ~10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
    [BeehiveScale.ino, Button.cpp, Scale.h, Version.h]
2026-05-06 v5.0.7 — fix мерцание LCD (dirty-check кеш строк)
    Корень: каждые 600мс при изменении веса process_weight() ставил
    sys.needsRedraw=true, и display_screen_*() переписывал обе строки LCD по
    I2C даже если текст не менялся. 32 байта × 100kHz I2C = видимое
    «мелкое мерцание» подсветки/символов.
    Fix: dirty-check кеш строк в Display.cpp.
    - lcd_set_cursor(lcd, col, row) — wrapper над lcd.setCursor(), отслеживает
    текущую позицию (_curCol, _curRow).
    - lcd_clear_buf(lcd) — wrapper над lcd.clear(), сбрасывае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
    [BeehiveScale.ino, Display.cpp, Display.h, Version.h]
2026-05-06 v5.0.8 — fix остаточное мерцание LCD (посимвольный diff + I2C 400kHz)
    После v5.0.7 пользователь сообщил что мерцание уменьшилось, но небольшое
    осталось. Источник: на главном экране каждую секунду тикают часы
    (HH:MM:SS) — изменяется 1 символ из 16, но dirty-check в v5.0.7
    переписывал всю строку (16 байт по I2C).
    Fixes:
    1. Display.cpp lcd_print_padded(): посимвольный diff. Находим минимальный
    диапазон [firstDiff..lastDiff] изменённых символов и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
    [BeehiveScale.ino, Display.cpp, Version.h]
2026-05-06 v5.0.9 — fix контрастность web-интерфейса (P3)
    Жалоба пользователя: на /settings описания справа сливаются с зелёным
    фоном, читать тяжело — приходится вплотную смотреть.
    Корень: CSS-переменная --text3:#506040 (тёмно-серо-зелёный) на фоне
    --bg:#0d0f0b даёт контраст ~3.5:1 — ниже WCAG AA (требуется 4.5:1 для
    обычного текста). Используется для всех "Описание" блоков и подсказок
    под полями ввода (font-size:13px;color:var(--text3)).
    Fix: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
    [Version.h, WebServerModule.cpp]
2026-05-06 v5.0.10 — web UI читаемее (шрифты, letter-spacing, контраст)
    После v5.0.9 пользователь прошил, скриншот показал что описания всё ещё
    тяжело читать. Корни:
    - 11-12px шрифты на uppercase лейблах с letter-spacing 1.5-2px дают
    визуально «худые» и редкие буквы
    - text3 даже после v5.0.9 (5.13:1) воспринимается тусклым на 11-12px
    - --text3 #7a8a68 → #8c9d80 (контраст vs --bg: 5.13 → 6.65, vs --panel: 4.77 → 6.18)
    - .card-title font-size 12px → 13px, letter-spacing 2px → 1px
    - .card-title span (acti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
    [Version.h, WebServerModule.cpp]
2026-05-06 v5.0.11 — web UI ещё ярче + дата на свою строку
    После v5.0.10 фидбек: текст всё ещё неярко + длинная строка с датой
    фиксации перенеслась на 2 строки в карточке "Текущий вес".
    - --text2 и --text3 → #a5b894 (контраст ~9:1 на --bg, PASS WCAG AAA).
    Text2 и text3 теперь одного цвета — иерархия упростилась до 2 уровней
    (--text для основного, --text2/3 для второстепенного), но всё хорошо
    читается. Можно потом вернуть иерархию если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
    [Version.h, WebServerModule.cpp]
2026-05-07 v5.0.12 — keepalive button + UI fixes (mobile header + Δ wrap + chart fonts)
    - feat: кнопка ☕ Продлить на 10 мин на главной странице. POST /api/keepalive
    отодвигает auto-sleep на +10 мин, в /api/data добавлено поле keepLeftSec
    с обратным отсчётом для UI.
    - fix: шапка не съезжает на mobile (.hdr-right была position:absolute, теперь
    static в @media max-width:760px).
    - fix: Δ не переносится в карточке Текущий вес (display:flex flex-wrap +
    white-space:nowrap для каждого блока значений).
    - fix: графики чита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
    [BeehiveScale.ino, Version.h, WebServerModule.cpp, WebServerModule.h]
2026-05-07 v5.0.13 — interactive chart cursor (mouse + touch)
    - feat: тач-скраб по графику показывает вертикальную линию + точку + tooltip
    с весом/температурой/напряжением и временем замера. Работает на mouse и
    touch (ontouchstart/ontouchmove/ontouchend), preventDefault блокирует
    скролл страницы при касании графика.
    - feat: графики занимают всю высоту контейнера (aspect-ratio:3/2 для mini,
    9/5 для charts). viewBox 900x600/900x500. Stats-блоки (Мин/Макс/Среднее)
    вынесены НАД chart-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
    [Version.h, WebServerModule.cpp]
2026-05-07 v5.0.14 — perf: chained fetches + log throttle (page loads instantly)
    - perf: ESP32 WebServer синхронный — параллельные fetch() от браузера
    сериализуются в случайном порядке. Если медленный /api/log/json (30+ сек
    стрим всего лога) попадает первым, дашборд не показывается пока лог не
    передан — отсюда задержка 40+ сек.
    - fix: fetchData теперь chain'ит запросы /api/data → /api/daystat →
    /api/log/json через .then(). Дашборд рендерится после первого ответа.
    - perf: th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
    [Version.h, WebServerModule.cpp]
2026-05-07 v5.0.15 — perf: HTML chunk size 4KB + SD stats cache
    - perf: PROGMEM chunks 512→4096 байт. На странице ~70КБ это сокращает кол-во
    TCP-пакетов и yield()-ов в 8 раз. Загрузка HTML на слабом WiFi с ~30 сек
    до ~3-5 сек. static char chunk[4096] чтобы не жечь стек ESP32.
    - perf: SD-статистика (log_size, log_free_space, log_using_fallback, log_fs_ok)
    в /api/data кешируется на 10 сек. LittleFS.usedBytes()/totalBytes() итерирует
    все файлы → 100-500мс на каждый поллинг. Теперь обновляется раз в 10 сек,
    остальн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
2026-05-08 docs: add PCB layout v1 (Excalidraw) — top-view component placement
    Минимальная версия платы 100×80mm под IP65 корпус. Все компоненты как в
    текущем breadboard-варианте у Геннадия:
    - ESP32-WROOM-32 DevKit V1 (38 пинов, на DIP-сокете)
    - LCD 16×2 I2C (PCF8574 backpack, 5V)
    - DS3231 RTC (3.3V, общая I2C шина с LCD)
    - HX711 load cell ADC (3.3V) + load cell pads
    - DS18B20 + 4.7kΩ pullup (1-Wire, 3.3V)
    - Кнопки MAIN (GPIO27) и MENU (GPIO26)
    - Делитель напряжения батареи 100k+100k → ADC GPIO34
    - Разъём для AS21 V6.0 (5V/GND/BAT+ для мониторинга)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
2026-05-08 docs: add comprehensive pinout table (hardware/pinout.md)
    Полная распиновка для перепайки на макетную плату:
    - Сводная таблица ESP32 GPIO (что куда идёт, цвета проводов)
    - По-компонентно (HX711, LCD I2C, DS3231, DS18B20, buttons, battery
    divider, AS21 power)
    - Карта питания (5V/3.3V/GND потоки)
    - Запрещённые пины ESP32 (SPI flash, strapping)
    - Рекомендуемая последовательность пайки от центра к краям
    - Замеры потребления по компонентам
    - Мнемоники для запоминания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
2026-05-11 v5.0.16 — feat: вкладка "Архив" + PWA
    Новая вкладка "📅 Архив" в веб-интерфейсе:
    - Выбор периода: date-range pickers (с/по) + пресеты (Сегодня, 3 дня, Неделя, Месяц, Всё)
    - Лента дней: одна карточка на день, цветной маркер аномалий (🔴 если падение > alert_delta)
    - Сводка периода: дельта веса, кол-во записей, разбивка по дням
    - Месячные группировки в ленте, дни недели
    - Скачивание CSV за выбранный период или весь лог
    PWA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
2026-05-11 v5.0.17 — feat: пресет "С прошлого визита" в Архиве
    Когда заходишь во вкладку 📅 Архив:
    - Автоматически подтягивается timestamp прошлого открытия web
    - Если визит был >1 дня назад — даты "с/по" сразу выставляются на интервал
    с прошлого визита по сегодня. Список загружается с этими параметрами.
    - Появляется кнопка "↩ С прошлого визита" + подпись "Прошлый визит: вчера в 18:42"
    (или "3 дн. назад" / "05.05.2026 (7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
2026-05-11 docs: memory/ + CHANGELOG для v5.0.16/5.0.17
    memory/ — индекс знаний проекта для будущих сессий (читается из LightRAG primary,
    файлы как fallback). Структура:
    - MEMORY.md — индекс с ссылками
    - project_current_state.md — текущая версия v5.0.17 + что работает
    - project_v5_archive_pwa.md — детали реализации Архив + PWA
    - backlog_features.md — что обсуждали но не сделали (графики в архиве, GSM, HTTPS)
    - user_profile.md — Геннадий, пчеловод, стиль работы
    - feedback_compact_session.md — прави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
2026-05-11 docs: update manual for v5.0.17 — Archive tab, PWA, HX711 SCK pullup
    - Bump version v5.0.15 → v5.0.17 across all docs (manual + 7 pages)
    - Add 📅 Archive tab description with presets (Today/3d/Week/Month/All/
    "С прошлого визита" highlighted as v5.0.17 feature)
    - Add 📲 PWA section with install instructions (Android Chrome / iOS Safari)
    - Add 8 new API endpoints: /api/period, /api/log?from=&to=, /api/last-visit,
    /archive, /manifest.json, /sw.js, /icon.svg + updated existing
    - Add critical hardware mod section: HX711 SCK pull-up 10kΩ → 3V3
    with explanation (D17 not RTC GPIO, goes Z in deep sleep, scale.power_down()
    ineffective without external pullup) and meas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
2026-05-11 docs(readme): полная переработка под v5.0.17 с логотипом
    - Логотип пчелы (SVG, тот же что используется в PWA-манифесте)
    - Заголовок с бейджами (version/platform/framework/license)
    - Описание проекта, история (ESP8266 v4 → ESP32 v5)
    - Список возможностей
    - Скриншоты (collapsible details)
    - Таблица компонентов с ценами
    - Распиновка ESP32 в виде ASCII-диаграммы с акцентом на pull-up SCK
    - Установка прошивки (Arduino IDE + PlatformIO)
    - 9-шаговый quickstart
    - Таблица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
2026-05-11 docs(readme): добавить английскую версию README + переключатель языков
    - Создан README.en.md — полный перевод на английский для международной аудитории
    - В шапку обоих README добавлен переключатель языков 🇷🇺/🇬🇧
    - Английская версия идентична русской по структуре:
    · О проекте + history (ESP8266 v4 → ESP32 v5)
    · Features (11 пунктов)
    · Screenshots (collapsible)
    · BOM с ценами в USD (~$25 total)
    · Pinout с акцентом на pull-up SCK
    · Installation (Arduin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
2026-05-11 docs(assets): добавить новый AI-сгенерированный логотип (PCB-пчела) + иконки
    Заменён простой геометрический logo.svg на профессиональный AI-логотип:
    - docs/assets/logo.png — главный логотип (PCB-пчела с трассировками платы
    и крыльями-сотами на тёмно-зелёном фоне). Используется в README hero
    обоих языков. 200×200 в README, исходник 832×832.
    - docs/assets/icon.png — минималистичная app-иконка (черная пчела на
    скруглённом медовом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
2026-05-11 v5.0.18 — chore: обновлена PWA-иконка под новый дизайн логотипа
    - BeehiveScale/Version.h: bump 5.0.17 → 5.0.18
    - BeehiveScale/WebServerModule.cpp _handleIcon():
    Заменён прежний простой SVG (3 чёрные полосы + 2 эллипса-крыла на
    оранжевом круге) на полноценный bee-symbol по образу docs/assets/icon.png
    (AI-сгенерированной минималистичной иконки):
    · Скруглённый медовый квадрат как фон (rx=36)
    · Голова пчелы с антеннами и точками
    · Овальное тельце с т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
2026-05-11 docs(assets): добавить social preview banner 1280×640
    GitHub social preview баннер для расшаривания в Telegram/Twitter/Discord:
    - PCB-bee logo слева на тёмно-зелёном фоне
    - Название "BeehiveScale ESP32" жёлтым крупно
    - Подзаголовок "Smart Beehive Monitoring · Open Source IoT"
    - 4 иконки фич: весы, термометр, Wi-Fi, Telegram
    - Сгенерирован через Google Gemini Imagen
    Размер 1280×640 (соотношение 2:1) — оптимально для GitHub social preview,
    Open Graph meta для соцсетей, превью в мессенджерах.
    Загружа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
2026-05-11 docs(assets): JPG-версия social-preview (150KB) для GitHub upload
    GitHub имеет лимит social preview 1MB. Оригинал social-preview.png
    весит 1.13MB (превышает лимит). Сжат в JPG quality 92 (visually
    identical) — 150KB.
    Используй social-preview.jpg для загрузки на GitHub Settings.
2026-05-13 v5.0.19 — feat: калибровка делителя батареи через сайт
    Проблема: BAT_DIVIDER_RATIO=2.0 был захардкожен. Реальные резисторы
    100к + ADC ESP32 имеют погрешность ±5-10% → показания отличаются от
    мультиметра на 0.1-0.3 В. У Геннадия: мультиметр 4.10 В, сайт 3.86 В.
    Раньше для фикса — править код и перепрошивать.
    Решение:
    - EEPROM addr 336-340 (magic 0xAC) хранит float ratio
    - Загружается при boot в bat_init() с валидацией 1.5-3.0
    - Дефолт 2.0 если EEPROM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
2026-05-13 v5.0.20 — feat: настраиваемые Telegram-алерты
    4 типа алертов, все настраиваются через сайт (вкладка Telegram →
    блок "Пороги алертов"):
    1. 🔋 Низкая батарея — порог в Вольтах (например 3.6В)
    "Низкая батарея! 3.58 В (18%). Пора зарядить."
    2. ❄️ Низкая температура — для зимовки (например -10°C)
    "Низкая температура! -12.3 °C. Проверьте улей."
    3. 🔥 Высокая температура — перегрев летом (например 38°C)
    "Высокая тем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
2026-05-13 docs(hardware): полная электрическая схема SVG
    Все узлы системы в одной картинке 1400×900:
    Часть 1: Зарядка от солнечной панели
    - Солнечная панель 5В/200мА → Type-C male (на проводе)
    - Type-C female (на корпусе) → ВНУТРЬ корпуса
    - Диод 1N5819 ПОСЛЕДОВАТЕЛЬНО в линию плюса
    (анод от Type-C, катод к TP4056)
    - Конденсатор 470µF электролит ПАРАЛЛЕЛЬНО между + и −
    (плюс к VIN, минус к GND — после диода)
    - TP4056 + DW01 + FS8205 (зарядка + защит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
2026-05-16 fix: _csrf() → _csrf_check() в новых endpoints v5.0.19/20
    Опечатка в _handleBatteryCalib и _handleAlerts при копировании
    паттерна из других endpoints. Правильное имя функции _csrf_check().
    Compile error:
    '_csrf' was not declared in this scope
    [WebServerModule.cpp]
2026-05-17 v5.0.21 — fix: отложенный WiFi (8с) + TX power 11dBm + modem-sleep
    Проблема: после wake-up ESP32 запускала всё одновременно — ядро,
    LCD, WiFi connect. Пик 600-700мА → MT3608 OCP защёлка → синий экран,
    нет Telegram. Симптом в улье: проснулась по расписанию, ничего не
    отправила, висит до следующего цикла.
    Решение программное (без перепайки):
    1. Отложенный WiFi init:
    - setup() сначала: датчики + LCD + splash + сообщение "WiFi cherez 8s.."
    - delay 8 сек (коротк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
    [BeehiveScale.ino, Version.h]
2026-05-17 v5.0.22 — fix: NTP sync на boot отключена (Guru Meditation на Core 3.0.7)
    Симптом из Serial Monitor:
    [NTP] Sync time...
    [NTP] Server: pool.ntp.org
    [NTP] Waiting
    Guru Meditation Error: Core 1 panic'ed (InstrFetchProhibited)
    ESP32 Arduino Core 3.0.7 имеет баг в configTime/getLocalTime —
    краш на NULL pointer при первом NTP-вызове после WiFi connect.
    Фикс: закомментировать ntp_sync_time() в setup() после WiFi connect.
    DS3231 RTC даёт точное время (±2 мин/год), NTP не критичен.
    Ручная синхронизация остаётся доступной через POST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
    [BeehiveScale.ino, Version.h]
2026-05-17 v5.0.23 — fix: ntp_loop() отключён + WiFi.setSleep(false)
    Из Serial Monitor v5.0.22:
    [Setup] Done
    [NTP] Got time: 2026-05-17 13:43:56
    [NTP] Time set to RTC!
    NTP всё равно срабатывал — ntp_loop() в main цикле сам инициализирует
    NTP при первом проходе. Отключение только в setup() недостаточно.
    Иногда отрабатывает успешно, иногда даёт Guru Meditation.
    Симптом второй: сайт открывается но /api/data не возвращается,
    страница не обновляет значения. Виноват WiFi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
    [BeehiveScale.ino, Version.h]
2026-05-17 v5.0.24 — fix: WiFi reset перед connect после deep sleep wake
    Симптом из Serial Monitor v5.0.23:
    [BeehiveScale v5.0.23] boot
    [Sleep] Wakeup #2 ← wake after deep sleep
    [RTC] OK
    [Temp] DS18B20 sensors found: 1
    [WiFi] Connecting to: Beeline⸮ ← обрыв
    Core 1 register dump: PC 0x400e999e ← Guru Meditation в WiFi-стеке
    Каждый wake (Wakeup #2, #3, ...) крашит на WiFi.begin().
    Первый POWERON boot работает чисто.
    Причина: после deep sleep WiFi-регистры/таблицы в RAM остаются от
    прошлой сессии. WiFi.begin() пытается их использовать,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
    [Connectivity.cpp, Version.h]
2026-05-17 docs(memory): сохранение контекста сессии 2026-05-13→17
    - project_session_2026-05-17.md: подробная сводка 7 версий v5.0.18-v5.0.24,
    hardware state, проблемы и решения, TODO для следующей сессии
    - project_current_state.md: обновлён до v5.0.24, актуальное железо в корпусе
    - MEMORY.md: добавлена ссылка на session-файл
    Также сохранено в LightRAG (lightrag_insert).
2026-05-18 docs(memory): пошаговая диагностика wake-up WiFi crash
    Добавлена секция «Пошаговая диагностика» в session-файл:
    - 10 шагов что пробовали (включая неверные гипотезы про MT3608)
    - Критический Serial Monitor лог с PC 0x400e999e
    - Что НЕ сработало (капы, замена банки, etc) — отвергнутые гипотезы
    - Что сработало (v5.0.24 WiFi reset)
    - Тестирование с USB+банка одновременно
    - Выводы для следующих сессий
    Также сохранено в LightRAG отдельной з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
2026-05-24 v5.0.46 — hardware power-cut + DS3231 self-latching + simplified TG
    Объединённый коммит за серию итераций v5.0.30→46 (одна сессия). Промежуточные
    версии не сохранены отдельно — финальная рабочая версия v5.0.46.
    ## Hardware (доплата power-cut)
    - AO3401 P-MOSFET + 4.7kΩ pullup (встроенный в DS3231 HW-084 module)
    - D1 (1N5819 SQW→Gate) и D2 (GPIO25→Gate) сняты — SQW напрямую к Gate
    - GPIO25 HOLD pin отключён — не используется
    - SW2 manual wake кнопка (Gate→GND)
    ## Software архитектура (v5.0.46)
    - DS3231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
2026-05-24 tools: standalone DS3231 diagnostic sketches (ESP32 + ESP8266)
    Изолированные тестовые скетчи для проверки DS3231 module вне основной схемы.
    Программируют Alarm1 на +10 сек, мониторят SQW pin и A1F/A2F/OSF flags.
    Полезны для отбраковки counterfeit модулей DS3231.
2026-05-24 hardware: power-cut доплата документация + схемы
    - POWER-CUT-INSTRUCTIONS.html/.md — инструкция пайки доплаты
    - schematic-hires.png/.svg — high-res электрическая схема
    - power-cut-final-v3.svg — финальная схема power-cut с AO3401
    - Gemini.png — reference фото
    - pinout.md — распиновка ESP32 + DS3231 module
2026-05-24 docs(memory): session logs 2026-05-18..24 — hardware power-cut journey
    Лог итераций по реализации hardware power-cut архитектуры:
    - 2026-05-17: апгрейд v5.0.18→24, фиксы wake-up WiFi crash
    - 2026-05-18: ESP32 deep sleep WiFi crash, итерации v5.0.27-29
    - 2026-05-20: переход на hardware power-cut v5.0.30, инцидент сгоревшей ESP
    - 2026-05-22: установка power-cut на новой ESP32, диагноз GPIO25 leakage
    - 2026-05-24: DS3231 self-latching через Alarm1 PerSecond → финал v5.0.46
2026-05-24 v5.0.45 — stable snapshot (14 мА, TG works, deep_sleep fallback)
    Snapshot работающей версии БЕЗ оптимизации 2 мА из v5.0.46.
    Использует:
    - HOLD через Alarm1 PerSecond (не отпускается полностью при sleep)
    - ESP идёт в esp_deep_sleep_start() через fallback
    - MOSFET остаётся ON в sleep → потребление ~14 мА
    - Wake через internal timer (не DS3231 alarm)
    Преимущества над v5.0.46:
    - Проще, меньше зависимости от DS3231 chip quality
    - Гарантированный wake через internal timer ESP
    - Не зависит от counterfeit detec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
2026-05-24 v5.0.46 re-apply — 2мА оптимизация поверх v5.0.45 snapshot
    Применяет фикс v5.0.46 (Alarm1 mode переключение PerSecond→A1_Hour
    в sleep_enter перед disable) поверх checkpoint v5.0.45.
    Эквивалент tag v5.0.46 (commit 095319b), но в линейной истории main.
    Откат:
    git checkout v5.0.45 → 14 мА, рабочая стабильная
    git checkout v5.0.46 → 2 мА (исходный 095319b)
    git checkout main → 2 мА (текущий HEAD)
2026-05-25 v5.0.47 — fix: восстановлен sleep_enter с DS3231 Alarm2 wake
    v5.0.46 баг: sleep_enter оставался v5.0.39 timer-only compromise,
    не вызывал rtc_set_alarm_in_seconds() → DS3231 alarm не программировался,
    fix Alarm1 mode в RTC_Module.cpp был бесполезен.
    Теперь sleep_enter полная sequence:
    1. WiFi shutdown
    2. rtc_set_alarm_in_seconds() — programm Alarm2 + переключить Alarm1 на A1_Hour + disable
    3. delay(1000) — MOSFET закрывается через ~100мс cap discharge
    4. Fallback esp_deep_sleep если hardware не сработал
    Sleep current ожидание: 2 мА (вмест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
    [SleepManager.cpp, Version.h]
2026-05-25 revert to v5.0.45 — HW-084 DS3231 партия бракованная, Alarm2 wake не fires
    После прошивки v5.0.47 подтверждено:
    - Power-cut MOSFET работает (sleep current 2 мА)
    - НО DS3231 Alarm2 не fires → ESP не просыпается → мёртвая до SW2
    Все 3 модуля HW-084 одной партии имеют этот дефект. Для 2 мА режима
    нужен другой DS3231 module (ZS-042 / Adafruit / WaveShare).
    Возврат на стабильный v5.0.45:
    - Sleep 14 мА (HOLD через Alarm1 PerSecond, MOSFET ON)
    - Wake через internal ESP timer (esp_deep_sleep_start)
    - TG приходит каж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
    [RTC_Module.cpp, SleepManager.cpp, Version.h]
2026-05-25 diag: fix SQW pin reading — INPUT_PULLUP вместо INPUT
    SQW DS3231 open-drain → без pullup pin плавает → digitalRead возвращает шум (LOW).
    ESP32 имеет внутренний pullup ~45kΩ — включаем через INPUT_PULLUP.
    Теперь idle SQW читается как HIGH, при alarm fire DS3231 sinks к LOW.
    [DS3231_Diag.ino]
2026-05-25 v5.0.47 PRODUCTION — 2 мА sleep работает с hardware fix
    Подтверждено в продакшене после серии тестов:
    - 7+ циклов auto-wake через DS3231 Alarm2 (rst:0x1 POWERON_RESET)
    - Sleep current 2 мА после выпайки всех LED
    - TG приходит каждый wake стабильно
    - Точность веса ±0.01 кг
    REQUIRED HARDWARE FIXES (без них не работает):
    1. Bypass cap 47 µF электролит + 100 nF керамика на VCC↔GND DS3231 module
    — поглощает voltage spikes при WiFi inrush 300мА peak.
    Без cap → brownout cycle при auto-wake (LCD моргает, ES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
    [RTC_Module.cpp, SleepManager.cpp, Version.h]
2026-05-25 v5.0.48 — feature: галочка TG-при-wake в Настройках веб-UI
    Добавлена опция управления TG в interval-mode (без расписания):
    - EEPROM addr 361 (magic) + 362 (bool), default ON
    - Memory.cpp: save_tg_on_interval() / load_tg_on_interval()
    - WebServerModule.cpp: checkbox в разделе Настройки (Параметры устройства),
    GET /api/config возвращает tgOnInterval, POST принимает
    - BeehiveScale.ino: проверка load_tg_on_interval() в loop()
    Поведение:
    - Расписание задано → TG всегда на scheduled wake (галочка игнор)
    - Расписан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
2026-05-25 v5.0.49 — UX: подсказка калибровки без упоминания TARA
    Раньше во время удержания MAIN на 3й сек показывалось 'Otpust = TARA!'
    - пользователь при калибровке думал что таре уже сработало и отпускал.
    Теперь:
    - 3-6 сек: 'KALIBR cherez Xs' (countdown до калибровки)
    - 6+ сек: 'Otpust = KALIBR'
    Тара по-прежнему срабатывает при release между 3-6 сек через диалог
    'Tara? MENU=OK' — функционал не убран, только подсказка не отвлекает.
2026-05-25 v5.0.50 — revert: подсказка калибровки как в v5.0.47
    Откат изменений v5.0.49 'KALIBR cherez Xs' countdown.
    Возврат к простой двухуровневой подсказке:
    - 3-6 сек: 'Otpust = TARA!'
    Галочка TG-on-interval (v5.0.48) сохранена.
    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
    [BeehiveScale.ino, Version.h]
2026-05-26 v5.0.51 — feature: battery + WiFi RSSI в TG отчёт
    Добавлены строки в tg_send_report:
    - 🔋 Батарея: X.XX В (XX%) — текущее напряжение и процент заряда
    - 📶 WiFi: -XX dBm — качество сигнала
    Помогает мониторить состояние весов удалённо:
    - Видишь когда батарея садится (планировать замену/зарядку)
    - Видишь качество WiFi (если -90dBm — сигнал плохой, могут быть проблемы)
    Иконки:
    - 🔋 при batPct >= 15%
    - 🪫 при batPct < 15% (предупреждение)
    - 📶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
2026-05-26 v5.0.52 — feature: детекция роения по падению веса
    Алгоритм:
    - Сравнивает current weight с persist.lastWeight (прошлый wake)
    - Если потеря >= threshold (3×alertDelta или мин 1.5 кг) за <30 мин
    → отдельный TG алерт 'РОЕНИЕ'
    - Anti-spam: один алерт за событие, сброс при стабилизации (delta < threshold/3)
    Возможные причины алерта (в сообщении):
    - Рой улетел
    - Кража улья
    - Падение/опрокидывание
    Файлы:
    - Alerts.h: новая функция alerts_check_swarm()
    - Alerts.cpp: реал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
2026-05-26 v5.0.53 — feature: MQTT клиент для Home Assistant Discovery
    Новая интеграция с HA через MQTT с автоматическим discovery:
    Files:
    - MQTTClient.h/.cpp — новый модуль, обёртка над PubSubClient
    - Memory.h/.cpp — MqttSettings struct + save/load (EEPROM addr 363-502)
    - WebServerModule.cpp — UI секция 'MQTT для Home Assistant' в Telegram странице
    + endpoints /api/mqtt/settings (GET/POST)
    - BeehiveScale.ino — вызов mqtt_publish_data() в loop после log_append
    - Version.h → v5.0.53
    После настройки broker + enable галочка → улей автоматически появит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
    [BeehiveScale.ino, MQTTClient.cpp, MQTTClient.h, Memory.cpp, Memory.h, Version.h, WebServerModule.cpp]
2026-05-26 v5.0.54 — fix: MQTT publish с retain=true
    v5.0.53 публиковал values без retain — broker не сохранял на диск.
    HA подписался на topics → 'Неизвестно' до next publish (30 мин).
    Фикс: добавлен retain=true ко всем publish (weight/temp/battery/rssi).
    Broker сохраняет last value → HA видит сразу при подписке + при перезагрузке.
    Discovery topics уже были с retain (правильно — конфигурация sensors).
    [MQTTClient.cpp, Version.h]
2026-05-26 v5.0.55 — fix: MQTT temperature force-read + fallback
    v5.0.54 не публиковал tempC в MQTT при первом wake — DS18B20 async-read
    не успевал до log_append (sys.tempData.temperature = -127).
    Фикс: перед mqtt_publish_data:
    1. Если tempC <= -90 → temp_force_read() (~750мс синхронно)
    2. Если всё ещё invalid → fallback на persist.lastTempC
    Та же логика что в TG отчёте — единообразное поведение.
    [BeehiveScale.ino, Version.h]
2026-05-26 v5.0.56 — feature: MQTT publish каждые 60 сек когда ESP active
    Раньше MQTT publish внутри log_append (раз в 30 мин) → пользователь видел
    старые значения в HA при настройке/калибровке/тарировании.
    - ESP active: дополнительный MQTT publish каждые 60 сек → real-time в HA
    - ESP в deep sleep: без изменений (ESP off, ничего не publish)
    - При scheduled/interval wake: log_append publish тоже работает (как было)
    Использует static unsigned long lastMqttTick для timing.
    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
2026-05-26 v5.0.57 — feature: настраиваемый интервал MQTT live publish
    Добавлено поле в UI:
    - 'Интервал live publish (сек)' в MQTT секции (Telegram странице)
    - Range 10-3600 сек, default 60
    - EEPROM addr 503 (uint16_t)
    - ESP active: MQTT publish каждые N сек (где N из настройки)
    - Sleep mode: не вызывается (ESP off)
    - Минимум 10 сек — защита от слишком частого publish (broker load)
    - Максимум 3600 сек (1 час) — больше не имеет смысла, log_append всё равно срабатывает
    - Memory.h: Mqtt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
    [BeehiveScale.ino, Memory.cpp, Memory.h, Version.h, WebServerModule.cpp]
2026-05-27 v5.0.58 — feature: TG retry с задержанным сообщением
    При fail tg_send_report() ESP сохраняет в LittleFS /tg_pending.bin:
    - unixtime (когда был замер)
    - weight, tempC, batV, batPct, rssi
    - retryCount
    При next wake (после WiFi+NTP) — tg_send_pending() форматирует
    с пометкой 'Поздний отчёт от HH:MM' и шлёт.
    Логика:
    - TG fail в 14:00 → save /tg_pending.bin
    - 17:00 wake → load → send late report 'от 14:00' → clear file
    - 17:00 TG (текущий) → send отдельно
    - Юзер получает 2 сообщения: задержанный + текущий
    Anti-loop: retryCou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
    [BeehiveScale.ino, Connectivity.cpp, Connectivity.h, TgPending.cpp, TgPending.h, Version.h]
2026-05-28 v5.0.59 — fix: TG не приходил по расписанию при power-cut
    БАГ: tgReportPending ставился только при schedLog (точное совпадение
    текущей минуты с расписанием). Но при power-cut каждый wake = cold boot
    (bootLog=true), а schedLog мог быть FALSE из-за timing:
    - DS3231 alarm будит в 8:00:00
    - boot + WiFi connect + NTP sync = ~5 сек
    - к моменту schedLog check currentTime мог проскочить 8:00 → 8:01
    - schedLog не совпал → tgReportPending не установлен → TG не отправлен
    ФИКС: if (bootLog && scnt > 0) tgReportPending = tru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
    [BeehiveScale.ino, Version.h]
2026-05-29 v5.0.60 — fix: двойная запись в архив + temp=0 в первой
    БАГ: на каждый scheduled wake создавались ДВЕ записи:
    08:00 → 8.56 кг · 0.0°C (schedLog, temp не готова)
    08:02 → 8.53 кг · 25.5°C (bootLog, дубликат)
    Причина:
    - schedLog срабатывал по минуте (cur_min == расписание) но НЕ ставил _bootLogDone
    - bootLog позже (HH:02) видел _bootLogDone=false → вторая запись
    - Первая запись с temp=0.0 (async process_temperature не успел прочитать DS18B20)
    ФИКС:
    1. if (schedLog) _bootLogDone = true → bootLog н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
    [BeehiveScale.ino, Version.h]
2026-05-29 v5.0.61 — feature: батарея (В) в архиве по дням
    Каждая запись архива теперь:
    08:00 · 8.53 кг · 25.5°C · 🔋3.82В
    Данные уже писались в CSV (колонка bat_v) — добавлено только отображение
    в JS рендере архивной страницы (e.b > 0.5 → показать вольты).
    Помогает видеть динамику батареи по дням прямо в архиве весов.
2026-05-29 v5.0.62 — feature: привес за сутки в TG + fix TG при ручном включении
    - Привес за сутки: вечерний замер (последний слот расписания, ±15 мин)
    сравнивается с весом вчерашнего вечера. Строка
    '🍯 Привес за сутки: +X.XX кг (вчера Y.YY)'. Вес хранится в EEPROM 505-511
    (magic+float+day uint16), переживает power-cut/reset как save_last_report.
    - FIX: ручное включение весов больше не шлёт TG-отчёт. bootLog ставит
    tgReportPending только если время boot в преде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
    [BeehiveScale.ino, Connectivity.cpp, Connectivity.h, Memory.cpp, Memory.h, Version.h]
2026-05-29 v5.0.63 — формат строки привеса под макет (вчера HH:MM → Y.YY)
    Строка привеса теперь показывает время вечернего слота и стрелку:
    '🍯 Привес за сутки: +X.XX кг (вчера 21:00 → 33.20)'. Время берётся из
    maxSlot (последний слот расписания), передаётся в tg_send_report новым
    параметром eveningSlotMin. Раньше было без времени: '(вчера 33.20)'.
2026-05-29 v5.0.64 — icon температуры в TG + fix дубль TG при перезагрузке
    - Иконка температуры в TG-отчёте: ❄️ (<8°C) / 🌡️ (норма) / 🔥 (>35°C),
    как у батареи. В обычном и задержанном (retry) отчёте.
    - FIX: software restart (web "Перезагрузить" / OTA) больше не шлёт boot-TG.
    Раньше перезапуск для проверки рядом со слотом (21:01 при слоте 21:00)
    проскакивал ±10-мин фильтр v5.0.62 и слал дубль отчёта. Теперь
    esp_reset_reason()==ESP_RST_SW подавляет boot-TG (пл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
    [BeehiveScale.ino, Connectivity.cpp, Version.h]
2026-05-29 v5.0.65 — вес округляется до десятых (0.1 кг) в отображении
    Везде в показе веса .2f/.toFixed(2) → .1f/.toFixed(1):
    - TG: отчёт, тревога, привес за сутки, дельты, задержанный отчёт
    - LCD: экран веса, экран дельты
    - Web: главная (вес/дельта/опорный), график (ось Y + тултип),
    архив (шапка дня, записи, Σ за период, Мин/Макс), статистика графика
    Причина: сотые (10 г) ниже реального шума тензодатчика улья (ветер,
    температур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
2026-05-30 v5.0.66 — fix дубль записей в архиве (08:00 + 08:02 на каждый wake)
    Каждое запланированное пробуждение давало 2 записи в CSV:
    - schedLog в loop() (строка 562) — точное время слота (08:00)
    - pre-sleep log в check_auto_sleep() (строка 1819) через 120 сек auto-sleep
    (08:02), с temp=0 если DS18B20 не успел.
    FIX: глобальный флаг g_logWrittenThisBoot, выставляется после первого
    log_append в loop. check_auto_sleep пишет pre-sleep лог только если
    g_logWrittenThisBoot==false (т.е. в этом boot ещё не пис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
    [BeehiveScale.ino, Version.h]
2026-08-16 v5.0.67 — IP на LCD, mDNS vesy.local, алерт батареи по умолчанию
    Прошивка:
    - Новый экран меню 7/9 — IP-адрес и mDNS-имя (display_screen_ip).
    Раньше IP печатался только в Serial, адрес приходилось искать в роутере.
    - Показ адреса на LCD 3 сек сразу после подключения к WiFi в setup().
    - mDNS-имя укорочено beehivescale -> vesy (MDNS_HOSTNAME в Connectivity.h),
    влезает в 16-символьную строку LCD. Тем же именем представляется ArduinoOTA.
    - MENU_SCREENS 8 -> 9, магические и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
2026-08-16 docs: третья кнопка SW2 WAKE + модуль power-cut в инструкции
    Юзер не помнил, зачем нужна третья кнопка на корпусе — и правильно,
    в документации её не было вообще: 0 упоминаний SW2, SW1, AO3401, MOSFET.
    Добавлено:
    - 04_operation.html — таблица "Все органы управления": MAIN, MENU,
    SW2 WAKE, тумблер SW1, EN/BOOT на плате DevKit. С объяснением, что
    SW2 не подключена к GPIO и почему при работающих весах не делает ничего.
    - 02_connection.html — SW2 в та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
2026-08-16 docs: слить pages/ в manual.html — одно руководство вместо двух
    Была ровно та проблема, из-за которой manual.html постоянно отставал:
    два параллельных руководства с дублирующимся содержимым. Правку надо
    было вносить дважды, про вторую половину забывали (v5.0.67 доехал
    только до pages/, manual.html остался с 8 экранами LCD).
    Теперь всё в manual.html — 12 вкладок, 84 раздела, 272 КБ, один файл:
    - Новая вкладка "🔍 Неисправно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
2026-08-16 docs(memory): правило «не трогать документацию» отменено — теперь ведём manual.html
2026-08-16 docs: электрическая схема с AO3401 и SW2 встроена в manual.html
    В руководстве не было ни транзистора, ни кнопки WAKE — повторить весы
    по нему было невозможно. Схемы лежали в hardware/*.svg и нигде не
    показывались.
    - hardware/schematic-hires.svg (полная схема: банка -> зарядка -> SW1 ->
    AO3401 -> Boost -> ESP32 и периферия) встроена инлайном во вкладку
    "Подключение".
    - hardware/power-cut-final-v3.svg (модуль ключа крупным планом с
    номиналами и точ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
2026-08-16 docs: банка 21700 4500 мАч подтверждена — пересчитана автономность
    Юзер подтвердил: в весах стоит 21700 на 4500 мАч, а не 18650 3000.
    Прошлые цифры автономии были посчитаны под 18650 и занижали срок.
    - Расчёт: 7.3 мА среднее × 24 ч = 175 мАч/сутки; 4500 × 70% usable =
    3150 мАч → ~17-19 дней с AMS1117 (было заявлено ~12) и 40-44 дня
    после замены LDO на HT7333 (было 30-40).
    - Обновлены все места: обзор, вкладка Расписание, таблица
    энергопо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
2026-08-16 docs: убрать 18650 из описания случая с разрядом (в весах 21700)
2026-08-16 v5.0.68 — дубли TG-отчётов, обрыв архива и CSV, причина сброса
    FIX дублей TG. Плата циклически перезагружалась, и каждый cold boot в
    окне ±10 мин от слота слал ещё один "отчёт при включении" — 14:00:19,
    14:02:39, 14:04:43, 14:06:02. tgSentSinceBoot живёт в RAM, persist.* в
    RTC-памяти (её стирает power-cut). Переживает только EEPROM: функции
    save/load_last_tg_report_unix написаны в v5.0.44, но не вызывались.
    Теперь метка пишется после успешной отправки и про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
    [BeehiveScale.ino, Version.h, WebServerModule.cpp]
2026-09-11 tools: конвертер CSV → цветной XLSX + автономность по факту, а не по расчёту
    CSV из Архива — голые цифры, 90 строк без единой подсветки. Добавлен
    tools/csv_to_xlsx.py (openpyxl): лист Сводка (период, вес, температура,
    расход батареи и остаток дней), лист Замеры (цветовая шкала веса,
    сине-красный градиент температуры, data-bar батареи с красной отсечкой
    на пороге алерта 3.6 В, колонка изменения к предыдущему замер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
2026-09-11 v5.0.69 — Excel с подсветкой прямо из весов
    Единственным экспортом был голый CSV — колонка цифр, где ничего не
    разглядеть. Раскрасить можно было скриптом tools/csv_to_xlsx.py, но он
    лежит на одном конкретном компьютере: подключишься с другого ноутбука —
    снова безликий CSV. Значит раскраска должна жить в самих весах.
    Новый эндпоинт GET /api/log/xls?from=&to= отдаёт HTML-таблицу с инлайн-
    стилями под именем beehive_<п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
2026-09-11 docs(memory): итоги сессии 11.09 — v5.0.69, автономность по факту, разбор vesy.local
2026-09-11 v5.0.70 — кнопка "Весь лог CSV" всегда отдавала 500 Cannot open log
    Веб-слой открывал файл сам: f = LOG_FS.open(LOG_FILE, "r"). Макрос LOG_FS
    на ESP32 указывает на SPIFFS, а лог пишется в LittleFS (Logger.cpp:
    _fs_open_read). Файла в SPIFFS нет — открытие падало всегда. Выгрузки за
    период и за дату работали, потому что идут через Logger; это и указало
    на причину.
    Полная выгрузка переведена на тот же путь: log_stream_csv_range с пустым
    диапазоном. Макрос L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
2026-09-12 v5.0.71 — Excel-выгрузка стала книгой из трёх листов
    В v5.0.69 весы отдавали раскрашенную таблицу на ОДНОМ листе, а скрипт
    tools/csv_to_xlsx.py делал четыре — юзер заметил разницу. HTML-формат
    иначе и не умеет: Excel хранит в нём каждый лист отдельным файлом.
    Формат сменён на SpreadsheetML 2003 (XML) — единственный, который держит
    несколько листов в одном файле и собирается на ESP32 обычной печатью в
    поток. Эндпоинт /a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
2026-09-12 docs(memory): v5.0.70 и v5.0.71, починенный vesy.local, приём проверки Excel через COM
